Kaelor9/EngineLink/hardware/README.md

# EngineLink hardware

The original editable **KiCad 8 schematic and PCB project** is now under [`hardware/kicad/`](kicad/README.md).

- [PCB design](kicad/ESP32-S3-WROOM-1-N8R8.kicad_pcb)
- [Electrical schematic](kicad/ESP32-S3-WROOM-1-N8R8.kicad_sch)
- [Project settings](kicad/ESP32-S3-WROOM-1-N8R8.kicad_pro)
- [Design rules](kicad/ESP32-S3-WROOM-1-N8R8.kicad_dru)
- [Interactive BOM / assembly viewer](kicad/bom/ibom.html)
- [Source checksums](kicad/SHA256SUMS.txt)

See [hardware documentation](../docs/HARDWARE.md), [schematic audit](SCHEMATIC_REVIEW.md) and [Gerber/PCB audit](PCB_GERBER_REVIEW_2026-11-05.md).

**Status:** Imported unchanged from the owner's ZIP on 2026-11-10. Original native files are available for inspection by Claude and other contributors. The files have **not** been subjected to a new independent KiCad ERC/DRC validation. Historic Gerber review does not guarantee manufacturing readiness. Do not fabricate a new revision without verifying the PCB, BOM, stackup, isolation and production outputs.
