Kaelor9/EngineLink/docs/STATUS.md

# Status and safety

EngineLink is alpha firmware on a revision 1 board. This page lists what has
been checked on real hardware, what has not, and the rules for connecting it
to engines.

## Safety rules

- Disconnect the engine networks and NMEA 2000 during first flashing and bring-up.
- Measure both isolated 5 V supplies against their own isolated grounds
  (4.75–5.25 V) before connecting an engine.
- EngineLink only listens at every boot. Reading the engines (KAD polling) is a
  deliberate step: close the connector's solder jumper (SJ1/SJ2) and switch it
  on under Settings → Diagnostics. "Read engines automatically" is off until
  you turn it on, with a confirmation.
- The only message EngineLink can send is the KAD read request
  `01 43 21 <index hi> <index lo> <checksum>`. There are no commands, no fault
  code clearing and no ECU programming, and there is no free-form transmit
  endpoint.
- Do not poll while a Volvo diagnostic tool (VODIA) is connected.
- Change the factory Wi-Fi password `12345678` in Settings. Anyone with the
  Wi-Fi password (or on the boat router's network) can change settings; there
  is no separate admin login. Up to 0.16.5 every response also carries
  `Access-Control-Allow-Origin: *`, so a web page open in your browser could
  read EngineLink data or send it commands; the 0.16.6 development build
  closes that (plan section 6.9) without adding a login (built, not yet
  tested on the board).

## Checked on the board

**2026-11-14 — the slow link was a busy channel; 0.17.5:** two ESP32 modules and three firmwares were slow on channel 6 and fast on channel 1 at −39 dBm (0.45 → 5.58 Mbit/s). **0.17.5** lets the own Wi-Fi pick the quietest of 1/6/11 by measuring other networks' air time, and re-checks with no phone joined ([plan section 19](WIFI_PLAN_2026-11-09.md)). On the board: Standalone chose channel 1 and gave 212 → 562 kB/s in 30 s; router mode on the home router (channel 1) ran 26 min with 784/784 pings and 1173 requests without a failure. *Bench-verified*, not boat-verified.

**2026-11-10 (night) — Standalone varies with the time since power-on; 0.17.4:** 0.17.3 (0.17.1's firmware) in Standalone after a cold power-on, no USB: 54–121 kB/s a minute after the start, 195–477 kB/s four minutes later; the same code gave 580–730 kB/s earlier the same day; memory fine. So the board's link changes by itself, also without the router. **0.17.4** adds the chip's temperature to the report (per speed test and per 30 s of a router session) to see whether speed follows it ([plan section 17](WIFI_PLAN_2026-11-09.md)). *Built*, not run on the board.

**2026-11-10 (night) — 0.17.2 on the board, 0.17.3:** 0.17.2 ran out of internal memory on the board (Standalone, 87 s: lowest free 0 KB, 109 failed allocations, 161–462 kB/s instead of about 650). Its PSRAM change is removed; **0.17.3 is 0.17.1's firmware** ([plan section 16](WIFI_PLAN_2026-11-09.md)). Router mode on the home router: joins from a clean start and stays, but slow (0.17.1); not fixed.

**2026-11-10 (night) — 0.17.1 on the board, 0.17.2:** 0.17.1 joined the home router 1.9 s after its start, **showed the app on the PC and was still joined after 654 s** (first time on that router), but answers from the router took 441–770 ms on average and the speed test and report page hung. **0.17.2** keeps the Wi-Fi's packet buffers in internal memory by taking all PSRAM for EngineLink's own pool at start ([plan section 15](WIFI_PLAN_2026-11-09.md)); whether PSRAM is the cause is not proven. ***Built*, not run on the board; internal memory headroom is unmeasured.**

**2026-11-10 (late) — 0.17.0 on the board, 0.17.1:** 0.17.0 on the home router joined in 376 ms at −40 dBm, answered 10 of 15 pings in the first 30 s and almost none after, delivered small answers in 3–6 ms and never the app page, and lost the beacons 305 s after the join (rc3 and rc6: 302 and 306 s). **0.17.1** restarts when the router is chosen, so the join happens straight after a start as in the owner's sketch, and the report says more per session ([plan section 14](WIFI_PLAN_2026-11-09.md)). ***Built*, not run on the board; the router is not fixed.**

**2026-11-10 — 0.17.0 released as a test version (owner's decision):** content = rc7, so that builds can be installed with the web installer. Not verified on the board; router mode on the home router is not fixed. The owner reports the board checked for cold joints and current and voltage on the oscilloscope during the day's tests with nothing wrong, so the IC5 suspicion below is not supported by measurement.

**2026-11-10 (late evening) — bench sketch on the board and 0.17.0-rc7:** a sketch without any EngineLink code (`tools/wifi-bench`) on the home router: 117 of 117 pings and the 110 KB page in 1.8 s at first, the same page in 15–16 s after 10 minutes at the same signal; the 802.11g-only variant flashed right after was nearly dead in 30 s. So the degrading link is not caused by EngineLink's code, the core version, PSRAM or 802.11n. Open suspicion: the 3.3 V regulator IC5 when warm (never measured under Wi-Fi traffic). **0.17.0-rc7** keeps rc5's station and lets a send wait 30 s instead of 5 s, so a slow link delivers the app page ([plan section 13](WIFI_PLAN_2026-11-09.md)). ***Built*, not run on the board; the router is not fixed.**

**2026-11-10 (evening) — rc6 on the board:** failed like rc3 ([evidence](test-evidence/wifi-0170rc6-2026-11-10/README.md)): joined in 593 ms at −40 dBm, small answers through the router in 3–8 ms, the 110 KB page failed 5 of 5, 30 of 153 pings answered and none under 10 ms, beacons lost after 306 s. Core version and PSRAM are cleared. The owner's sketch has only been tested with one small answer, so nothing tested separates it from EngineLink yet; `tools/wifi-bench` (large page + counted pings, optional 802.11g) is the next test ([plan section 12](WIFI_PLAN_2026-11-09.md)). **The router is not fixed.**

**2026-11-10 (late afternoon) — rc5 on the board and 0.17.0-rc6:** rc5 timed out from the PC on the home router (no report sent). The owner's sketch also works with OPI PSRAM (joined as `192.168.0.2`, page opened), and it was built with ESP32 core **3.2.0**, EngineLink with 3.3.12. **0.17.0-rc6** is rc5 built with core 3.2.0 ([plan section 11](WIFI_PLAN_2026-11-09.md)). ***Built*, not run on the board; the router is not fixed on this evidence.**

**2026-11-10 (afternoon) — rc4 on the board, the owner's sketch, and 0.17.0-rc5:** rc4 on the home router ([evidence](test-evidence/wifi-0170rc4-2026-11-10/README.md)) never joined: 23 attempts in 30 s with codes 2/4/15, then 202, after which the ESP32 core stopped reconnecting and EngineLink stood idle for 90 s; the router was heard at −51/−62 dBm in two scans; Standalone 566–682 kB/s. **Then the owner ran a plain Arduino sketch on the same board (`WiFi.mode(WIFI_STA)`, `WiFi.setSleep(false)`, `WiFi.begin()`, mDNS, `WebServer`) and the PC opened its page at `http://enginelink.local` through the home router** ([evidence](test-evidence/wifi-sketch-2026-11-10/README.md)): the board and that router can work together (one small page, briefly; not a stability test). **0.17.0-rc5** makes the station exactly that sequence and removes rc4's own radio settings and decisions ([plan section 10](WIFI_PLAN_2026-11-09.md)). ***Built* (local ESP32-S3 compile, host tests, source checks), not run on the board; the router is not fixed on this evidence.**

**2026-11-10 (midday) — rc3 on the board and rc4 as built:** 0.17.0-rc3 was run on the home router ([evidence](test-evidence/wifi-0170rc3-2026-11-10/README.md)): negotiated 802.11n **40 MHz** on channel 1 at −47 dBm with power save off, **3 of 152 pings to the router answered**, 10 web requests through the router answered by the server (the last at the moment the final 152 s of lost pings began), beacons lost after 302 s, a scan 10 s later heard 3 other networks and not the router; Standalone 550–720 kB/s. Found and fixed in **0.17.0-rc4** ([plan section 9](WIFI_PLAN_2026-11-09.md)): rc3 switched to the own Wi-Fi at once on a loss instead of after 2 minutes (a race), held the engine lock 1645 ms during a driver mode change, and recorded a wrong end code. rc4 puts the station on 20 MHz (Espressif's recommendation near other networks), tries 802.11g after a poor 802.11n session, leaves a dead "connected" link after a minute, and records every session, request and a radio sample. ***Built* (local ESP32-S3 compile, host tests), not run on the board; the router is not fixed on this evidence.**

**2026-11-10 (morning) — rc3 as built:** 0.17.0-rc2 was run on the home router on 2026-11-09 ([evidence](test-evidence/wifi-0170rc2-2026-11-09/README.md)): IP in 2 s at −47 dBm, the page still timed out from the PC, beacons lost by itself after 409 s; Standalone 577–689 kB/s. The whole chain was then reviewed ([plan section 8](WIFI_PLAN_2026-11-09.md)): the web server, its checks, routing, tasks and mDNS show no fault; the other device's packets do not arrive (below HTTP). Found in the source: rc2's first session ran with modem sleep on and later ones with it off; the stored RF calibration predates the IC5 repair. **0.17.0-rc3** turns station power save off in every session, renews the RF calibration once, accepts the router's DNS name, and makes EngineLink measure the link itself (pings to the router, HTTP through the router, a scan after a loss): ***built* (local ESP32-S3 compile and host tests), not run on the board; the router is not fixed on this evidence.** One 15-minute router session reads out as in plan 8.5.

**2026-11-09 — earlier state:** the last owner test (CI [run #261](https://github.com/Kaelor9/EngineLink/actions/runs/42631425052), `75faba4`, 0.16.6 built Nov 9 14:08:09, after the IC5 solder repair) showed Standalone serving the app at 540–746 kB/s while Router mode on the home 4G router associated, got `192.168.0.2` and then served nothing (pages and pings time out), lost the router's beacons after 539 s and did not see the router for 2 min ([evidence](test-evidence/wifi-0166-2026-11-09/README.md)). The review and the new plan are in [WIFI_PLAN_2026-11-09.md](WIFI_PLAN_2026-11-09.md); **0.17.0-rc2 implements it: *built*, not yet run on the board** (rc1 was bench-tested the same afternoon: standalone fine, the home router answered neither auth nor association requests, reasons 2/4/15, so rc2 runs the station on the driver's defaults exactly as the Prism controller, plan 2.2 revision 2). Verification is one bench session (plan section 5) that also separates the router, the place and the board, then the boat.

| Area | Result |
|---|---|
| J1708 receive | Bench loop: 36,000 frames in 30 minutes without errors |
| Both KAD300 engines | Read on the boat: rpm, fuel rate, temperatures, boost, battery voltage, gear learned |
| Fuel figures | First fill-ups within about ±8 % before calibration |
| microSD, status LED | Bench tested |
| Own Wi-Fi (standalone) | **Not usable on the boat with 0.16.5 (2026-11-05).** Phones join and get a DHCP lease in every boot, but the link EngineLink → phone fails: in four boots no TCP connection from the phone reached the web server at all, the AP logged the phone leaving with code 2 eight to ten times in a row followed by code 209 (SA Query unanswered), the phone re-asked DHCP, and the two speed tests that completed gave 60–72 kB/s at 215–307 ms. Seen on boat 12 V, on USB only, and worst with both (a power-on reset occurred when 12 V was connected while on USB). The main loop blocked 5.6–10 s in the web part each time (the core's write retry, a consequence, not the cause). Earlier: about 650 kB/s on 0.13.4 (2 Nov), 265–346 kB/s at 91–99 ms on 0.15.0 (4 Nov, USB). Cause open: RF environment (router channel), power path, firmware AP settings dropped in 0.16.2, or board. The 2026-11-06/09 bench runs after the IC5 solder repair served the app at 540–1 105 kB/s on the own Wi-Fi; the boat is not re-tested yet. |
| Router mode | Zyxel EX3600 (WPA2/WPA3 mixed): previously 500–630 kB/s on free channel. Field report [#126](https://github.com/Kaelor9/EngineLink/issues/126), v0.13.4: 12 test average 584.6 kB/s (457.8–665.3), round trip 18–20 ms. Still 95 Wi-Fi disconnect events / 48 pre-connection failures and about 50 seconds reconnecting, so long-term stability is NOT verified. 0.16.2 replaced the Wi-Fi with a simple version. 0.16.6 on the bench router (reported 2026-11-08): joins with IP at −42 dBm, small answers work, the app page (110 KB) fails after 20.5 s; 0.16.2 had dropped the station's 20 MHz and beacon-timeout settings, restored in the third 0.16.6 bench build; the owner's test of that build (2026-11-08) failed worse: `/`, `/api/live` and `.local` timed out, 1 of 10 pings answered, no report of the running build. Cause open (plan 13.6.1: EngineLink left the router, or stayed on it with heavy frame loss); the fourth bench build makes the report and SD log record which (*built*); the A/B idea was dropped. 2026-11-09 (`75faba4`, driver defaults with modem sleep on): association and IP, no page, no ping, beacons lost after 539 s. **0.17.0-rc2** (station on the driver's defaults as the Prism controller; the app page as a long transfer; dead Wi-Fi 2.0 code removed) is *built*; rc1's station profile (power save off, country DK, 20 MHz, all-channel scan) was bench-tested on 2026-11-09 and failed the same way (reasons 2/4/15); the one bench session in [WIFI_PLAN_2026-11-09.md](WIFI_PLAN_2026-11-09.md) section 5 decides between firmware, router, place and board. **rc2 on the board (2026-11-09 evening):** IP in 2 s, page timed out, beacons lost after 409 s. **rc3 on the board (2026-11-10):** 40 MHz negotiated, 3 of 152 pings answered, beacons lost after 302 s. **0.17.0-rc4** (station at 20 MHz, 802.11g after a poor session, dead-link exit; plan section 9) on the board (2026-11-10): never joined, codes 2/4/15/202. **A plain Arduino sketch on the same board served a page through that router (2026-11-10).** **0.17.0-rc5** (the sketch's station, rc4's radio settings and decisions removed; plan section 10) is *built*, not run on the board. |
| Firmware updates | Over Wi-Fi from GitHub and from a file, with rollback |

## Not yet checked

- Why the own Wi-Fi's downlink to the phone fails on the boat with 0.16.5 (2026-11-05): not yet separated between RF environment, power supply, the AP radio settings 0.16.2 dropped (20 MHz bandwidth, country, inactive time) and the board itself. Superseded by [WIFI_PLAN_2026-11-09.md](WIFI_PLAN_2026-11-09.md): the IC5 repair restored the own Wi-Fi on the bench; the boat is re-tested in plan section 5.5. Wi-Fi 2.0 Stage 4 (state machine, AP+STA) is dropped. The 5–10 s web stall is explained (Arduino core `NetworkClient::write()` retrying 10 × 1 s against a phone that does not acknowledge); the plan removes it by moving HTTP to `esp_http_server` (its own task) instead of patching the write. Firmware is reported as *built* (CI green, untested on hardware), *bench-verified* (owner ran plan section 5.2–5.3) or *boat-verified* (5.5 passed); this table says "verified on the board" only for the last.
- **0.16.6 development build (Wi-Fi 2.0 Stages 1–3): *built*, partially exercised on hardware (not yet fully bench-verified or boat-verified).** CI-equivalent checks pass locally (pinned core 3.3.12 compile, host tests `test_tracefold`, `test_httputil`, `test_wifistate` with plan 9.3's 20 scenarios, `test_wifi_contract.py`). The owner's 2026-11-06 bench tests exercised the access point radio settings (20 MHz, 600 s, country DK), the HTTP server, OTA boot confirmation, and three security responses (200/421/403); the remaining Stage 2 bench acceptance, including upload failure paths, complete export regression and latency checks, is still open. Evidence: [v0.16.6 owner bench report](test-evidence/wifi-0166-2026-11-06/README.md). (`docs/releases/v0.16.6.md`, plan 9.1/9.2). Not merged, not released. The 2026-11-06 fixes (engine lock let go during SD card work, 503 causes) ran on the board on 2026-11-08/09 without new stalls (longest engine wait 79 ms). **Hardware (2026-11-09):** a cold solder joint on IC5 (pins 5–8) was found and repaired; the 3.3 V rail and the own Wi-Fi's throughput were normal afterwards. It does not explain the router failures, which look the same before and after the repair.
- Router mode with the simple Wi-Fi (since 0.16.2) is not verified (see the router row: the app page failed on the bench router, fix *built*); it could not be tested on 2026-11-05 because the standalone link was already unreliable. The owner supplied Rigol DHO804 scope captures of 3.3 V under USB and laboratory input during Wi-Fi activity; no severe voltage collapse was demonstrated in those captures. The isolated maximum ripple reading is uncertain due to probe contact and dissimilar timescales. Combined USB+12 V interaction and full boat power/RF tests remain unmeasured; see [owner bench report](test-evidence/wifi-0166-2026-11-06/README.md).
- Long-term router stability across automatic router channel changes; #126 shows recovery after an outage but not why it occurred.
- Whether the small Trip summary CSV fix in PR #123 resolves Chrome/iPhone download failures.
- Whether retained crash history reflects any new crashes during extended v0.13.4 operation.

- KAD reply layout for every value: verified for the values above, not for all
  indexes ("Discover more values" should be re-run).
- Status bits in values 263/264 are not decoded yet. The gear and compressor bits are learned per boat by the drive test (0.14.0); their meaning is a hypothesis (see KAD300 / EDC I).
- Gear and clutch timing (0.14.0): checked against two recorded trips (replayed on a PC), not yet on the boat with the faster gear readings.
- Fault codes: no read command found among the PC tool's commands; "Discover more values" now covers 256–447.
- Fuel factor confirmed tank to tank.
- NMEA 2000 interface: isolation, termination and traffic not validated. Do not
  enable it until verified. 0.16 decodes navigation, depth, log, heading,
  temperatures, battery, rudder, wind and tanks, and lists every device on
  Diagnostics › GPS · NMEA 2000 › Devices and data. "Record the bus" saves every raw frame
  (10/30 min, /NMEA/BUS.CSV) to map everything the boat sends. Owner's boat:
  SmartPilot X10 and AIS700 on SeaTalkNG; ST60 is SeaTalk1, no converter seen.
  Not yet tested on the boat.
- Behaviour after a sudden power cut during SD writes.
- No battery-backed clock: without phone, router or GPS time, logs use uptime.

See also [KAD300 / EDC I](KAD300_EDC1.md), [engine test procedure](ENGINE_TEST.md)
and [hardware](HARDWARE.md).
