Kaelor9/EngineLink/docs/WIFI_PLAN_2026-11-09.md

# Wi-Fi plan, revision 2026-11-09 (replaces `docs/WIFI_REWRITE_PLAN.md`)

Status: **section 17 (2026-11-10 night) is the current state: Standalone's
speed also varies with the time since power-on; 0.17.4 adds the chip's
temperature to the report. Network code = 0.17.1.** Sections 1–9
stay as background; where section 10 differs, section 10 applies (it removes
rc4's link-check decisions, radio sample and scans of section 9). Written
after the owner's request of 2026-11-09 to re-examine the Wi-Fi 2.0
architecture from the evidence instead of continuing the stage plan. It supersedes `docs/WIFI_REWRITE_PLAN.md`
(branch `claude/wizardly-lovelace-v6tlqz`, draft PR #160) wherever the two
differ; the old plan stays in git history as background only.

Sources checked: the PR #160 source at `016bd16` (`wifi.ino`, `httpd.ino`,
`netsvc.ino`, `netreport.ino`, `wifistate.h`, `EngineLink.ino`), Arduino
ESP32 core **3.3.12** (`libraries/WiFi/src/STA.cpp`, `WiFiGeneric.cpp`),
ESP-IDF **release/v5.5** (`esp_wifi.h`, `esp_wifi_types_generic.h`, the
*Wi-Fi Driver* guide for ESP32-S3), the device reports #95, #126, #141, #143,
#162 and the bench evidence of 2026-11-06, 2026-11-08 and 2026-11-09.

---

## 1. What the evidence says

### 1.1 Every router session, side by side

| Date / firmware | Router | Channel, signal | Station settings | Result |
|---|---|---|---|---|
| 2026-11-02, 0.13.1 (#95) | home 4G router, 192.168.0.x | ch 6, −68 dBm | PS off, HT20, beacon timeout 20 s, TX 19.5 dBm | not found for 120 s after power-on; joined at 311 s; session ended as "router lost" |
| 2026-11-02, 0.13.4 (#126) | boat router (Zyxel), 192.168.1.x | ch 11, −39 dBm | same | 80 min online, 584 kB/s, one ~50 s outage (beacon loss → 201 ×N → back by itself) |
| 2026-11-04, 0.15.0 (#141, #143) | boat router | ch 11, −48 dBm | same | pings 1–3 ms, 0 % loss, 490–600 kB/s, 0 disconnects |
| 2026-11-06, 0.16.6 build 1/2 (#162, `ROUTER.txt`) | home 4G router | ch 1, 20 MHz negotiated | **PS off**, driver defaults | +69 s IP; EngineLink itself posted #162 to GitHub over HTTPS at +122 s; small replies to the PC worked, `/` (110 KB) failed; **beacons lost at +1174 s**, then 49 × 201 for 116 s, fallback |
| 2026-11-08, build 3 | home 4G router | ch 1, −42 dBm | PS off, HT20, beacon timeout 20 s | IP, but 1 of 10 pings answered, PC's ARP unanswered, every page times out |
| 2026-11-09, `75faba4` | home 4G router | ch 1, −59 dBm | **PS on (MIN_MODEM)**, driver defaults | not found for 118 s at boot; later associated in 422 ms, IP in 1.7 s, **no page, no `/api/health`, no ping** from the PC; **beacons lost 539 s after the IP**, 49 × 201 for 116 s, fallback |

Two facts stand out:

1. **Router mode has worked on this board**, for hours, on the boat router
   (0.13.4 and 0.15.0: station power save off, HT20, 20 s beacon timeout).
2. **On the home 4G router no build has ever served the page**, with power
   save on or off, with HT20 or the driver's default, with or without the WPA3
   wrapper and the TCP window patch. Every session there ends the same way:
   the station stops receiving (ARP/ping/TCP from the PC lost, beacons lost,
   reason 200), then 49 full scans in two minutes do not see the router at all,
   while the own Wi-Fi started right after hears the phone at −40 dBm, and the
   next attempt later finds the router in under a second.

### 1.2 Why the router link is obtained but HTTP does not work

Association and DHCP are short exchanges that the station starts itself. The
HTTPS report #162 (TLS handshake with GitHub, several kilobytes **received**)
proves that on 2026-11-06 the station's own TCP traffic worked through that
router at +122 s. What fails is traffic that **another device starts**: the
PC's ARP request, ICMP echo, TCP SYN. On 2026-11-08 one ping in ten was
answered; on 2026-11-09 none. A request that never reaches lwIP produces a
browser timeout, exactly what the owner saw (`ERR_CONNECTION_TIMED_OUT`, not
a refused connection and not a 421/403 from the server's own checks).

Nothing in the firmware can produce this selectively:

- `esp_http_server` binds `INADDR_ANY` and is started once (`httpd.ino:220`);
  it answers 1 676 external requests in the same boot in standalone mode and
  the loopback self-test passes in router mode. Its Host/Origin checks answer
  421/403; they cannot cause a timeout.
- lwIP routes replies on the interface that received the request; the idle AP
  netif (192.168.4.1) does not interfere with 192.168.0.x.
- No scan, mode change or driver call runs in router mode except
  `esp_wifi_sta_get_ap_info()` every 2 s (`wifi.ino:249`), which is a local
  read. The main loop's longest pass was 111 ms; the web server runs in its
  own task. There is no concurrency or timing path that drops received frames.

The one setting in `75faba4` that **does** match the symptom is modem sleep:
`WiFi.setSleep(true)` (`wifi.ino:197`, commit `b3ed536`), confirmed by
`"powerSave":1` in the report. `esp_wifi.h` says the default is
`WIFI_PS_MIN_MODEM`; the Wi-Fi guide says reception is then delayed to the
DTIM cycle, and `WIFI_PS_NONE` "minimizes the delay in receiving Wi-Fi data".
Espressif issue 12454 shows precisely "got IP, unreachable, `bcn_timeout`"
under `WIFI_PS_MIN_MODEM`. Modem sleep is therefore a real defect of the latest
build for a device that must answer unsolicited requests. **But it is not the
whole cause**: 2026-11-06 and 2026-11-08 failed with power save off.

### 1.3 Why the station later loses beacons

Per the Wi-Fi guide ("Wi-Fi Beacon Timeout", ESP32-S3): if no beacon arrives
within the inactive time (default 6 s, `esp_wifi_set_inactive_time()`), the
station sends 5 probe requests; with no answer it disconnects with reason 200.
So reason 200 means **the station heard nothing from the router for about
6–8 s**, at −59 dBm (2026-11-09) and −42 dBm (2026-11-08): not a weak-signal
value. The 49 × 201 that follow are the core's reconnect
(`STA.cpp:158–173`: `disconnect()` + `connect()` after every failure, a full
scan each ~2.4 s) finding **no beacon or probe response from that router on
any channel for two minutes**, until the 120 s fallback starts the own Wi-Fi.
The same two-minute blindness appears at power-on (#95 and 2026-11-09) and
ended both times by itself.

Scanning runs with the radio awake, so power save cannot explain the two
minutes. No firmware activity runs during them either. What remains is below
the firmware's logic: the radio downlink from that router to this board at
that bench. Three candidates are consistent with all sessions:

- **R1, the router's 2.4 GHz radio**: a 4G router (TP-Link Archer MR600,
  dual band) whose 2.4 GHz radio restarts, moves channel (auto) or is held
  back by LTE/Wi-Fi coexistence, while the PC and the iPhone stay on 5 GHz
  and notice nothing. The owner has not yet checked which band the PC uses.
- **R2, the place**: interference at the board's position on channel 1 (the
  4G router's own LTE uplink bursts next to 2.4 GHz, USB 3.0 noise from the PC
  the board was attached to, or a neighbour). Time-varying, so sessions differ.
- **R3, the board's receive path**: a sensitivity loss (antenna matching, RF
  keepout, a supply transient under receive) that −40 dBm from a phone a metre
  away hides and −59 dBm from a router does not. The IC5 repair restored the
  3.3 V rail and standalone throughput; it says nothing about receive margin.

None of these is a firmware fault, and no firmware change can repair any of
them. Section 5 shows how one bench session tells them apart without a single
extra firmware build.

### 1.4 Firmware defects found (real, but secondary)

| # | Defect | Where | Effect |
|---|---|---|---|
| F1 | Modem sleep on in router mode | `wifi.ino:197` | Delayed or missed unsolicited frames; a documented cause of unreachable stations (1.2) |
| F2 | Country set only when the AP starts; the station runs in world-safe "01" after a boot straight into router mode | `wifi.ino:118–123` only in `apRadioSetup()`; `applyNetwork()` resets the driver with `WiFi.mode(WIFI_OFF)` (`WiFiGeneric.cpp:319–331` deinitialises it) | A Danish router on channel 12 or 13 is found slowly or not at all; the PHY init data differs between the two modes |
| F3 | Report prints the 3-byte country code as a C string | `netreport.ino:242`, `wifi.ino:115` | The `DK ?\x01\x06\x14\x01` garbage in every report (stack over-read, harmless otherwise) |
| F4 | `wifistate.h` state machine (Standalone / Router test / Router join / Router / Router lost, AP+STA idle station, "looks", return tests) built and host-tested but never wired in | `wifistate.h`, `tools/test_wifistate.cpp`, plan Stage 4 | Dead code and a planned architecture (AP+STA, channel-switch announcements to joined phones) that addresses none of the observed failures and adds risk |
| F5 | Leftovers of 0.15.0: `netpolicy.h`, `routerguard.h`, `linktune.cpp/.h`, `routerProbing`, `staRetryFails`, `driverNudges`, `staBssidKnown` and the "Rescue looks" report block, all unused or always 0 | `EngineLink.ino`, `webapi.ino`, `netreport.ino` | Noise in the report and the code the owner asked to keep simple |
| F6 | The report calls the fallback "Recovery" and the JSON `mode:"rescue"`, as if it were a third mode | `netreport.ino` | Contradicts the two-mode product; the mechanism itself is right |
| F7 | 110 KB app page sent from the single server task in one `httpd_resp_send()` | `httpd.ino` (plan I9, left open) | On a lossy link one stalled `/` blocks every other request for up to the send timeout; explains "small replies work, `/` fails" on 2026-11-06. Not a cause of the link failure |

Not defects (checked and cleared): the `esp_http_server` configuration and
adapter, the engine mutex discipline (server task releases it around every
send), the main-loop timing, mDNS (its failure on the PC is a consequence of
the lost downlink; it starts correctly 2 s after each IP), the OTA self-test
(a loopback request confirms the image, so a bad router link cannot trigger a
rollback), the 120 s fallback and 10 min return logic.

---

## 2. Decision

### 2.1 Architecture

- **Keep** the Arduino core 3.3.12 build with Espressif's components used
  directly (`esp_wifi`, `esp_netif`, `esp_http_server`, `mdns`, OTA). The
  server rewrite works and is not part of the problem.
- **Keep two user-selectable modes only**: Standalone (AP only) and Router
  (STA only). The automatic fallback to the own Wi-Fi after 120 s without an
  IP, and the automatic return while no phone is joined, stay **as a recovery
  mechanism**, named so in the report and the app, never as a mode.
- **Drop Wi-Fi 2.0 Stage 4** as designed: no `WIFI_AP_STA` idle station, no
  router test with the AP up, no periodic "looks", no `wifistate::Machine`.
  The simple exclusive-mode `wifi.ino` of 0.16.2–0.16.6 is the right size for
  the product; its only shortcoming is the station profile (F1–F2).
- **Station = the ESP32 driver's defaults, as the Prism controller** (2.2,
  revision 2). No setting on the station interface at all. No linker
  wrappers, no private lwIP, no custom SAE.

### 2.2 The station: the Prism controller's connection path (revision 2, 2026-11-09 evening)

**Why revised.** The rc1 bench report (built 15:37:56) on the home 4G router:
49 × 201 at boot, then after the app's Connect about 24 × reason 2
(AUTH_EXPIRE: auth request sent, no answer), 6 × reason 4 (association
request sent, no answer), 2 × 15 (EAPOL 3/4 never arrived), 1 × 202. Per the
Wi-Fi guide's connect phases every one of these is "EngineLink sent, the
router's answer never arrived". The owner reported that the Prism controller
(`Kaelor9/Marine-RGB-Light-Controller`, the same ESP32-S3-WROOM-1-N8R8
module, Arduino core latest at build time) joins the same router without
trouble, and asked for Prism's connection method in router mode.

**Comparison on the actual code** (Prism `connectWiFi()`/`setup()`/`loop()`;
WiFiManager 2.0.17 `autoConnect` → `connectWifi` → `wifiConnectDefault` →
`WiFi.begin()` → `waitForConnectResult`; EngineLink `applyNetwork()`,
`serviceNetwork()`, `onWiFi()`):

| Step | Prism (effective, after WiFiManager) | EngineLink rc1 | rc2 |
|---|---|---|---|
| Init | `WiFi.mode(WIFI_STA)`, `setHostname`; WM turns Wi-Fi **OFF** again (hostname branch) and `enableSTA(true)` | `WiFi.mode(WIFI_OFF)`, `persistent(false)`, `setHostname`, `WiFi.mode(WIFI_STA)` | same in effect, kept |
| Country | `WiFiSetCountry()` skipped (`_wificountry==""`): driver default "01" | `esp_wifi_set_country_code("DK",true)` on the station | **removed on the station**; the AP keeps DK |
| Power save | driver default `WIFI_PS_MIN_MODEM` | `WiFi.setSleep(false)` | **removed** |
| Bandwidth, scan | driver defaults (40 MHz allowed, fast scan) | HT20 + `WIFI_ALL_CHANNEL_SCAN` | **removed** |
| Credentials | `persistent(true)` only when saving; `WiFi.begin()` uses the driver's NVS config | `persistent(false)`, `WiFi.begin(ssid,pass)` from EngineLink's settings | same for the driver (`esp_wifi_set_config` + `connect`), kept |
| Reconnect | the core's (`setAutoReconnect(true)`) | the core's | same, kept |
| Events | WM's `WiFiEvent` (status only) | `onWiFi()` (counters/trace only, no Wi-Fi calls) | same in effect, kept for the report |
| Waiting for an IP | blocking 10 s (`setConnectTimeout`), else portal → `ESP.restart()` | non-blocking in `serviceNetwork()`; 120 s without an IP → own Wi-Fi (recovery), retry every 10 min | **not transferred**: EngineLink must not block engine reading or restart; recovery kept |
| mDNS | `MDNS.begin` once after the IP | `startNameService()` 2 s after GOT_IP, restarted on a network change | same in effect, kept |
| Web server | Arduino `WebServer` after the IP, `handleClient()` in the loop | `esp_http_server`, started once, all interfaces | kept (one server in both modes) |
| While connected | nothing polls the driver | `esp_wifi_sta_get_ap_info()` every 2 s | **removed**; the signal is read only when a report or the app asks |
| Standalone | WM captive portal | EngineLink's SoftAP, `apRadioSetup()` | unchanged |

Transferred: the bare driver defaults on the station, nothing polling the
driver while it connects, the core's reconnect, mDNS after the IP. Not
transferred: WiFiManager (portal, blocking wait, restart), NVS-stored
credentials (no RF effect), WM's event handler.

**Critical assessment.** The chance that this alone fixes the home router is
low: `75faba4` (2026-11-09 morning) already ran the driver's defaults with
modem sleep on and failed the same way. What rc2 gives is final: a router
path identical to a device known to work on the same module. If it still
fails identically, the firmware's connection path is excluded with
certainty and the board, its supplies or the place remain (section 5.4,
hardware path). If it works, one of the small differences mattered and the
code is simpler. Prism's core version is "latest at build time": if Prism was
built on core 2.x (IDF 4.4), the driver version is a real difference and one
EngineLink build on that core is the next software step.

---

## 3. Implementation plan (one build, in this order)

Branch: `claude/awesome-newton-sazag1`, which merged `claude/wizardly-lovelace-v6tlqz`
(PR #160) so the `esp_http_server`, OTA self-test, SD lock work and evidence
stay together.
Version string `0.17.0-rc1`, then `0.17.0-rc2` (revision 2 of 2.2), with the
build time in the report, so bench evidence can never again be attributed to
the wrong binary. rc2 replaces P1 below: `staRadioSetup()` is gone and the
STA branch is `WiFi.mode(WIFI_STA); WiFi.setAutoReconnect(true);
connectRouter();`; the 2 s signal polling is gone (`routerSignalSample()` in
`netreport.ino` reads `WiFi.RSSI()` on request).

| # | Change | Files | Acceptance (host/CI unless marked) |
|---|---|---|---|
| P1 | **Station profile.** New `staRadioSetup()` with the three calls of 2.2 and `WiFi.setScanMethod(WIFI_ALL_CHANNEL_SCAN)`; called in `applyNetwork()` right after `WiFi.mode(WIFI_STA)`, before `connectRouter()`. Remove `WiFi.setSleep(true)`. `apRadioSetup()` unchanged. | `wifi.ino` | `test_wifi_contract.py`: the four calls present in `staRadioSetup()`, called between `WiFi.mode(WIFI_STA);` and `connectRouter();`; `setSleep(true)` absent anywhere. Report line "Power save: off" in router mode (bench). |
| P2 | **Country once per driver start, both modes.** Move the `countryIsDK()` check into a helper used by both `apRadioSetup()` and `staRadioSetup()`; fix the buffer to `char cc[4]` in `wifi.ino`, `netreport.ino` and `ApLink` (`model.h:451`). | `wifi.ino`, `netreport.ino`, `model.h` | Report prints `Wi-Fi country (driver): DK` with no trailing bytes (bench). Contract: no `char cc[3]` in the firmware. |
| P3 | **Remove the dead Wi-Fi 2.0 Stage 4 and 0.15.0 leftovers.** Delete `wifistate::Machine` and `tools/test_wifistate.cpp` (keep `traceFold`, renamed `tracefold.h`, with its test); delete `netpolicy.h`, `routerguard.h`, `linktune.cpp/.h`, the link-tune task, `routerProbing`, `routerProbe*`, `staRetryFails`, `driverNudges`, `staBssidKnown`, `routerReturnFailed`, the "Rescue looks" and "Radio test" report blocks and their JSON fields (`linkTune`, `routerProbes`, `routerProbeSeen`, `retryFails`, `driverNudges`, `failedReason/Phase/AfterMs`). Update `validate.yml` accordingly. | `wifistate.h`, `tools/`, `EngineLink.ino`, `webapi.ino`, `netreport.ino`, `.github/workflows/validate.yml` | CI green; `wifi.ino` < 300 lines (`test_wifi_simple.py`); the app's network page still renders with the demo (`tools/build_demo.py`, Playwright). |
| P4 | **Name the recovery mechanism honestly.** Report `Mode: Router (router not reached, EngineLink Wi-Fi on meanwhile)` and JSON `mode:"router", recovery:true`; the app shows the same text where it now says Recovery/rescue. Behaviour unchanged: fallback after 120 s without an IP, return every 10 min while no phone is joined, "Connect" in the app forces a new attempt. | `netreport.ino`, `webapi.ino`, `firmware/ui/app.html` → `tools/build_ui.py` | `test_wifi_simple.py` keeps `120000UL` and `routerHold=true`; demo shows the new text; no new settings (D7). |
| P5 | **`/` as a long transfer.** Register `/` with `R_ASYNC` so the 110 KB page streams from the xfer task in chunks with `engineMx` released, and raise the xfer queue to depth 2 so a second phone loading the page is not refused. All other routes unchanged. | `webapi.ino`, `httpd.ino` | `test_wifi_contract.py`: `/` listed as a long transfer; `curl` of `/` and `/api/live` in parallel both complete (bench). |
| P6 | **Docs.** `HANDOVER.md` Wi-Fi section rewritten to the two modes + recovery + station profile (short); `docs/STATUS.md` router row = "bench pending 0.17.0-rc1"; `docs/TODO.md` Wi-Fi block replaced by a pointer to this plan; `docs/WIFI_REWRITE_PLAN.md` reduced to a one-paragraph pointer here; `docs/releases/v0.17.0.md` drafted. | docs | Links valid; no router name, token or password in any file. |
| P7 | **CI contract update.** `test_wifi_contract.py` adjusted to P1–P5 (drop the `staRadioSetup` prohibition and the `wifistate::Machine` checks; keep: no `lwip/priv`, no `__wrap_`, no `--wrap`, no `WiFi.`/`esp_wifi_` in the event callback, no secrets in prints, core pinned to 3.3.12). | `tools/test_wifi_contract.py` | Mutation check: re-adding `setSleep(true)` or removing the country call must fail the test. |

Estimated size: about 150 lines changed in firmware, about 600 lines removed.
No change to storage formats, calibration, trips, engine code, OTA or the
installer.

Rules for the implementer: one PR, no further A/B binaries, no new diagnostic
features beyond fixing F3, no station setting outside 2.2 without the owner's
written approval, D14 kept (no Wi-Fi call from the event callback, printing
never blocks).

---

## 4. The hardware finding

The IC5 cold joint explains the earlier 3.3 V and standalone-throughput
variability (65–1 048 kB/s before the repair, 540–1 105 kB/s after). It is
recorded as fixed in `docs/HARDWARE.md` and `docs/STATUS.md` (P6). It does
**not** explain the router failures: they look the same before and after the
repair, and the 2026-11-08 session failed at −42 dBm.

The plan therefore does not assume the board is cleared. Section 5 separates
the board from the router and the place in the same session that verifies the
firmware. If the board is implicated (outcome C below), the next step is
hardware work from `docs/HARDWARE.md` (antenna matching and keepout, a scope
on 3.3 V during a router session), not another firmware version.

---

## 5. Verification: one build, one bench session, then the boat

### 5.1 Before the session (owner, 5 minutes, no firmware involved)

1. On the Windows PC on the home router: `netsh wlan show interfaces` and
   note **Radio type, Band/Channel**. If the PC is on 5 GHz, its good
   experience says nothing about the 2.4 GHz radio EngineLink uses.
2. Router admin page, read only, no changes: 2.4 GHz channel setting
   (auto/fixed), channel width, whether Smart Connect / band steering, Airtime
   Fairness or AP Isolation are on, and the system log. Keep a screenshot.

### 5.2 The session (owner, about 40 minutes, firmware 0.17.0-rc2 from CI)

Board at its usual bench position, lab supply, **not** USB-attached to the PC
(USB 3.0 noise is one of the R2 candidates). Start these on the PC first and
leave them running the whole time:

```bat
ping -t 192.168.0.2 > ping.txt
```

```bat
:loop
echo %time% >> scan.txt
netsh wlan show networks mode=bssid | findstr /i "SSID BSSID Signal Channel" >> scan.txt
timeout /t 10 > nul
goto loop
```

Then in the app: Router mode, the saved home router. Within the first
5 minutes, from the PC: 20 × `http://192.168.0.2/api/live`, 10 × `http://192.168.0.2/`,
3 × `http://enginelink.local/`. Let it run to 30 minutes, then save the Wi-Fi
report and `/WIFI.LOG` from the SD card.

In the same session, as a control, put the Prism controller (another ESP32,
driver defaults) on the same router at the same spot and `ping -t` it from
the PC for 15 minutes.

### 5.3 Pass criteria (all required)

| Criterion | Pass |
|---|---|
| Pings to EngineLink | ≥ 99 of 100 answered in any 100-ping window |
| `/api/live` | 20 of 20 within 2 s |
| `/` | 10 of 10 complete within 5 s |
| `enginelink.local` | resolves on the PC (if Windows lacks mDNS, the IP checks count) |
| Report | 30 min, 0 unexpected disconnects (no reason 200), 0 fallbacks, `Power save: off`, country `DK`, `802.11n 20 MHz` |
| Standalone | unchanged: page loads, speed test ≥ 500 kB/s at −40 dBm |

### 5.4 Reading a failure (one session decides, no further builds)

| Outcome | What `scan.txt` and the Prism control show | Conclusion | Next step |
|---|---|---|---|
| A | The PC also lost the router's 2.4 GHz BSSID, or saw it change channel, around EngineLink's beacon loss; Prism dropped too | R1, the router's 2.4 GHz radio | Firmware is done. The owner decides about the router (it is the test case, not the target, D30); the boat test proceeds |
| B | The PC saw the 2.4 GHz BSSID steady on channel 1 at good signal; **Prism also** lost pings at that spot | R2, the place | Move the bench position once; firmware unchanged; boat test proceeds |
| C | The PC saw the BSSID steady; **Prism stayed at 100 %** while EngineLink failed | R3, the board | Stop firmware work. Hardware investigation per section 4 |
| D | Everything passes | profile + link fine | Boat test (5.5), then release 0.17.0 |

### 5.5 Boat (the real acceptance)

One trip with the boat router: the same criteria as 5.3 from the iPhone
(`/api/live` via the app, `/` three times, 30 min without a fallback),
plus one router power-cycle: reconnect within 60 s after the router is back,
no fallback when it returns within 2 min. Standalone checked once on the same
day. Release 0.17.0 only after this.

---

## 6. Out of scope (deliberately)

- No AP+STA concurrent operation, no router test while the own Wi-Fi is up,
  no "Router is back, switch now?" prompt (D19/D20 withdrawn with Stage 4).
- No new report fields, radio tests, channel surveys or link tuning.
- No changes to the router, its channel or security as a requirement.
- No change to the `esp_http_server` adapter beyond P5.
- No Option B (IDF project with Arduino as a component): the two exceptions
  that motivated it are gone.

## 7. Open risks

- If the bench ends in outcome C, the fix is hardware and its schedule is
  unknown; the firmware plan still stands as written.
- `WIFI_ALL_CHANNEL_SCAN` adds about one second to each join; with the core's
  reconnect that is one second per retry while a router is away.
- Windows mDNS varies by version; the IP must always work, the name is a
  convenience.

---

## 8. 2026-11-10: the whole chain reviewed after rc2, and 0.17.0-rc3

Owner's instruction (2026-11-10): stop planning, take over, examine the whole
chain from radio to web app, treat "the page opens" as the goal and not
"associated with an IP", and implement with documented APIs only. Evidence:
[rc2 report](test-evidence/wifi-0170rc2-2026-11-09/README.md).

### 8.1 The chain, layer by layer

| Layer | Checked | Result |
|---|---|---|
| Association, WPA2 | report: 319–876 ms, twice | works |
| DHCP | 1.6 s, `192.168.0.2`, lwIP's ARP check passed | works |
| EngineLink's own outbound IP | 2026-11-06: a report reached GitHub over HTTPS through this router | works |
| ARP from another device | 2026-11-08: Windows printed "Destination host unreachable" from its own address = its ARP request got no answer. lwIP answers ARP itself in its task, no EngineLink code is involved; the core also sends a gratuitous ARP every 60 s (`CONFIG_LWIP_ESP_GRATUITOUS_ARP=y`) | **fails intermittently: the request does not arrive** |
| ICMP | 2026-11-08: 1 of 10 answered, 18 ms | **fails** |
| IP routing | two interfaces, the own Wi-Fi's 192.168.4.0/24 is down in router mode; replies leave on the interface of the router's subnet | no fault found |
| TCP port 80 | one `esp_http_server` started once in `setup()`, bound to every address (`INADDR_ANY`), never stopped; a network change only closes sessions (`httpdSuspend()`); it serves the own Wi-Fi again after each router session in the same start, so the listener survives the changes | no fault found |
| HTTP checks | wrong `Host` → 421, foreign `Origin` → 403, POST without `X-EngineLink` → 403: all are **answers**; none can produce a timeout. 0 refused in the report | no fault found |
| Port 443 | nothing listens; lwIP answers a connection attempt with a reset at once | by design |
| mDNS | `MDNS.begin` 2 s after each IP, restarted on a network change; queries are multicast and travel like the ARP request | depends on the same reception |
| Tasks, locks | Wi-Fi task priority 23 and lwIP 18 on core 0; engine tasks 3–4 with a yield every pass; web server in its own task on core 1; longest main-loop pass 175 ms; the event callback makes no Wi-Fi call | no starvation path |
| Web app | never reached: the browser gets no TCP connection | not involved |

So the browser's timeout is **missing network traffic, not a missing HTTP
answer and not the web app**: frames from the router do not reach EngineLink's
IP stack reliably, while frames EngineLink asks for itself mostly do. The same
reception fails completely for 6+ s when the beacons are lost, and the 49
scans that follow hear nothing of that router for two minutes.

Why Standalone works and Router does not: in Standalone the phone is a metre
away, EngineLink sets the pace on its own channel (6) and every frame is
addressed and acknowledged. In Router mode everything another device starts
arrives via the router, first as a broadcast (ARP, mDNS) that the router sends
once, unacknowledged, at its lowest rate, right after a beacon. That is the
part of the link that is failing.

### 8.2 What was wrong in rc2 (found in the source, not guessed)

1. **The station's power save differed between sessions.** rc2 made no
   power-save call on the station, but the access point setup calls
   `WiFi.setSleep(false)`, the core stores it (`WiFiGeneric.cpp:784`) and
   applies the stored value at every station start (`STA.cpp:122`). A start
   straight into router mode ran modem sleep **on**; any session after the own
   Wi-Fi had been up ran it **off**. In the rc2 report the modem-sleep session
   lost the router by itself after 409 s (and the 2026-11-09 morning build
   with modem sleep on after 539 s); the session without ran 769 s until the
   owner switched the router off, and 1105 s on 2026-11-06. Too few sessions
   to prove a cause, but modem sleep makes a server depend on catching one
   specific beacon for every incoming packet, on a link whose beacons are the
   very thing being lost.
2. **The report's "Power save" and HTTP figures could not be attributed.**
   The power-save line was read in access point mode, and the HTTP counters
   mixed the router, the own Wi-Fi and the self-test. "4 send failures" and
   "slowest `/` 10.9 s" may be a page trickling over the router or sessions
   closed by a network change; rc2 cannot say.
3. **The RF calibration is older than the regulator repair.** The driver
   calibrates the radio in full once, stores the result and reuses it at every
   start ("partial calibration", Espressif's RF calibration guide). The stored
   data was made while IC5 had a cold solder joint and the 3.3 V rail was
   unstable. Updates over Wi-Fi keep it. Whether it is bad is unknown; it is
   the one radio input that was never renewed after the repair.
4. **`http://enginelink/` was refused.** Many routers register the DHCP host
   name in their own DNS, so the bare name (or `enginelink.lan`) resolves on a
   PC where `.local` does not; the `Host` check answered 421.
5. **CI's version check rejected `-rc2`** (`validate.yml` allowed letters only
   after the dash).

### 8.3 `http://` and `https://`

EngineLink serves HTTP on port 80 only, in both modes, and the address is the
same in both: `http://enginelink.local`. Nothing in the firmware or the app
redirects to or expects HTTPS. Current browsers try `https://` first for a
typed name and fall back to `http://` when port 443 is refused; EngineLink
refuses at once, so on a working link the fallback takes milliseconds. On a
link that drops packets the refusal is lost too, the browser waits out its
HTTPS attempt and the address bar keeps the `https://` it tried. That is the
most likely source of "it seemed to need https": the same lost packets, seen
through the browser's upgrade. A certificate for a local name is not possible
without warnings, so HTTPS on the device is not the conventional answer;
making the link carry packets is.

`.local` needs multicast between the PC and EngineLink. It fails when the
router isolates wireless clients (guest network, "AP isolation"), when a VPN
or firewall on the PC blocks UDP 5353, or when the link drops the multicast.
The IP address always works when the link does, and with 8.2 item 4 so does
the name the router's own DNS gives (`http://enginelink/` on routers that
register it). The report shows the last router IP for that purpose.

### 8.4 0.17.0-rc3 (implemented 2026-11-10)

| # | Change | Kind |
|---|---|---|
| R1 | Station power save **off** in every router session: `WiFi.setSleep(false)` right after `WiFi.mode(WIFI_STA)`. Everything else on the station stays the driver's default | fix (8.2 item 1) |
| R2 | The stored RF calibration is discarded **once** (`esp_phy_erase_cal_data_in_nvs()`, flag in NVS `el_radio/cal`), so the first start of rc3 calibrates in full on the repaired board. Settings and data untouched | fix on a hypothesis (8.2 item 3) |
| R3 | `Host`/`Origin` accept the board's name bare and with `.lan`, `.home`, `.home.arpa`, `.internal` (none can be registered on the internet, so the DNS-rebinding defence holds; host-tested) | fix (8.2 item 4) |
| R4 | **Link check:** while on the router EngineLink pings the router every 2 s (`esp_ping`, lwIP's documented API) and keeps sent/answered/average/longest/most lost in a row, with the signal at the start, lowest and last (read every 30 s) | measurement |
| R5 | **Router session record**, kept after the session and written to `/WIFI.LOG`: duration, end code, the router as the driver saw it (channel, 20/40 MHz, b/g/n, negotiated standard, ciphers), the station's real power save | measurement |
| R6 | **HTTP by network:** connections, requests, answers and failed sends that came in through the router, separate from the own Wi-Fi and the self-test | measurement |
| R7 | **One scan 5 s after a fallback:** networks heard, strongest other, the router heard or not | measurement |
| R8 | CI's version check accepts `-rc3` | CI |

New file `netdiag.ino` (R2, R4, R5, R7); it makes no call that changes how the
station connects (`test_wifi_contract.py` enforces this). Not changed: the two
modes, the 120 s fallback and 10 min return, the web server, the app, storage.

### 8.5 What one router session with rc3 decides

Router mode on the home router for 15 minutes, try the page from the PC a few
times (`http://enginelink.local`, then the IP), then fetch the Wi-Fi report
(on the router if the page opens, otherwise on the own Wi-Fi afterwards). No
ping scripts, no router settings. The block "ROUTER LINK AS ENGINELINK
MEASURED IT" then reads:

| Pings to the router | Through the router | Scan after a loss | Meaning | Next |
|---|---|---|---|---|
| ≥ 99 % answered, page opens | requests answered | – | fixed by R1/R2 | boat test (5.5) |
| ≥ 99 % answered | **0 connections** | – | link fine both ways, but the PC's packets never arrive: client isolation on the router, the PC on a guest/other network, or the PC itself | compare with a phone on the same Wi-Fi; no firmware cause |
| ≥ 99 % answered | connections, failed sends | – | small packets pass, a page does not: transfer problem on the link | look at the negotiated standard/40 MHz in the record |
| many lost, or runs of losses | few or none | router heard | radio link between this board and this router is bad in both tests of it | the two checks in 8.6 separate router from board |
| lost, then code 200 | – | **neighbours heard, router not** | the router's 2.4 GHz radio stopped answering; EngineLink's receiver works | router side; firmware done |
| lost, then code 200 | – | **nothing heard at all** | EngineLink's receiver is deaf at that moment | board (hardware), not firmware |

Not decidable without the session: whether R1 and R2 are enough on this
router. Green CI proves the build, not the link.

### 8.6 Two checks that need no firmware (5 minutes each, optional)

- **A phone hotspot as the router** (iPhone: "Maximise compatibility" on =
  2.4 GHz): EngineLink in router mode on the hotspot, the PC on the same
  hotspot. The page opening there shows the whole router-mode path of the
  firmware working (DHCP, ARP, mDNS, HTTP on the station) and leaves the home
  router's radio link as the difference.
- **Own Wi-Fi on channel 1** (the home router's channel) instead of 6, then
  the app's speed test: clearly worse than on channel 6 means channel 1 is
  bad at the board's place or for the board.

---

## 9. 2026-11-10: the rc3 report, what it proves, and 0.17.0-rc4

Evidence: [rc3 report](test-evidence/wifi-0170rc3-2026-11-10/README.md).
Owner's instruction: go to the bottom of it, fix what can be documented,
extend the report so that further hypotheses need no new firmware, and keep
documented faults, probable explanations and hypotheses apart.

### 9.1 What rc3 measured on the home router

One router session of 302 s (+278 s to +581 s), power save off, RF
calibration renewed, signal −47 dBm from the first reading to the last:

- **Negotiated 802.11n 40 MHz** (router on channel 1, second channel above,
  i.e. 2402–2442 MHz); pairwise CCMP, group TKIP (the router runs WPA/WPA2
  mixed).
- **3 of 152 pings to the router answered**, in 355–633 ms. The longest run
  of losses, 76 pings = 152 s, ends at the beacon loss, so it began at
  581 − 152 = **429 s**.
- **10 connections and 10 requests through the router**, the last at
  **429 s**; 9 answered 2xx, no failed send, slowest request of the whole
  start 112 ms.
- Code 200 at +581 s; a scan 10 s later hears 3 other networks (strongest
  −50 dBm) and not the router.

So the link was not "98 % random loss". It carried traffic in a window that
ended at +429 s (the web requests and the few answered pings), then nothing
for 152 s **while the beacons still arrived** (the driver disconnects about
6 s after the last beacon), then the beacons stopped too, and 10 s later the
router was not heard while three other networks were.

### 9.2 Documented faults (found in rc3's report and source; fixed in rc4)

| # | Fault | Evidence | Fix |
|---|---|---|---|
| 1 | **The own Wi-Fi came on at once when the router was lost, instead of after 2 minutes of the core's reconnects.** `serviceNetwork()` read `now`, then the event task set `staDownSince` a millisecond later; `(uint32_t)(now-staDownSince)` then is about 49 days and passes `>=120000`. rc3 widened the gap by ending the measured session between the two | no 201 retries after +581 s in the event list, scan at +591 s (5 s after a fallback), "fallbacks 2" | signed comparison; contract test |
| 2 | The session's end code read 36 instead of 200: the loop saw the loss before the driver's event carried the reason | report: "ended with code 36", last event code 200 at the same millisecond | the reason and the signal at the loss are taken from the event and attached 300 ms later |
| 3 | **1645 ms in the network part with the engine task waiting for the lock.** The network part's only calls of that length are the driver's mode changes (`WiFi.mode()` in `applyNetwork()` and around a scan); they ran with `engineMx` held. rc2's longest was 161 ms. Which call it was is not in the rc3 report; the mode change of fault 1, issued while the core had just started its reconnect, is the likely one | report: network 1645 ms, engine wait 1645 ms "lock held by loopTask" | the lock is let go around every `WiFi.mode()` (they touch no shared data); every step of 100 ms or more is now recorded by name |
| 4 | "9 of 10 answered" counted only 2xx, so a 304 looked like a failure, and nothing said which addresses were asked, how many bytes went out or whether a connection was used again | rc3 report | request log and counters by network (9.5) |
| 5 | A router session with a dead link stayed "online" for minutes: no page through the router and no own Wi-Fi either | 152 s without one answered ping before the driver gave up | link check acts (9.4) |

### 9.3 Probable cause of the dead data path, and the hypotheses left

**Probable (acted on): the 40 MHz link.** Beacons are sent on the primary
20 MHz channel at the lowest rate and arrived for 302 s at −47 dBm; data
frames in an 802.11n 40 MHz link use both halves, and the upper half
(around channel 5) overlaps whatever the neighbours on channels 3–9 send,
one of them at −50 dBm at the board. Espressif's Wi-Fi driver guide
("Wi-Fi HT20/40") says: "if the device is used in some special environment,
e.g., there are too many other Wi-Fi devices around the ESP32-S3 device, the
performance of HT40 may be degraded. So if the applications need to support
same or similar scenarios, it is recommended that the bandwidth is always
configured to HT20." EngineLink needs under 1 MB/s; a marina is such an
environment. rc4 sets the station to 20 MHz.

What speaks against 40 MHz being the whole story: on 2026-11-06 the link
negotiated 20 MHz and small answers worked but the page did not; rc1 had
20 MHz and never got an answer to its authentication. So 20 MHz is expected
to help and is not proven to be enough.

**Hypotheses that remain, and what rc4 records for each:**

| | Hypothesis | What would show it in the rc4 report |
|---|---|---|
| H1 | The router's 802.11n data frames (rates, aggregation) do not reach this client although its beacons do | radio samples: beacons heard ≈ expected, few frames for EngineLink or none at 802.11n; the 802.11g session (9.4) clearly better than the 802.11n one |
| H2 | The router does not hear EngineLink (EngineLink's transmit quality, or the router's own receiver on channel 1: its 4G modem can transmit in band 40, 2300–2400 MHz, next to channel 1) | radio samples: frames for EngineLink arrive mostly as **repeats** (the router did not get the acknowledgement); pings lost in both profiles; rc1's unanswered authentication fits |
| H3 | The router's 2.4 GHz radio stops for minutes (restart, channel or width change) | beacons heard far below expected before a loss; channel/width change events; scans after the loss: other networks heard, also on the router's channel, the router not |
| H4 | The board's receiver on the router's channel (place, interference, hardware) | scans: networks heard on other channels but none on the router's; noise floor on the router's channel high; Standalone on channel 1 clearly worse than on 6 (no firmware needed) |

Not a finding: group cipher TKIP. It only means the router runs WPA/WPA2
mixed; unicast is CCMP, so 802.11n is allowed, and the ESP32 supports it.
TKIP integrity failures cannot be read from the driver (no public API).

Reviewed again and without finding: DHCP (1.7 s), the address and gateway
(now printed per session), routing between the two interfaces, the web
server's start and its sockets, mDNS, the tasks' priorities (Wi-Fi 23, lwIP
18, engines 3–4 with a yield per pass; the loop's SD, CAN and serial parts
took at most 49 ms). The tasks' CPU share and stack are now in the report,
so this is measured next time instead of argued. Hardware: nothing new;
the module's antenna overhangs the board edge as it should, the IC5 repair
is unchanged, the RF calibration is renewed. H2 and H4 include the board
and cannot be excluded from here.

### 9.4 0.17.0-rc4: fixes

| # | Change |
|---|---|
| F1 | Faults 1–3 of 9.2 (fallback timer, end code, engine lock around mode changes) |
| F2 | **Station at 20 MHz** (`esp_wifi_set_bandwidth(WIFI_IF_STA, WIFI_BW_HT20)`), power save stays off. `staRadioSetup()` makes exactly two driver calls |
| F3 | **Radio profile by the link check:** a session whose link check answered fewer than half of at least 30 pings makes the next session offer 802.11g instead of 802.11n (`esp_wifi_set_protocol`), and the other way round. 802.11g has no aggregation and no 40 MHz and carries 20 times what EngineLink needs. The report names the profile of every session |
| F4 | **"Connected" but dead:** 30 pings in a row lost (60 s) and no web request through the router for 60 s → join again once (with the profile from F3); dead again → own Wi-Fi with the usual 10 min return, so EngineLink can be reached. Only for a router that answered at least one ping since the start; five good minutes re-arm it. Decisions in `netstat.h` (host-tested), acted on in `wifi.ino` |

Not changed: two modes, recovery after 120 s without the router and the
10 min return, the web server, the app, storage, the address
`http://enginelink.local` in both modes (plan 8.3).

### 9.5 0.17.0-rc4: what the report now holds

Kept in RAM over network changes, written to `/WIFI.LOG` per session and to
`/WIFIREP.TXT` every 30 minutes; the text for reading, everything again in
the JSON. No password, token or neighbour's network name is included.

| Block | Content | Source (documented API) |
|---|---|---|
| Router sessions (newest 4) | start, join and DHCP time, duration, end code and signal at the loss; offered profile, negotiated standard, router channel and width, ciphers, power save, transmit power; address, mask, gateway, DNS; signal start/lowest/highest/average/last (every 10 s) | Wi-Fi events, `esp_wifi_sta_get_ap_info`, `esp_wifi_get_*`, `esp_wifi_sta_get_rssi`, `WiFi.*IP()` |
| Link check | pings sent/answered, loss %, average, longest, longest run of losses, answers by time (<10/<50/<200/<1000/1000+ ms; timeout 1.9 s) | `esp_ping` |
| Driver warnings | beacon-timeout warnings, channel or width changes during the session | `WIFI_EVENT_STA_BEACON_TIMEOUT`, `WIFI_EVENT_HOME_CHANNEL_CHANGE` |
| Radio samples | 2 s of every 30 s: beacons heard of those expected, frames from the router for EngineLink and how many were repeats / 802.11n / 40 MHz / aggregated, the router's broadcasts, frames of other senders, noise floor | `esp_wifi_set_promiscuous` with a counting callback |
| Session in 30 s pieces (30 min) | pings, average time, signal, web requests/failed/bytes, the radio sample | the above |
| Scans after a fallback | at 5 s, about 1 and 3 min (the later two only while no phone is joined): networks heard, the router heard or not, other networks by channel with the strongest | `WiFi.scanNetworks` |
| Web by network | own Wi-Fi, router, self-test: connections, connections closed without a request, connections used for more than one request, requests, status 2xx/3xx/4xx/5xx, failed sends, bytes, slowest; `/`, `/api/health`, `/api/live` and the rest separately | `esp_http_server` callbacks |
| Request log (32) | every request through the router and failed or slow ones on the own Wi-Fi: time, address, status, bytes, time to the first byte, total time, failed, its number on the connection | same |
| System | internal memory free/lowest/largest block, failed allocations, slow steps of the network part by name, every task's CPU share and unused stack | `heap_caps_*`, `uxTaskGetSystemState` |

Honest limits: an answer counts as sent when TCP accepted it; arrival is
seen from the next request on the same connection, and the last 5.7 KB of an
answer cannot be confirmed. Not available in this core build and therefore
not reported: lwIP's packet/TCP counters (`LWIP_STATS` off), the driver's
transmit retry counters (no public API), the ARP table (no thread-safe
public read). The radio sample receives every frame on the channel for 2 s
in 30; its callback compares two addresses and counts.

### 9.6 What one router session with rc4 decides

Router mode on the home router for 15 minutes, open the page from the PC a
few times, then send the Wi-Fi report. If nothing gets through for a
minute, EngineLink itself joins again with 802.11g, so one visit tests both
profiles; a poor but not dead session switches the profile for the next join
(the app's Connect starts one).

| The report shows | Meaning | Next |
|---|---|---|
| negotiated 802.11n 20 MHz, ≥ 99 % pings, requests with connections used again, page opens | fixed by 20 MHz | section 5 bench, then the boat |
| 802.11n session poor, 802.11g session good | H1: this router's 802.11n frames and this client | make 802.11g the station's profile; boat test |
| both poor, beacons heard ≈ expected, frames for EngineLink mostly repeats | H2: the router does not hear EngineLink | board transmit path or the router's receiver: the phone-hotspot check (8.6) separates them |
| beacons heard far below expected before the loss, scans hear other networks on the router's channel | H3: the router's 2.4 GHz radio | router side; firmware done |
| scans hear nothing on the router's channel but networks elsewhere; noise floor high | H4: the board's receiver or the place on that channel | Standalone on channel 1 (8.6), then hardware |

Not provable without that session: that the page opens on the home router.
CI green means the build is sound, nothing more.

---

## 10. 2026-11-10 afternoon: the rc4 report, the owner's working sketch, and 0.17.0-rc5

Evidence: [rc4 report](test-evidence/wifi-0170rc4-2026-11-10/README.md) and
[the owner's test sketch](test-evidence/wifi-sketch-2026-11-10/README.md).
Owner's instruction: no further plan or diagnostic build; start from the
simplest network code that works, review the whole firmware for what breaks
the link, add only what is needed, deliver a build.

### 10.1 The new evidence

A sketch with `WiFi.mode(WIFI_STA)`, `WiFi.setSleep(false)`,
`WiFi.begin()`, `MDNS.begin()` and Arduino's `WebServer` on **this board**
joined the home router and served a page to the PC by name. So the board,
its antenna, the place and the router can work together; section 1.3's
"R1/R2/R3, no firmware change can repair any of them" no longer stands as
the conclusion. The sketch was run briefly with one small page; duration and
large answers are not shown by it.

About "the versions that were fast on a router": 0.13.4 and 0.15.0 were fast
for hours **on the boat router**. No EngineLink version has served the page
through the home router (section 1.1). rc3/rc4 are therefore not a
regression there; the reference for the home router is the sketch.

### 10.2 The sketch against EngineLink, call by call

| Step | Sketch (works) | rc3 (joined, 3 of 152 pings) | rc4 (never joined) | rc5 |
|---|---|---|---|---|
| Wi-Fi start after power-on | 1000 ms | 120 ms | 120 ms | **1000 ms** |
| Driver storage | default (flash) | `WiFi.persistent(false)` | same | **default** |
| Mode | `WiFi.mode(WIFI_STA)` | same (after `WIFI_OFF`, which does nothing at start) | same | same |
| Power save | `setSleep(false)` | same | same | same |
| Bandwidth | default | default | **20 MHz** | **default** |
| Protocol | default | default | `esp_wifi_set_protocol` (b/g/n or b/g) | **no call** |
| RF calibration | stored | **erased once** (first rc3 start) | stored | no call |
| Reconnect | core default | core | core | core default |
| During the session | nothing | ping every 2 s | ping every 2 s, **promiscuous mode 2 s of every 30 s**, link check that leaves the router | ping every 2 s (read only) |
| Host name | default | `setHostname` | same | same (needed for DHCP/mDNS) |
| Web server | Arduino `WebServer` in `loop()` | `esp_http_server`, own task | same | same (10.5) |
| Everything else | nothing | engine tasks, SD, LittleFS, PSRAM, LED | same | same |

### 10.3 Faults and unnecessary mechanisms removed in rc5

| # | Finding | Evidence | rc5 |
|---|---|---|---|
| 1 | Own radio settings on the station (20 MHz, protocol) that the working sketch does not have; the two builds with 20 MHz (rc1, rc4) are the two that never got an answer to their authentication | rc1 and rc4 reports; sketch | removed: no `esp_wifi_` call on the station at all |
| 2 | 802.11n/802.11g switched by EngineLink's own link check | rc4 `staRadioSetup()` | removed |
| 3 | Radio sample in promiscuous mode for 2 s of every 30 s of a router session | rc4 `netdiag.ino` | removed: it changes the driver's receive state during the session |
| 4 | "Dead link": 30 lost pings → EngineLink leaves the router by itself | rc4 `routerLinkDead()` | removed: the driver's beacon timeout decides |
| 5 | Three scans after every fallback, each taking the own Wi-Fi off its channel while phones join | rc4 `surveyRecord()` | removed; the only scan is the one started in the app |
| 6 | One-time RF calibration erase | rc3/rc4 | code removed |
| 7 | Wi-Fi started 120 ms after power-on; the radio calibrates once per start at that moment | `setup()`; sketch waits 1 s | 1 s |
| 8 | `WiFi.persistent(false)` | not in the sketch | removed (the core's default) |
| 9 | **The core's reconnect stops for good after code 202**; EngineLink stood idle for 90 s until the fallback | rc4: last attempt +142 s, fallback ~+232 s; `STA.cpp` `_is_staReconnectableReason` | kept the core's reconnect as in the sketch; added one plain `WiFi.reconnect()` after 20 s without an attempt or a report |

Kept, because they are needed or only read: the event callback (counters
only), the ping to the router every 2 s and the session record, the web
counters by network with the request log, tasks and memory, recovery (no
address for 2 minutes → own Wi-Fi; back to the router every 10 minutes while
no phone is joined, or at once from the app), `apRadioSetup()` for the own
Wi-Fi (Standalone works and is unchanged).

### 10.4 What still differs from the sketch in router mode (if rc5 fails, it is one of these)

1. **Answer size.** The sketch sent about 150 bytes; the app page is 110 KB.
   2026-11-06 already showed "small answers work, `/` does not".
2. **Duration.** Earlier sessions carried traffic for minutes before the
   link died (rc3: 150 s). The sketch was run briefly.
3. **Build options** `PSRAM=opi` (with it the core lets Wi-Fi and lwIP
   allocate from PSRAM: `CONFIG_SPIRAM_TRY_ALLOCATE_WIFI_LWIP`), `USBMode`,
   partition scheme: unknown for the sketch.
4. **The rest of the firmware running:** engine tasks on core 0, SD card on
   SPI, LittleFS/NVS writes (a flash write stops both cores for
   milliseconds), the LED.
5. **Mode switches.** The Arduino core tears the driver and both network
   interfaces down on `WiFi.mode(WIFI_OFF)` and builds them again. At a
   start straight into router mode nothing is torn down (as the sketch);
   after the own Wi-Fi was up, it is.
6. `esp_http_server` instead of `WebServer` (10.5), the ping every 2 s, the
   host name.

Reviewed without finding a fault: tasks and priorities (rc4: CPU idle
96 %/90 %, engine wait 46 ms, loop 119 ms), memory (92 KB free, no failed
allocation), SD, CAN and J1708 code (no radio or network calls), mDNS start.

### 10.5 `esp_http_server` or Arduino's `WebServer`

Kept `esp_http_server`. Reasons: (a) it is not where the failure is: rc3
answered 10 requests **through the router** and every build answers
hundreds on the own Wi-Fi, while pings to the router, which do not involve
any web server, were lost at the same time; (b) `WebServer` runs inside
`loop()`, serves one client at a time and its write retries held the loop
and the engine lock for 5–10 s (0.16.5, the reason for the change); the app
polls `/api/live` every second while a 110 KB page or an export may be
going out; (c) all 60+ handlers, uploads and the long transfers are built
on it. If rc5 fails only on large answers (10.4 item 1), the server's send
path is the next thing to compare against `WebServer` on the bench, with
the sketch extended by a 110 KB page: one flash, no EngineLink build.

### 10.6 What rc5 can and cannot show

*Built* (local ESP32-S3 compile, host tests, source checks) is all that can
be said before it runs on the board. Test: save Router mode, power the
board off and on (so the start is the sketch's path), open
`http://<address>/api/health`, then `http://<address>/`, then
`http://enginelink.local`; after 15 minutes send the Wi-Fi report. The
router is not fixed until that is reported.

---

## 11. 2026-11-10 late afternoon: rc5 failed, the sketch narrowed it, 0.17.0-rc6 on core 3.2.0

- **rc5 on the board:** the PC got `ERR_CONNECTION_TIMED_OUT` for
  `enginelink.local` (the address bar showed `https://`; no report was
  sent, so whether rc5 joined is not known).
- **The owner's sketch again, now with `PSRAM: OPI PSRAM`:** joined the home
  router as `192.168.0.2` and the PC opened its page. PSRAM (10.4 item 3) is
  cleared.
- **The sketch was built with ESP32 Arduino core 3.2.0** (ESP-IDF 5.4;
  Arduino IDE 1.8.19, ESP32S3 Dev Module, QIO 80 MHz, 8 MB, USB CDC on boot).
  EngineLink was built with core 3.3.12 (ESP-IDF 5.5.5). The Wi-Fi driver,
  lwIP and the PHY library are part of the core, so every EngineLink build
  that failed on the home router ran a different radio stack from the sketch
  that works. This is the largest difference left and the only one that
  needs no change to EngineLink's own code to remove.

**0.17.0-rc6 = rc5 built with core 3.2.0**, in CI too (`build-engine.yml`,
`pages.yml`, contract test). One source change: GitHub's certificate bundle
is given by address on core 3.2 (`updates.ino`; core 3.3's
`useBuiltinCACertBundle()` does the same). Nothing else differs from rc5.

Reading the result: rc6 works on the home router → the regression is in the
core between 3.2.0 and 3.3.12 (to be reported to Espressif with both
reports), and EngineLink stays on 3.2.0. rc6 fails as before → the core is
cleared and what is left of 10.4 is inside EngineLink: answer size and
duration, the rest of the firmware running, mode switches, `esp_http_server`.

*Built* (local ESP32-S3 compile on core 3.2.0, host tests, source checks).
Not run on the board; the router is not fixed on this evidence.

---

## 12. 2026-11-10 evening: rc6 on the board, and the bench sketch

Evidence: [rc6 report](test-evidence/wifi-0170rc6-2026-11-10/README.md).

**Cleared by tests on the board today:** PSRAM (sketch with OPI PSRAM works),
the core version (rc6 on 3.2.0 fails like rc3 on 3.3.12), EngineLink's own
radio settings (rc5/rc6 have none), the join itself (593 ms), the web
server for small answers (3–8 ms through the router).

**What rc6 measured:** small answers through the router work, the 110 KB
page fails every time, ping replies are 50–1800 ms late at −40 dBm and die
out over five minutes, then the beacons are lost and the router is not
found for two minutes. The owner's sketch sent one answer of about 150
bytes once; it has not been tested with a large answer or over time. So
there is **no tested difference left** between the sketch and EngineLink.

**Hypotheses that fit the late replies (not proven):**

| | Hypothesis | Fits | Test |
|---|---|---|---|
| A | 802.11n between this router and the ESP32 (40 MHz, frame aggregation with block acknowledgement): held-back frames give exactly such delays, and it only starts once real traffic flows | small answers fine, large fail, link worse with use | bench sketch profile 1 (802.11g only) good where profile 0 is bad |
| B | The router does not hear EngineLink well (many repeats per frame) | delays, loss | both profiles bad in the bench sketch |
| C | Something in EngineLink besides the network code | — | bench sketch profile 0 good for 10 minutes with large pages |

**The bench sketch** (`tools/wifi-bench/wifi_bench/wifi_bench.ino`): the
owner's sketch plus `/big` (110 KB) and a counted ping to the router every
second; `RADIO_PROFILE 1` adds the single call
`esp_wifi_set_protocol(WIFI_IF_STA, 11B|11G)`. It runs without EngineLink,
is flashed from the Arduino IDE in a minute, and decides between A, B and C:

| Profile 0 | Profile 1 | Meaning | Next |
|---|---|---|---|
| bad | good | A | EngineLink's station gets that one documented call |
| bad | bad | B: the radio link to this router, not EngineLink's code | transmit power steps in the sketch, then hardware |
| good | — | C: EngineLink itself | compare the send path (`esp_http_server`) and the running tasks |

"Good" = pings answered ≥ 99 %, most under 10 ms, `/big` in about a second,
for 10 minutes.

---

## 13. 2026-11-10 evening: the bench sketch on the board, and 0.17.0-rc7

**Bench sketch on the home router (owner, screenshots; no EngineLink code,
Arduino `WebServer`, core 3.2.0, channel 1, −43…−48 dBm):**

| Profile | Time | Pings answered | Typical reply | 110 KB page |
|---|---|---|---|---|
| 0, driver defaults (802.11n 40 MHz) | 2 min | 117 of 117 | 10–50 ms | 5 of 5, 1.8–2.2 s |
| 0 | 3.5 min | 205 of 205 | more at 50–200 ms | 3.6–4.0 s |
| 0 | 10 min | 602 of 613 | 153 at 200–1000 ms | **15–16 s**, still delivered (17 of 17) |
| 1, 802.11g only, flashed right after | 30 s | 16 of 25 | 9 at 200–1000 ms | none completed; the page froze |

What it shows:

- The plain sketch degrades on this router too: the same page takes eight
  times longer after 10 minutes at an unchanged signal. So the cause of the
  degrading link is **not in EngineLink's code** (hypothesis C of section 12
  is out) and **not 802.11n** (profile 1 was worse; hypothesis A is out).
- Profile 1 was bad from its first second although the ESP32 had just been
  reset: whatever degrades is not reset with the chip. That leaves the
  board outside the chip (heat, the 3.3 V supply) or the router/place.
- **One real difference in EngineLink's favour to fix:** the sketch still
  delivered the page at 15 s, because `WebServer` waits. EngineLink's server
  gave up after 5 s without progress (`send_wait_timeout = 5`); rc6's five
  failed pages ended after 5.6–26 s.

**Hardware suspicion (documented, not proven):** the 3.3 V rail comes from
IC5 (TLV76733 LDO from 5.24 V, about 0.4–0.7 W of heat under Wi-Fi
transmission, next to the module; the part with the cold joint repaired on
2026-11-09). A regulator that limits when warm would give exactly: good at
first, worse with time and with traffic, still bad after a chip reset, good
again after a pause. `hardware/PCB_GERBER_REVIEW_2026-11-05.md` lists IC5's
temperature and the rail under Wi-Fi traffic as never measured. Checks: the
3.3 V rail on the oscilloscope at the module while `/big` loads after
10 minutes; a finger on IC5; bench sketch profile 2 (8.5 dBm).

**0.17.0-rc7:**

| Change | Why |
|---|---|
| `send_wait_timeout` 5 s → 30 s | the page arrives on a slow link instead of being abandoned (above) |
| CI back on core 3.3.12 | rc6 on 3.2.0 failed the same way; the core is cleared, the project's pin is restored (the certificate call in `updates.ino` works on both) |
| station, recovery, Standalone | unchanged from rc5 (the working sketch's three calls) |

Considered and not done: the page is already stored and sent gzip-compressed
(481 KB → 110 KB). A JavaScript minifier measured 10 % more (94 KB) for a new
build dependency in three workflows and an app nobody has tested minified;
loading the drive-test pictures separately would cut the first load to about
71 KB but changes how the drive test starts. Neither changes whether a link
that degrades to nothing carries the app. A rewrite of the whole firmware
would not change the radio either: the 100-line sketch shows the same link.

rc7 can make the app open on the home router while the link is slow but
alive. It cannot keep a link alive that stops carrying data. *Built*; not
run on the board; the router is not fixed on this evidence.

**Owner's statement, 2026-11-10 (after this section was written):** the board
was checked for cold joints, and current and voltage were on the
oscilloscope during all of today's tests with nothing wrong. The IC5
suspicion above is therefore not supported by measurement and is not
pursued. The cause of the link that degrades with time on the home router
(also with the plain sketch) is open. The owner decided to release rc7 as
**0.17.0** so that further builds go through the web installer; it is a test
release, not verified on the board.

---

## 14. 2026-11-10 late: 0.17.0 on the board, and 0.17.1

**0.17.0 on the home router (owner's report, built 16:14:41, installed with
the web installer, so settings were empty and the router was chosen in the
app):** joined at +90 s in 376 ms, −40 dBm, 802.11n 40 MHz, power save off.
Pings per 30 s: 10/15 (303 ms), then 0/15, 1/14, 0/16, 0/14, 1/16, 1/15,
1/15, 0/15, 1/15; 15 of 151 in all, none under 10 ms. Through the router:
`/` 304 in 3 ms, `/api/prefs` and four `/api/live` (741 B) in 3–6 ms; `/`
(110 KB) failed three times after 5–31 s. The PC showed the app from its
cache with "Reconnecting". Beacons lost 305 s after the join, then 49 × 201,
own Wi-Fi (680 kB/s). Later the PC got `ERR_NAME_NOT_RESOLVED`, which is
expected once EngineLink has left the router.

**Two things in the figures:**

1. The three sessions with power save off ended **302, 306 and 302 s** after
   the address (rc3, rc6, 0.17.0). That is a timer, not chance. 802.11n has
   one of 300 s: a station on a 40 MHz network in the 2.4 GHz band scans for
   overlapping networks every 300 s (20/40 coexistence). Not proven to be
   it; the bench sketch (also 40 MHz) ran 616 s without losing the router.
2. EngineLink loses its pings within a minute; the bench sketch kept 117 of
   117 for two minutes. So besides the slow degradation both show, there is
   something EngineLink-specific early in a session. Section 11's "PSRAM is
   cleared" was too strong: the sketch with OPI PSRAM was only tried with one
   small page; the bench sketch with pings and the large page ran with PSRAM
   disabled. Open differences for the first minute: the join after the own
   Wi-Fi (driver torn down and rebuilt, country DK and 19.5 dBm carried
   over), PSRAM under traffic, the rest of the firmware.

**0.17.1:** choosing the router restarts EngineLink so it joins straight
after a start, as the sketch (not during a trip). The report names per
session how it was joined, the driver's country code and when the last ping
under 50 ms was answered. If 0.17.1 still loses its pings in the first
minute after a clean start, the next step is the bench sketch with
`PSRAM: OPI PSRAM` (one Tools setting), which separates PSRAM from the rest
of the firmware.

---

## 15. 2026-11-10 night: 0.17.1 on the board, and 0.17.2

**0.17.1 on the home router (owner's reports at 50 s and 654 s; router
chosen in the app, EngineLink restarted and joined 1.9 s after the start):**
"Joined straight after the start", 802.11n **20 MHz** (the router itself ran
20 MHz this time), −39…−42 dBm, 20 dBm. First 45 s: 18 of 22 pings, average
441 ms, 28 of 28 web requests answered in 2–12 ms, the app shown on the PC.
At 654 s: **still joined, no disconnect**, 109 of 325 pings (average 770 ms,
1 under 10 ms, 37 over 1 s), 51 requests, 12 failed sends; the speed test
and the report page hung in the browser.

What it shows: the join from a clean start holds (earlier sessions lost the
router after 302–306 s; this one ran past 650 s), with the caveat that the
router's width also changed from 40 to 20 MHz, so the 300 s timer of 40 MHz
coexistence scans (section 14) and the clean start are not separated. The
link is slow from the first seconds, where the plain sketch was fast for two
minutes.

**0.17.2:** the remaining software difference to the fast sketch is PSRAM
(section 14). EngineLink now takes all PSRAM at start (`psram.h`: a 2 MB pool
of its own through `multi_heap`, the rest held), so the core's "PSRAM first"
allocation for Wi-Fi and lwIP finds none and uses internal memory. The owner
decided on this change without the separating sketch test; whether PSRAM is
the cause is open (other PSRAM projects run Wi-Fi without trouble). If 0.17.2
is as slow as 0.17.1, PSRAM is cleared and what differs from the sketch is
the rest of the running firmware.

---

## 16. 2026-11-10 night: 0.17.2 on the board (memory ran out), 0.17.3 = 0.17.1

**0.17.2, owner's report in Standalone at 87 s:** internal memory free
35 KB, lowest **0 KB**, largest block 24 KB, **109 failed allocations**
(last 1600 bytes, a packet buffer), safety valve opened once (6036 KB of
PSRAM back with the system), speed tests 161–462 kB/s at 13–38 ms where
0.17.1 had 580–730 kB/s at 7–12 ms. No crash. Router mode was not tried.

So with EngineLink's own internal use (about 124 KB of static data plus the
task stacks), the Wi-Fi driver's and lwIP's buffers do not fit in internal
memory under traffic. 0.17.2's approach is wrong for this firmware as it
stands and is removed in 0.17.3 (`psram.h`/`psram.cpp` deleted, all users
back on `ps_malloc`). The measurement that came out of it: Wi-Fi and lwIP
want well over 60 KB of internal memory under a speed test.

The PSRAM question for the home router is still open. Two ways to answer it:
the bench sketch with `PSRAM: OPI PSRAM` (minutes, no EngineLink build), or
moving EngineLink's large static tables into PSRAM first so that the
buffers fit (a larger change, only worth it if the sketch test says PSRAM
matters).

---

## 17. 2026-11-10 night: Standalone varies too; 0.17.4 measures temperature

**0.17.3 (= 0.17.1's firmware) in Standalone, owner's two reports from one
start (cold power-on, bench supply through the buck converter, no USB, PC at
−41 dBm on channel 6):**

| Uptime of the speed tests | kB/s | Round trip |
|---|---|---|
| 61–73 s | 54–121 | 24–103 ms; the app page took 6.3 s |
| 202 s | 226 | 23 ms |
| 253–282 s | 195–477 | 8–27 ms |
| earlier the same day, same code (0.17.1/0.17.0, started by a restart, not a cold power-on) | 580–730 | 7–12 ms |

Internal memory 93 KB free, lowest 77 KB, no failed allocation, CPU idle
94 %/89 %. The same pattern is in two earlier reports: rc6 (64–188 kB/s at
51–103 ms just after the start, 511–557 kB/s ten minutes later) and 0.17.2
(161–462 kB/s 87 s after a power-on; the memory shortage there was real, but
part of the drop may have been this).

**What it shows.** The radio link of this board changes by itself with the
time since power-on, without the router and without a firmware difference.
Standalone gets *better* over the first minutes after a cold start; the
router sessions and the bench sketch got *worse* over minutes. Both fit
something that drifts as the board warms up and that suits one partner when
cold and another when warm (for example the radio's frequency or its
calibration against temperature), but that is a hypothesis: no temperature
has been measured. The owner has checked voltages and current with the
oscilloscope and found nothing wrong; this is not a statement about those.

**0.17.4** reads the ESP32-S3's internal temperature sensor every 5 s and
puts it in the report: now / first reading / highest, per speed test (with
the uptime of the test), and per 30 s piece of a router session. One cold
start with speed tests at about 1, 3, 6 and 10 minutes then shows whether
speed follows temperature. If it does, the next question is hardware (the
module or what heats it); if speed changes while the temperature does not,
temperature is out and the PC's or the router's side is next.

---

## 18. 2026-11-11: the cold start measured; slow until the board has warmed, not the chip

Evidence: [0.17.4 cold start](test-evidence/wifi-0174-coldstart-2026-11-11/README.md)
(PC on the own Wi-Fi, board on USB power, no firmware change).

| | Uptime | Chip | kB/s |
|---|---|---|---|
| Cold power-on | 440 s | 41 °C | 37 |
| | 544 / 626 / 706 s | 42 / 42 / 43 °C | 90 / 180 / 476 |
| | 807–1590 s | 42–44 °C | 690–760 |
| Same board warm, PC rejoined | first second | 44 °C | 714 |
| Same board warm, app restart | first test | 44 °C | 752 |

**What it decides.** The speed follows neither the chip's temperature
(37 → 720 kB/s at 41 → 43 °C) nor the PC's join (rejoin fast at once) nor
anything EngineLink does per start (restart fast at once). It follows the
time since a **cold power-on**: something outside the die that warms more
slowly, for example the module's crystal or the board around it. Section 17's
"if speed changes while the temperature does not, temperature is out" is true
for the chip sensor, but the restart test points to physical warm-up rather
than to the PC or the router.

This also fits the home router sessions only in part: those got *worse* with
time (sections 13–15), this gets *better*. Both are a link that changes with
the board's warm-up; which partner it suits differs.

**Next (no firmware build needed):**

1. Cold power-on, PC on the own Wi-Fi at once, gentle warm air (hair dryer at
   a distance) on the module for 1 minute at about 2 min uptime. Fast right
   after → heat outside the chip is the cause. Then the same aimed at the
   module's corner with the crystal vs. at IC5 to localise it.
2. Owner's other ESP32-S3 boards (e.g. the Prism controller, same module) on a
   cold start with the same speed test: same pattern → module type; not →
   this board.
3. Router mode from a cold start with the PC on the router's Wi-Fi only (see
   below).

**PC network found during the session:** the PC's Ethernet is on a different
router that also uses `192.168.0.1` and `192.168.0.0/24`, with a lower metric
than the Wi-Fi. With both up, the PC sends traffic for EngineLink on the home
router (`192.168.0.2`) out of the Ethernet, where it times out. Router tests
from this PC need the Ethernet unplugged or requests bound to the Wi-Fi
address; earlier PC-side timeouts may partly be this.

## 19. 2026-11-12 to 11-14: the slow own Wi-Fi was a busy channel 6; automatic channel

**What was measured (owner and PC on the bench, Standalone):**

| Test | Result |
|---|---|
| Hot air on the module, then ice bag under the board (old module) | fast right after the heat (359–802 kB/s), slow again within a minute on the ice (8–103 kB/s, then the PC lost the link) |
| New ESP32-S3-WROOM-1-N8R8 module, 0.17.4, cold start | still slow: 18–115 kB/s, ping 2–124 ms, PC signal 93 % |
| Plain Arduino SoftAP sketch, no EngineLink code, channel 6 (core 3.3.12) | as slow: 29–133 kB/s at 99 % signal |
| The owner's own SoftAP test sketch (core 3.2.0), channel 6 | 0.45 Mbit/s down, 0.44 up, 73.8 ms; the board heard the PC at −39 dBm |
| The same sketch, **channel 1**, 2 min later | **5.58 Mbit/s down, 3.70 up, 13.4 ms**; 256 KiB in 378 ms instead of 4707 |

So the module, the solder joints and EngineLink's code are not the cause:
two modules and three firmwares were slow on channel 6 and fast on channel 1
at the same strong signal. The PC's scan showed a neighbour network on channel
6 and others on 9 and 11, while channel 1 carried more networks but little
traffic. The warm-up pattern of sections 17–18 most likely followed the
neighbour's traffic over time; why heat and ice matched it so closely is not
explained and is left open. Section 18's "module crystal" conclusion is
withdrawn.

**Automatic channel (owner's decision 2026-11-14, built):** the way routers'
"Auto" channel works, for the own Wi-Fi only (router mode follows the router).

- Before the own Wi-Fi starts, EngineLink listens 2 × 250 ms on each of 1, 6
  and 11 with the Wi-Fi driver's documented sniffer and adds up the **air
  time** other networks use (frame length at its rate), so a channel with
  many quiet networks beats one with a single busy neighbour. It starts on
  the quietest; it keeps the previous channel unless another is under half as
  busy and at least 5 points better. About 1.5 s later start of the own Wi-Fi.
- While the own Wi-Fi runs and **no phone is joined**, it listens 1 s on its
  own channel every 10 minutes. Two checks at 10 % busy or more in a row
  start a new survey, which restarts the own Wi-Fi (nobody is connected). A
  connected phone is never moved; a channel change makes a phone rejoin.
- Default **on** for every board (new NVS key `apauto`); the last choice is
  kept in `apchl`, written only when it changes. `POST /api/settings`
  `apch=0` is automatic, `1`/`6`/`11` a fixed channel as before.
- The sniffer was removed from router sessions in rc5 (section 10, it changed
  the station's receive state). It returns only in `chanauto.ino`, before the
  AP starts and on the AP with no phone joined; `test_wifi_contract.py`
  enforces that. The decision is pure C++ in `chanpick.h`, host test
  `tools/test_chanpick.cpp`.
- The network report has a `Channel:` line: busy share per channel at the
  last survey, surveys, checks and channel moves.

**Bench, 2026-11-14 (built and flashed from this branch, not released):**
the survey measured 4 % on 1, 6 % on 6, 4 % on 11 and started on channel 1;
the PC then got 212 → 562 kB/s over the first 30 s (channel 6 the same day:
18–115 kB/s). *Bench-verified for the start choice only*; the 10-minute check
and a move with a phone nearby are not verified yet. Networking change:
merge and release only after the bench and boat protocol.

**Router mode, same build, 2026-11-14 (owner's phone, home router on channel
1, bench supply):** one session of 1567 s without a break: 784 of 784 pings
answered (average 2 ms, longest 9 ms), signal −42 to −48 dBm, 1173 web
requests all 2xx, no disconnects, beacon timeouts or failed sends. Phone
speed tests 427–617 kB/s at 1056–1567 s (one 242 kB/s), as at 20 s (520–614).
USB supply the same at 30 s (559–629 kB/s). The degradation over ~10 minutes
of sections 13–15 did not occur; with the router on a quiet channel it points
to the same cause as Standalone (channel load), not proven for those sessions.
The phone's app was idle for about 10 of the 26 minutes.
