Kaelor9/EngineLink/docs/releases/v0.16.6.md

# EngineLink 0.16.6 — Wi-Fi 2.0 Stages 1–3 (development and bench build)

**Status: *built* (pinned toolchain, host tests and source checks pass),
partially tested on actual hardware as of 2026-11-06; not fully bench-verified
or boat-verified. Not a release:** no merge to `main`, no
GitHub Release, not offered under "Check for updates". It is a bench build
for the owner. Wi-Fi 2.0 as a whole ships as 0.17.0 after the bench and boat
protocol in [WIFI_REWRITE_PLAN.md](../WIFI_REWRITE_PLAN.md) 9.9 (D24).

What is in it (plan section 9):

- **Stage 1 — access point radio and diagnostics.** The own Wi-Fi again runs
  20 MHz, keeps quiet phones 600 s and uses country `DK` (802.11d on), all
  through Espressif's `esp_wifi` calls, as every version before 0.16.2 did.
  The transmit power is set after the country in both modes and checked
  exactly (the driver's unset 20 dBm no longer passes as 19.5). The report,
  `/api/diag` and the SD log show each joined phone's signal at EngineLink,
  its Wi-Fi standards and the access point's real channel, bandwidth, PMF,
  inactive time and country. Repeated router retries fold into one line.
  CI installs exactly Arduino core 3.3.12 and NeoPixel 1.15.5.
- **Stage 2 — web server.** Espressif's `esp_http_server` replaces the
  Arduino web server and the extra listeners on ports 81 and 82. It runs in
  its own task, so a phone that stops answering can no longer stall the main
  loop (the 5–10 s "web" stalls of 0.16.5). Downloads run in a separate
  transfer task, uncompressed (same routes, columns, file names and content).
  Security without a login: only EngineLink's own addresses are answered
  (421 otherwise), only its own pages may read replies (no more
  `Access-Control-Allow-Origin: *`), every change needs the app's
  `X-EngineLink` header (403 otherwise), request sizes are limited.
  Firmware upload sends the file as the request body and is checked for
  length, image header and application before it can start. A new firmware
  confirms itself only after a real web client got an answer (or the board's
  own request to itself, when no phone has connected); without that within
  10 minutes the board goes back to the previous firmware by itself.
- **Stage 3 — state machine.** The Wi-Fi 2.0 states (standalone, router
  test, router, router lost, return) as a host-tested header; **not used by
  the firmware yet**. The Wi-Fi behaviour (modes, fallback after 2 min,
  return every 10 min, router setup) is unchanged from 0.16.5.

Not changed: J1708 and KAD reading, NMEA 2000, trips, fuel, totals, storage
formats, NVS settings, the app's screens. Settings and data survive the
update.

## Second bench build (2026-11-06, after the first bench reports)

Same version number; the Wi-Fi report's first line shows the build time.
No Wi-Fi behaviour changed (no state machine, no network switch). Fixes for
what the reports showed (plan 12.1 I10, I11):

- **Engine reading no longer waits for the SD card.** Opening a file on a card
  with many logs takes 0.1–0.4 s; the SD info (7.3 s), the daily raw clean-up
  (485 ms a pass), the Wi-Fi log on the card (~300 ms) and the wipe did that
  while holding the engine lock. They now let it go while the card works.
  Settings shows the SD card's size from a count made in the background
  ("Reading the card…" for a moment after it opens). A card removed during a
  download stops the download first and is then unmounted; remount, wipe and
  factory reset say "busy, try again" for the moment the card is in use.
- The serial commands `wifi log` and `wifi reports` stop as soon as the
  computer stops reading (before: up to 2 s per 256 bytes), and the SD Wi-Fi
  log can no longer skip an event that arrives while it writes.
- **Report:** "Busy (503)" split by cause with the last path; the engine
  task's longest wait names the task that held the lock, with the number of
  waits over 100 ms and its longest round of its own work.
- The router name is hidden in the committed test files.

Not changed: storage formats, settings, the raw log and how it is written,
the update and rollback path. Status: *built*; not yet run on the board.

## Third bench build (2026-11-08, router mode)

- **Router mode joins at 20 MHz again and rides out 20 s without the
  router's beacons** (the driver's default is 6 s), as every version up to
  0.16.1 did. 0.16.2 dropped both. Reported 2026-11-08: on the router the app
  page (110 KB) failed after 20.5 s while small answers worked; plan 12.1
  I14. Standalone is unchanged.

Status: *built*; the subsequent owner test described below **failed router-mode connectivity**.

### Owner bench result: 2026-11-08 (third build)

After installing the build from commit `0641917`, the owner reported that
`http://192.168.0.2/`, `http://192.168.0.2/api/live`, and
`http://enginelink.local` were unreachable in router mode. The 4G router's
client table still listed the board at `192.168.0.2`. A Windows 10-ping
sequence produced only **one valid reply from the board** (18 ms), eight
timeouts and one local `Destination host unreachable` from the PC. Windows
counted the local error in its "Received 2, Lost 8 (80% loss)" summary.

This **does not validate** the 20 MHz/20 s change, and the fault cannot be
ascribed solely to HTTP/gzip/mDNS. A post-flash Wi-Fi report identifying the
running build has not been supplied. Do not declare Stage 0 or Stage 2
accepted. Full owner evidence and engineering handoff:
[build-3 router link failure](../test-evidence/wifi-0166-2026-11-08/router-link-failure-build3.md).

## Fourth bench build (2026-11-08, router diagnostics)

- The Wi-Fi report's router counters are true again (associations, IP
  gains and losses, disconnects, drops of a live link, fallbacks to the own
  Wi-Fi) and it shows the router's channel and last signal from before a
  loss, plus the station's beacon timeout read from the driver. The SD
  Wi-Fi log adds the router's channel and last signal to each router line.
  Nothing else changed; plan 12.1 I15. Status: *built*; not yet run on the
  board.

## A/B test build (2026-11-08, not a release)

Same firmware as the fourth bench build, built a second time with router
mode on the Wi-Fi driver's own defaults (as the Prism controller): CI
artifact `EngineLink-AB-test-router-driver-defaults-<commit>`, file
`EngineLink-AB-router-driver-defaults.bin`. Its Wi-Fi report says
"A/B TEST BUILD" on the firmware line. Install it from a file like any bench
build (settings and data are kept); put the normal build back afterwards.
Purpose and reading: plan 12.1 I16.

## Install on the bench

Use **Settings › Firmware › Install from a file** with `enginelink-update.bin`
(keeps settings and data). Do not use the USB image (`*.merged.bin`): it
erases settings and data. After the restart, close and reopen the app (or
reload the page) so the phone loads the new app; the old app's requests
would be refused (403) by the new security check.

## Initial owner bench evidence (2026-11-06)

The owner completed standalone USB/lab/USB speed tests, a two-client run with 37 minutes of uptime, a router run that lost beacons after ~18 minutes, a partial oscilloscope check and three HTTP security smoke tests. The Stage 2 acceptance list has **not** been fully passed; Stage 0 remains unclassified. See [source Wi-Fi reports and evidence summary](../test-evidence/wifi-0166-2026-11-06/README.md). Do not merge or release on these partial tests.

## Bench test (plan 9.1 and 9.2)

Do Stage 0 step 1 (plan 13.6) on 0.16.5 first if not done yet, and the
"before" downloads of the export check. Then, on 0.16.6, USB from a charger,
iPhone and PC on EngineLink Wi-Fi:

1. Within 2 min of the app reconnecting the Wi-Fi report says
   `Firmware self-test: passed (client response)`.
2. Wi-Fi report: `Access point as the driver runs it: channel 6, 20 MHz,
   … stations kept 600 s …, country DK`; `driver reports 19.50 dBm
   (78 quarter-dBm)`; each joined phone with its dBm.
3. App open on both for 30 min: no "Reconnecting"; report HTTP line
   `send failures` 0; longest loop part well under 1 s.
4. From the PC, the `curl` list in plan 9.2 (403 without the header, 421 for
   a foreign Host, 413 for a 3 KB body, no `Access-Control-Allow-Origin`
   for a foreign Origin, 20 parallel requests all 200).
5. Export check: download every export again and `diff` with the 0.16.5
   copies; no `Content-Encoding` header.
6. Install `enginelink-update.bin` once more from a file: restart and step 1
   again (tests the new upload path).
7. If a router is at hand: the report shows 19.50 dBm in router mode too;
   router switched off 2 min gives fewer than 10 event lines.

Send the Wi-Fi report after steps 1, 3 and 7, the `curl` output and the
`diff` result.

## Fifth development bench build (2026-11-09, owner-directed simplification)

Removed `wifiwpa3.cpp/.h` and `netboost.cpp/.h`, their initialization wrapper, private lwIP TCP PCB modifications, compile/link hooks, and A/B radio tuning build. Router station uses the official Arduino ESP32 core 3.3.12 driver defaults; AP, data formats, trip/fuel code, and recovery handling are otherwise unchanged. The browser-facing diagnostics no longer claim WPA2 is forcibly selected or that TCP is boosted. This update takes precedence over earlier notes recommending the two exceptions. **CI and real-device router verification are separate gates; neither is implied by this source change.** Never release or merge without the existing owner-approved bench and boat validation.

## Actual build and router results — 2026-11-09 (supersedes older proposed bench protocol)

- [Compile run #260](https://github.com/Kaelor9/EngineLink/actions/runs/42629964143) of `b3ed536` failed because `routerHoldSince` was accidentally removed when custom WPA3 logic was deleted. This was fixed in `75faba4`.
- [Compile run #261](https://github.com/Kaelor9/EngineLink/actions/runs/42631425052) of `75faba4` **succeeded** and produced the sole `EngineLink-App-ESP32S3-75faba4253eb6d3a755541995ca8892fa2e47a0d` artifact. Firmware build time: `Nov 9 2026 14:08:09`. It was installed and tested on the owner's repaired board. No merge to main and no release.
- [Current report and analysis](../test-evidence/wifi-0166-2026-11-09/README.md): Standalone/Recovery AP serves the UI at 539.6–745.9 kB/s, but a Maggan WPA2 association + DHCP `192.168.0.2` did **not** allow `/` or `/api/health` over the router. Beacon loss (reason 200) ~539 s later, followed by repeated reason 201 retries. This is an **open failure**. Full report: [text](../test-evidence/wifi-0166-2026-11-09/firmware-75faba4-maggan-recovery.txt).
- Per owner, Fable must now formulate a **revised root-cause-led plan** without private-driver special solutions and without imposing router configuration changes. Do **not** mistake CI success for functional router verification. No further work or release until the plan is approved.
