Kaelor9/EngineLink/docs/releases/v0.17.0.md

# EngineLink 0.17.0 — Wi-Fi: two modes, documented station profile

**Status: released on 2026-11-10 by the owner's decision, so that test
builds can be installed with the web installer. It is a test version: built
(pinned core 3.3.12 compile, host tests and source checks pass) and NOT
verified on the board.** Standalone is unchanged from the builds that work
on the bench. Router mode joins with the three calls of a plain sketch that
served a page through the owner's home router on this board, but no
EngineLink build has yet kept the app usable through that router
([WIFI_PLAN_2026-11-09.md](../WIFI_PLAN_2026-11-09.md) section 13). Hardware:
revision 1 board, ESP32-S3-WROOM-1-N8R8. USB installation erases settings
and internal history; the Wi-Fi update file keeps them. The release content
is rc7 below; rc1–rc6 were never released.

## rc7 (2026-11-10): the app page is not abandoned on a slow link

A test sketch without any EngineLink code showed the link to the home router
getting slower with time on this board (the 110 KB page: 1.8 s at first,
16 s after 10 minutes). The sketch still delivered the page; EngineLink's
web server gave up after 5 s without progress. rc7 lets a send wait 30 s.
Router mode still joins with the three calls of the working sketch; back on
ESP32 core 3.3.12 (rc6 on 3.2.0 behaved the same). Not proven by this build:
that the app stays usable on the home router.

## rc6 (2026-11-10): built with the ESP32 core of the sketch that works (failed on the board)

rc5 still timed out on the home router. The owner's test sketch works there
also with PSRAM on, and it was built with ESP32 Arduino core 3.2.0;
EngineLink used 3.3.12, a newer Wi-Fi driver. rc6 is rc5 built with core
3.2.0. Nothing else is changed. Not proven by this build: that the page
opens on the home router.

## rc5 (2026-11-10): the station of the sketch that works (failed on the board)

- **Router mode joins exactly as the owner's working test sketch:**
  `WiFi.mode(WIFI_STA)`, `WiFi.setSleep(false)`, `WiFi.begin()`. EngineLink
  sets nothing on the radio in router mode any more.
- **Removed from rc4:** the 20 MHz and 802.11g/n settings, the switch between
  them, the radio sample (promiscuous mode), leaving the router after lost
  pings, the three scans after every fallback, the one-time RF calibration
  erase.
- **Fixed:** after error 202 the ESP32 core stopped trying and EngineLink
  waited idle until the 2-minute fallback (rc4 report). EngineLink now starts
  a new attempt after 20 s without one.
- The Wi-Fi starts 1 s after power-on (was 120 ms), as in the sketch.
- Unchanged: Standalone, recovery (2 minutes without the router → own Wi-Fi,
  back every 10 minutes or from the app), the web server, the app, settings,
  engine data, trips, SD, updates. The Wi-Fi report keeps the router
  sessions, the pings and the web counters; the radio samples and scan
  blocks are gone.

Not proven by this build: that the page opens on the home router.

## rc4 (2026-11-10): rc3's faults fixed, 20 MHz, everything recorded (failed on the board)

Fixed (faults of rc3, plan 9.2):

- **The own Wi-Fi came on at once when the router was lost** instead of
  after 2 minutes of reconnecting (a race between the main loop and the
  Wi-Fi event). Recovery is back to: 2 minutes of the core's reconnects,
  then the own Wi-Fi, return every 10 minutes.
- **The engine task waited 1645 ms** while the Wi-Fi driver changed mode.
  The engine lock is now let go around every mode change.
- The end code of a lost session was recorded wrongly (36 for 200).

Changed in router mode (plan 9.3–9.4):

- **20 MHz on the station.** rc3 negotiated 40 MHz next to other networks;
  Espressif recommends 20 MHz there. Power save stays off.
- **802.11g after a poor 802.11n session**, and back: decided by EngineLink's
  own pings to the router, named per session in the report.
- **A "connected" link that carries nothing for a minute is left:** one new
  join, then the own Wi-Fi, so EngineLink can be reached.

The Wi-Fi report (plan 9.5) now keeps, across network changes: the last four
router sessions (times, end code, signal over time, negotiated standard,
addresses, pings with their answer times, driver warnings, web traffic), a
radio sample every 30 s (beacons heard, repeats, 40 MHz frames, noise
floor), the newest session in 30 s pieces, scans after a fallback with the
networks by channel, the web server split into own Wi-Fi / router /
self-test with status codes, bytes, connections used again, the addresses
`/`, `/api/health`, `/api/live`, a log of the last 32 requests, memory,
slow network steps by name and every task's CPU share and stack. No
password, token or neighbour's network name.

Not proven by this build: that the page opens on the home router.

## rc3 (2026-11-10, morning): the chain reviewed, the link measured by EngineLink

- **Station power save off in every router session.** rc2 made no power-save
  call on the station, so the ESP32 core applied the value stored last: modem
  sleep on after a start straight into router mode, off after the own Wi-Fi
  had been up. A server with modem sleep hears another device's first packet
  only if it catches the router's next beacon.
- **RF calibration renewed once.** The stored calibration was made before the
  3.3 V regulator (IC5) was repaired and is reused at every start; the first
  start of rc3 discards it so the radio calibrates in full. Settings and data
  are untouched.
- **`http://enginelink/` works** on routers that put the DHCP name in their
  own DNS (also `.lan`, `.home`, `.home.arpa`, `.internal`); it was answered
  421. The address is `http://enginelink.local` in both modes; EngineLink has
  no HTTPS and needs none (plan 8.3).
- **The report says where a router session fails**, in a new block "ROUTER
  LINK AS ENGINELINK MEASURED IT": pings to the router (sent, answered,
  longest, most lost in a row), the signal at the start/lowest/last, the
  router as the driver saw it, the station's real power save, the web
  connections and requests that came in **through the router** (separate from
  the own Wi-Fi), and after a fallback one scan: networks heard, the router
  heard or not. Also in `/WIFI.LOG`. Plan 8.5 has the table for reading it.
- CI's version check accepts `-rc3` (it rejected `-rc2`).

Not proven by this build: that the page opens on the home router. The review
found no fault in the web server, its checks, routing, tasks or mDNS; the
other device's packets do not arrive. rc3 removes the two firmware-side
suspects and measures the rest.

Why: router mode worked for hours on the boat router but never served the
page on the home 4G router, and every analysis step so far produced another
bench build. The 2026-11-09 review ([plan](../WIFI_PLAN_2026-11-09.md)
section 1) found the failure below the firmware's logic and a short list of
real firmware defects. This build fixes those, removes what the review
dropped, and leaves one session to tell router, place and board apart.

## Wi-Fi

- **Two modes, never both.** Standalone (own Wi-Fi at 192.168.4.1) and Router
  (station only). The 2 minute fallback to the own Wi-Fi and the 10 minute
  retry while no phone is joined stay as a **recovery mechanism**; the report
  now says "Router (router not reached; EngineLink Wi-Fi on meanwhile …)" and
  the app "Router not reached", instead of a third "Recovery" mode.
- **Station on the ESP32 driver's defaults, as the Prism controller (rc2).**
  `WiFi.mode(WIFI_STA)`, the core's own reconnect, `WiFi.begin()`; no
  power-save, country, bandwidth, scan or TX-power call on the station, and
  nothing polls the driver while it connects (the router's signal is read
  only when a report or the app asks). rc1's station profile (power save off,
  country DK, 20 MHz, all-channel scan) is gone; the comparison with Prism's
  code is in the plan, section 2.2.
- **Removed:** the unwired Wi-Fi 2.0 state machine (`wifistate.h`, Stage 4),
  the 0.15.0 leftovers (`netpolicy.h`, `routerguard.h`, the radio test and
  channel survey in `linktune.cpp`, the "rescue looks", the saved failure
  record and the always-0 report fields), and the NVS keys `rch`, `rrsn`,
  `rstage`, `rduration`.
- **Report:** the driver's country code is printed correctly (it was read past
  a 3-byte buffer: `DK ?\x01…`); the radio test, "rescue looks" and failure
  stage lines are gone; `mode` is `standalone`/`router` with `recovery`
  true/false.

## Web

- The 110 KB app page streams from the transfer task like the exports, so a
  phone on a slow link can no longer hold the server task while `/` is sent
  (2026-11-06: `/api/live` answered while `/` took 20 s). One request may wait
  behind a running transfer instead of getting 503; a third still gets 503.

Not changed: J1708 and KAD reading, NMEA 2000, trips, fuel, totals, storage
formats, settings, the update and rollback path, the app's screens apart from
the Wi-Fi texts. Settings and data survive the update.

## Verification (owner; plan section 5)

One bench session on the home 4G router with the PC's `ping -t` and
`netsh wlan show networks mode=bssid` logs running and the Prism controller as
control at the same spot: ≥ 99/100 pings, 20/20 `/api/live` within 2 s,
10/10 `/` within 5 s, 30 min without reason 200 or a fallback, report shows
power save off, country DK, 20 MHz; standalone unchanged. A failure is read
with the table in plan 5.4 — no new build for a diagnosis. Then one trip with
the boat router, including a router power-cycle.
