Kaelor9/EngineLink/docs/releases/v0.16.1.md

# EngineLink 0.16.1 — Wi-Fi from 0.12.15

On the boat, 0.16.0's own Wi-Fi (standalone) would not let the phone join, and then disappeared.

0.16.1 is 0.16.0 with the Wi-Fi code from 0.12.15. That is the last version whose own Wi-Fi was confirmed working on the board: phones joined at 192.168.4.1. The Wi-Fi changes from 0.13 to 0.15 are removed. The router mode is also back to how 0.12.15 worked.

Everything else is as in 0.16.0: the drive test, NMEA 2000 and bus recording.

Update from 0.16.0 keeps everything. Not yet tested on the board.
