Kaelor9/EngineLink/docs/releases/v0.12.15.md

EngineLink 0.12.15: clean-up.

- Removed what was left from the Wi-Fi experiments: the manual transmit power setting, the frame bundling settings and test, the phone-driven transmit power sweep and their stored settings (cleared from the board on first start). Transmit power is tuned by the board alone.
- README and developer guide rewritten for the current state; the old Wi-Fi blocker notes and the outdated change log are gone (release notes stay in docs/releases). New status page: docs/STATUS.md.
- No change to engine reading, fuel, trips or the app's pages.

Settings, trips, the fuel log and fuel totals are kept.
