Kaelor9/EngineLink/docs/releases/v0.12.3.md

EngineLink 0.12.3: keeps the connection that works.

- Report #62 confirmed the working setup with the owner's Zyxel: WPA2 at medium transmit power, logged in in 0.3 s, address in 1.5 s, no drops. One rule could undo that: after any fallback to its own Wi-Fi (for example while the router was off or restarting, as in report #59), EngineLink switched to WPA3 for the next try. It now changes to WPA3 only on clear evidence that the router needs it (a WPA3-only router in the scan, or "no compatible security", codes 210/211), so a router that works with WPA2 stays on WPA2.
- Removed an outdated line from the network report.

Settings, trips, the fuel log and fuel totals are kept.
