Kaelor9/EngineLink/docs/releases/v0.8.0.md

EngineLink 0.8.0: made to survive power cuts, card errors and hangs.

- **A power cut loses at most 30 seconds.** While an engine runs, the fuel totals and the trip are saved every 30 seconds (they were saved every 5 minutes, so switching off at the key could lose several litres). The second-by-second trip log is written to the card every 10 seconds.
- **The SD card comes back by itself.** After a write error with the card still in, EngineLink mounts it again (every minute, later every 5 minutes) and carries on with the raw log and the running trip's log.
- **A watchdog for the whole board.** If the main program ever hangs for a minute, the chip restarts by itself (the engine reading has had its own watchdog since 0.7.9). Long downloads and wiping the card are not mistaken for a hang.
- **Restart log** (Diagnostics → Restarts): the last 8 starts with the reason in plain words (power on, update, brownout, crash, watchdog), when, how long EngineLink had been on before, and the version. A brownout comes with advice on the power wiring.
- **App errors are caught.** The app keeps its own errors for Diagnostics and the technical file, shows a short notice for real ones, and ignores the network hiccups that are normal on a boat.

Settings, trips, the fuel log and fuel totals are kept.
