Kaelor9/EngineLink/docs/releases/v0.7.3.md

EngineLink 0.7.3: no silent stop when the protocol is wrong.

- **No more silent stop when the protocol is wrong.** With the engine protocol set to SAE J1587, EngineLink only listens and never asks the Volvo Penta KAD / EDC I control units, so nothing comes in, even with "Read engines automatically" on. One tap on "Engine protocol" in Diagnostics → Advanced switched it, without asking. Now switching to J1587 asks first and says what it does, and while J1587 is set and no engine is seen, every screen shows "Not reading the engines" with a button that switches back. Automatic reading starts again right after switching.

Settings, trips, the fuel log and fuel totals are kept.
