Kaelor9/EngineLink/docs/releases/v0.7.0.md

EngineLink 0.7.0: diagnostics, a clearer status light and faster reading.

- **EngineLink watches the engines for you.** Every second it checks both engines against fixed limits and against what is normal for each engine at that rpm. It raises an event for: coolant too hot (warning above 95 °C, alarm above 102 °C), charge air too hot, battery too low or too high while running, overspeed, an engine that stops from cruise or stops answering, rpm that does not reach what the lever asks, rpm that hunts while the lever is still, coolant, boost, charge air or fuel slowly drifting away from this engine's normal (CUSUM, so a small but steady change is caught without false alarms from noise), one engine using more fuel or making less boost than the other at the same rpm, full throttle on a cold engine, an engine that stays cold (thermostat), long idling, and status bits that change. A normal trip raises nothing: this is checked with simulated trips in `tools/test_diagrules.cpp`.
- **Events in the app** (Settings → Events, and a card at the top when something needs attention): what happened, what it usually means and what to check, with the phone vibrating for a new warning.
- **Black box.** Every event saves the two minutes before and after, second by second, on the SD card. Open an event to see rpm, lever, fuel, coolant, boost, charge air and battery of both engines around it.
- **"Something's odd" button** (Engines page and Events): heard or felt something? Tap it and the moment is saved with its black box, so you can look at it later.
- **Trip timeline.** Each trip is recorded once a second on the SD card. History → a trip → Timeline shows the curves, and "Download as spreadsheet" gives one row per second with every value of both engines (opens in Excel or Numbers).
- **Last 10 minutes** on the Engines page, as curves.
- **Port and starboard** compares the two engines at the same rpm, from what both learned over the trips: fuel, boost, coolant and charge air. A big fuel or boost difference is shown in orange.
- **Life story** per engine: hours at idle, part load, cruise and full throttle, starts, cold starts, full throttle while cold, time above 95 °C, long idles, the lowest battery voltage at a start, and the best and latest full-throttle rpm (a falling full-throttle rpm points at the hull, the propeller or the engine).
- **Faster reading.** EngineLink asks as fast as the engines answer (down to every 80 ms, it was every 220 ms) and slows down by itself when answers go missing. Values an engine never answers are skipped, so they no longer cost time. Diagnostics → Reading speed shows requests per second and the share answered.
- **Discover more values** (Diagnostics → Reading speed): asks once for every KAD value number from 256 to 319 and lists the ones the engine answers. It uses the same read request as always: nothing is changed in the engine, and no fault codes are read or cleared.
- **Range with ±**: the range now carries the same uncertainty as the fuel aboard.
- **A status light you can read.** New colours and rhythms that cannot be mixed up:

| Light | Meaning | What to do |
|---|---|---|
| White, fast blink | Updating firmware | Keep the power on |
| Red, fast blink | Engine alarm (for example coolant too hot) | Look at Events in the app now |
| Long red, then short blue | SD card error: nothing is saved | Take out the card and put it back, or replace it |
| Three short red blinks, pause | Engine data fault (J1708 garbled or overflowing) | Check the engine connectors and cables |
| Two short orange blinks, pause | Engine warning (a value outside what is normal for that engine) | Look at Events in the app |
| Short blue, then long orange | No SD card | Everything works, but trips and raw data are not saved |
| Magenta, slow blink (1 s on, 1 s off) | Recording a motor test | – |
| Blue, breathing | Setup not finished | Join the EngineLink Wi-Fi and open the app |
| Long green, then short blue | Boat router not reached | EngineLink's own Wi-Fi still works |
| Green, dark for a moment every 2 s | Reading the engines, all is well | – |
| Green, steady | Ready, engines off or not being read | – |
| White, steady | Starting | – |
| Three quick magenta flashes | "Something's odd" mark was saved | – |

Settings, trips, the fuel log and fuel totals are kept. Trips from before 0.7.0 have no timeline.
