Kaelor9/EngineLink/docs/releases/v0.6.0.md

EngineLink 0.6.0: much more exact fuel figures.

- **Calibration from fill-ups that knows how exact each one is.** When you log a fill-up you choose "Nozzle clicked off", "Topped up to the filler pipe" or "Not full". Every pair of full tanks becomes one equation, weighted by how exact both fill-ups were. Partial fill-ups in between are added to the pump litres. The calibration is solved again from the whole log after every change, so correcting or deleting an entry also undoes its effect.
- **Correction per engine-speed band.** Fuel is now counted separately at idle (under 1,100 rpm), part load and cruise (2,500 rpm and up). With fill-ups from different kinds of trips EngineLink learns whether the engines are more off at idle than at cruise; with few fill-ups it uses one common factor. Fuel is stored as raw counts, so every trip and the tank level are recalculated whenever the calibration improves.
- **Honest uncertainty.** The app shows how exact the fuel figures are ("within about ±4 %"), and fuel aboard carries its own ± that grows with litres counted and shrinks with good fill-ups.
- **Odd fill-ups are caught.** A fill-up that disagrees with all the others by more than 3× the expected spread is set aside, and the fuel log asks whether the tank was really full. You decide whether it counts.
- **Engine answers are checked.** Each value has physical limits and a largest believable change between two answers. A sudden jump is held back until the next answer confirms it; impossible values are dropped. This way a garbled reply never reaches the fuel totals.
- **Short gaps are bridged.** If fuel answers are lost for up to 2 minutes while the engine keeps answering for rpm, the fuel in between is interpolated and counted, and Diagnostics shows how much.
- **Adaptive reading.** While the throttle moves, fuel is asked for more often (every second request), so the litres follow fast changes closely.
- **Learn the gear** (Diagnostics → Calibration): shift N, F, N, R, N at the dock while EngineLink watches the gear value; it finds which bits mean forward and reverse. Until then the gear shows "Not learned" instead of guessing.
- **"Load" is no longer a headline value.** KAD index 288 reads 80–90 % at idle, so its meaning is not confirmed; it is off by default and labelled as unconfirmed, as is "Fuel rack".
- **Raw engine data gets its own download button** when exporting trips, because phones allow only one download per tap.
- Existing trips, fill-ups and totals are converted. Fill-ups from before 0.6.0 count as "nozzle clicked off" until you change them in the fuel log.

Settings, trips, the fuel log and fuel totals are kept.
