Kaelor9/EngineLink/docs/releases/v0.5.5.md

EngineLink 0.5.5: fewer Wi-Fi drops.

- **The network watchdog no longer drops phones.** The ESP32 also reports "network stopped" (late) when the network only changed a setting such as its channel. The watchdog took that as a failure and restarted the network, and every restart also set the country again, which on its own makes the network start over and drops every phone. Now the watchdog only acts when the network is really gone (stopped and not started again for 3 seconds, or switched off), and the country is only set when it is not already right.
- **Address name in Settings.** EngineLink answers at http://enginelink.local (mDNS) on its own network and on the boat router, and the router also sees it under that name. The name can be changed under Settings → EngineLink Wi-Fi → Address in the browser (letters, digits and hyphens). http://192.168.4.1 always works on the EngineLink network. EngineLink deliberately does not act as the phone's DNS server: it would answer "not found" for every other name and could cut the phone off the internet over mobile data.
- Diagnostics → Wi-Fi also shows phone drops with the reason for the last one (for example "the phone left by itself (it may have switched to another Wi-Fi)"), channel changes and the slowest pass of the main loop. Restart code 11 now reads "USB (flashing or serial monitor)".

Settings, trips, the fuel log and fuel totals are kept.
