Kaelor9/EngineLink/docs/releases/v0.5.0.md

EngineLink 0.5.0: the new phone app.

- New app with Trip, Economy, Tank, History and Engines pages, light/dark/night themes, metric or imperial units and your own currency. Add it to the home screen as "Engine Link".
- Trips are recorded automatically and survive restarts. Add notes (people, sea, wind), combine or split trips, export CSV.
- Fuel log: log fill-ups, see fuel aboard and range. A full fill-up fine-tunes the fuel factor by itself.
- Economy: best cruising speed, a trip planner, season statistics per RPM band and an engine health trend.
- Much steadier Wi-Fi: power saving off, full transmit power, the EngineLink network stays on one channel and never restarts because of a router, sleeping phones are kept for 10 minutes, and a watchdog restarts the access point if it ever stops.
- Firmware updates straight from GitHub when EngineLink is on a router with internet. A new version that does not run properly for its first minute is rolled back automatically.
- Diagnostics: setup check, 30-second connection test per engine, calibration and raw values.
- "Read engines automatically" is off by default and must be switched on with a confirmation.

Settings, fuel totals and engine hours from 0.4.x are kept. Update over Wi-Fi with enginelink-update.bin, or over USB with firmware.bin from the download page.
