Kaelor9/EngineLink/docs/releases/v0.7.6.md

EngineLink 0.7.6: a steadier, faster connection.

- **Downloads are compressed.** When the browser accepts it (all current ones do), CSV files and raw data are sent deflate-compressed with the compressor built into the chip. CSV shrinks 5–8 times, so a weak link carries that much more and a download takes that much less time. The file you get is the normal CSV. Diagnostics → Wi-Fi → Last download shows how much it was compressed.
- **The engines keep being read during a download.** A download used to stop everything else on EngineLink until it was done, so reading the engines, the trip and the diagnosis paused (and a long one could cut an engine run in two). Between pieces of a download EngineLink now handles the engine messages, sends its read requests, keeps the trip and the diagnosis going and updates the status light.
- **Every download goes out in large pieces**, also the raw log, engine runs and motor test files.
- **20 MHz channels.** The EngineLink Wi-Fi and the connection to the boat router use 20 MHz channels instead of 40 MHz. 40 MHz on 2.4 GHz overlaps the neighbouring networks and is the first thing to fail where it is crowded or the signal is weak.
- **The quietest channel without a router.** Without a boat router EngineLink now listens on channels 1, 6 and 11 at start-up and takes the one with the least other Wi-Fi nearby (a marina can have dozens of networks). With a router it keeps using the router's channel, as it must.
- **The app asks less often on a slow link.** It times EngineLink's answers and spaces its live updates to match (every 0.5 s on a good link, up to every 2 s on a weak one), so requests no longer queue up behind each other.

Settings, trips, the fuel log and fuel totals are kept.
