Kaelor9/EngineLink/docs/releases/v0.7.5.md

EngineLink 0.7.5: download speed test.

- **Find out what makes a download slow.** Diagnostics → Wi-Fi has a new **Test download speed** button: EngineLink sends 512 kB from memory, without the SD card, so the result is the Wi-Fi alone, and it says whether that went over the EngineLink Wi-Fi or the boat router, with the signal. Below it, **Last download** splits the last raw-data export into finding the trip, reading the SD card and sending, and says which took the time.

Settings, trips, the fuel log and fuel totals are kept.
