Kaelor9/EngineLink/docs/releases/v0.5.2.md

EngineLink 0.5.2: a steadier Wi-Fi connection.

- **Web server rebuilt for a steady connection.** The stock ESP32 web server serves one connection at a time, so a connection the iPhone opened ahead of time, or one that stalled during a Wi-Fi blip, held up every other request for up to 5 seconds and the app showed "Reconnecting". EngineLink now accepts all connections at once, answers whichever has a request, and keeps connections open between requests (keep-alive), so the live updates reuse one connection instead of opening a new one twice a second.
- **Connecting to the boat router no longer restarts the EngineLink network.** The router's channel is taken from the scan you picked it from (no second scan that hops channels), and the network only moves channel when the router is on another one; the app says so.
- **The app keeps working when the phone joins the boat router.** EngineLink answers through the router too, and the app finds it there (its router address or enginelink.local) by itself.
- A router that hands out 192.168.4.x addresses (the same as EngineLink) is detected; EngineLink leaves it and the app explains what to change.
- Diagnostics shows a new Wi-Fi section: phones, channel, network restarts, requests, slowest answer, updates missed on this phone, and the reason for the last restart (for example low voltage).

Settings, trips, the fuel log and fuel totals are kept.
