Kaelor9/EngineLink/tools/boat-studio/chosen.png

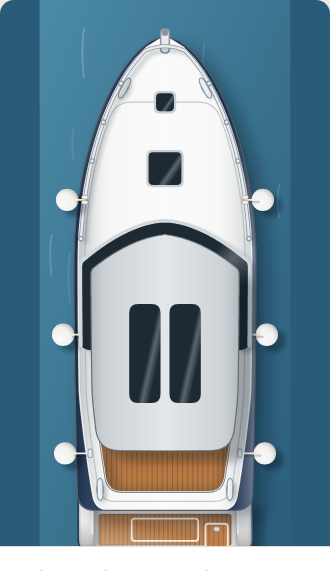
tools/boat-studio/chosen.png
