Kaelor9/EngineLink/docs/hardware/thermal-tests/README.md

# EngineLink thermal tests

Upload thermal camera photos and videos of the EngineLink PCB to this directory. Keep original timestamps and filenames where possible.

Initial thermal image captured 2026-11-06 12:46:56 shows markers at 45.7 °C and 36.8 °C. These are image annotations, not independently calibrated measurements.

## Files

| File | Type | Notes |
|---|---|---|
| `IMG_0215.JPG` | Thermal photo | Captured 2026-11-06 12:46:56. Spot markers 45.7 °C (near USB/power area) and 36.8 °C (board centre). |
| `1793965700195.MP4` | Thermal video | ~92 s, ~100 MB. Original filename kept. |
