Kaelor9/EngineLink/docs/hardware/thermal-tests/IMG_0215.JPG

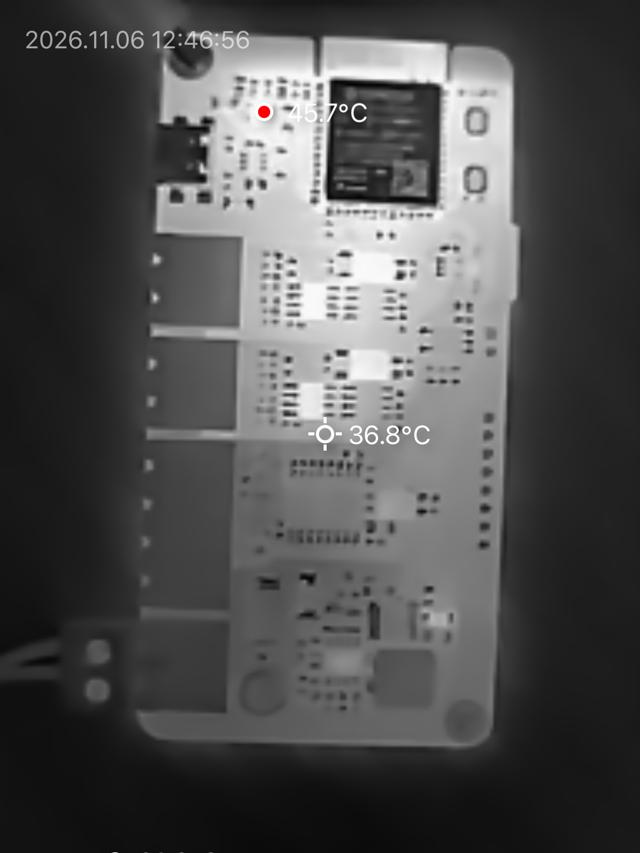
docs/hardware/thermal-tests/IMG_0215.JPG
