Kaelor9/EngineLink/hardware/kicad/ESP32-S3-WROOM-1-N8R8.kicad_pcb

## KiCad design hardware/kicad/ESP32-S3-WROOM-1-N8R8.kicad_pcb (2026-11-14)

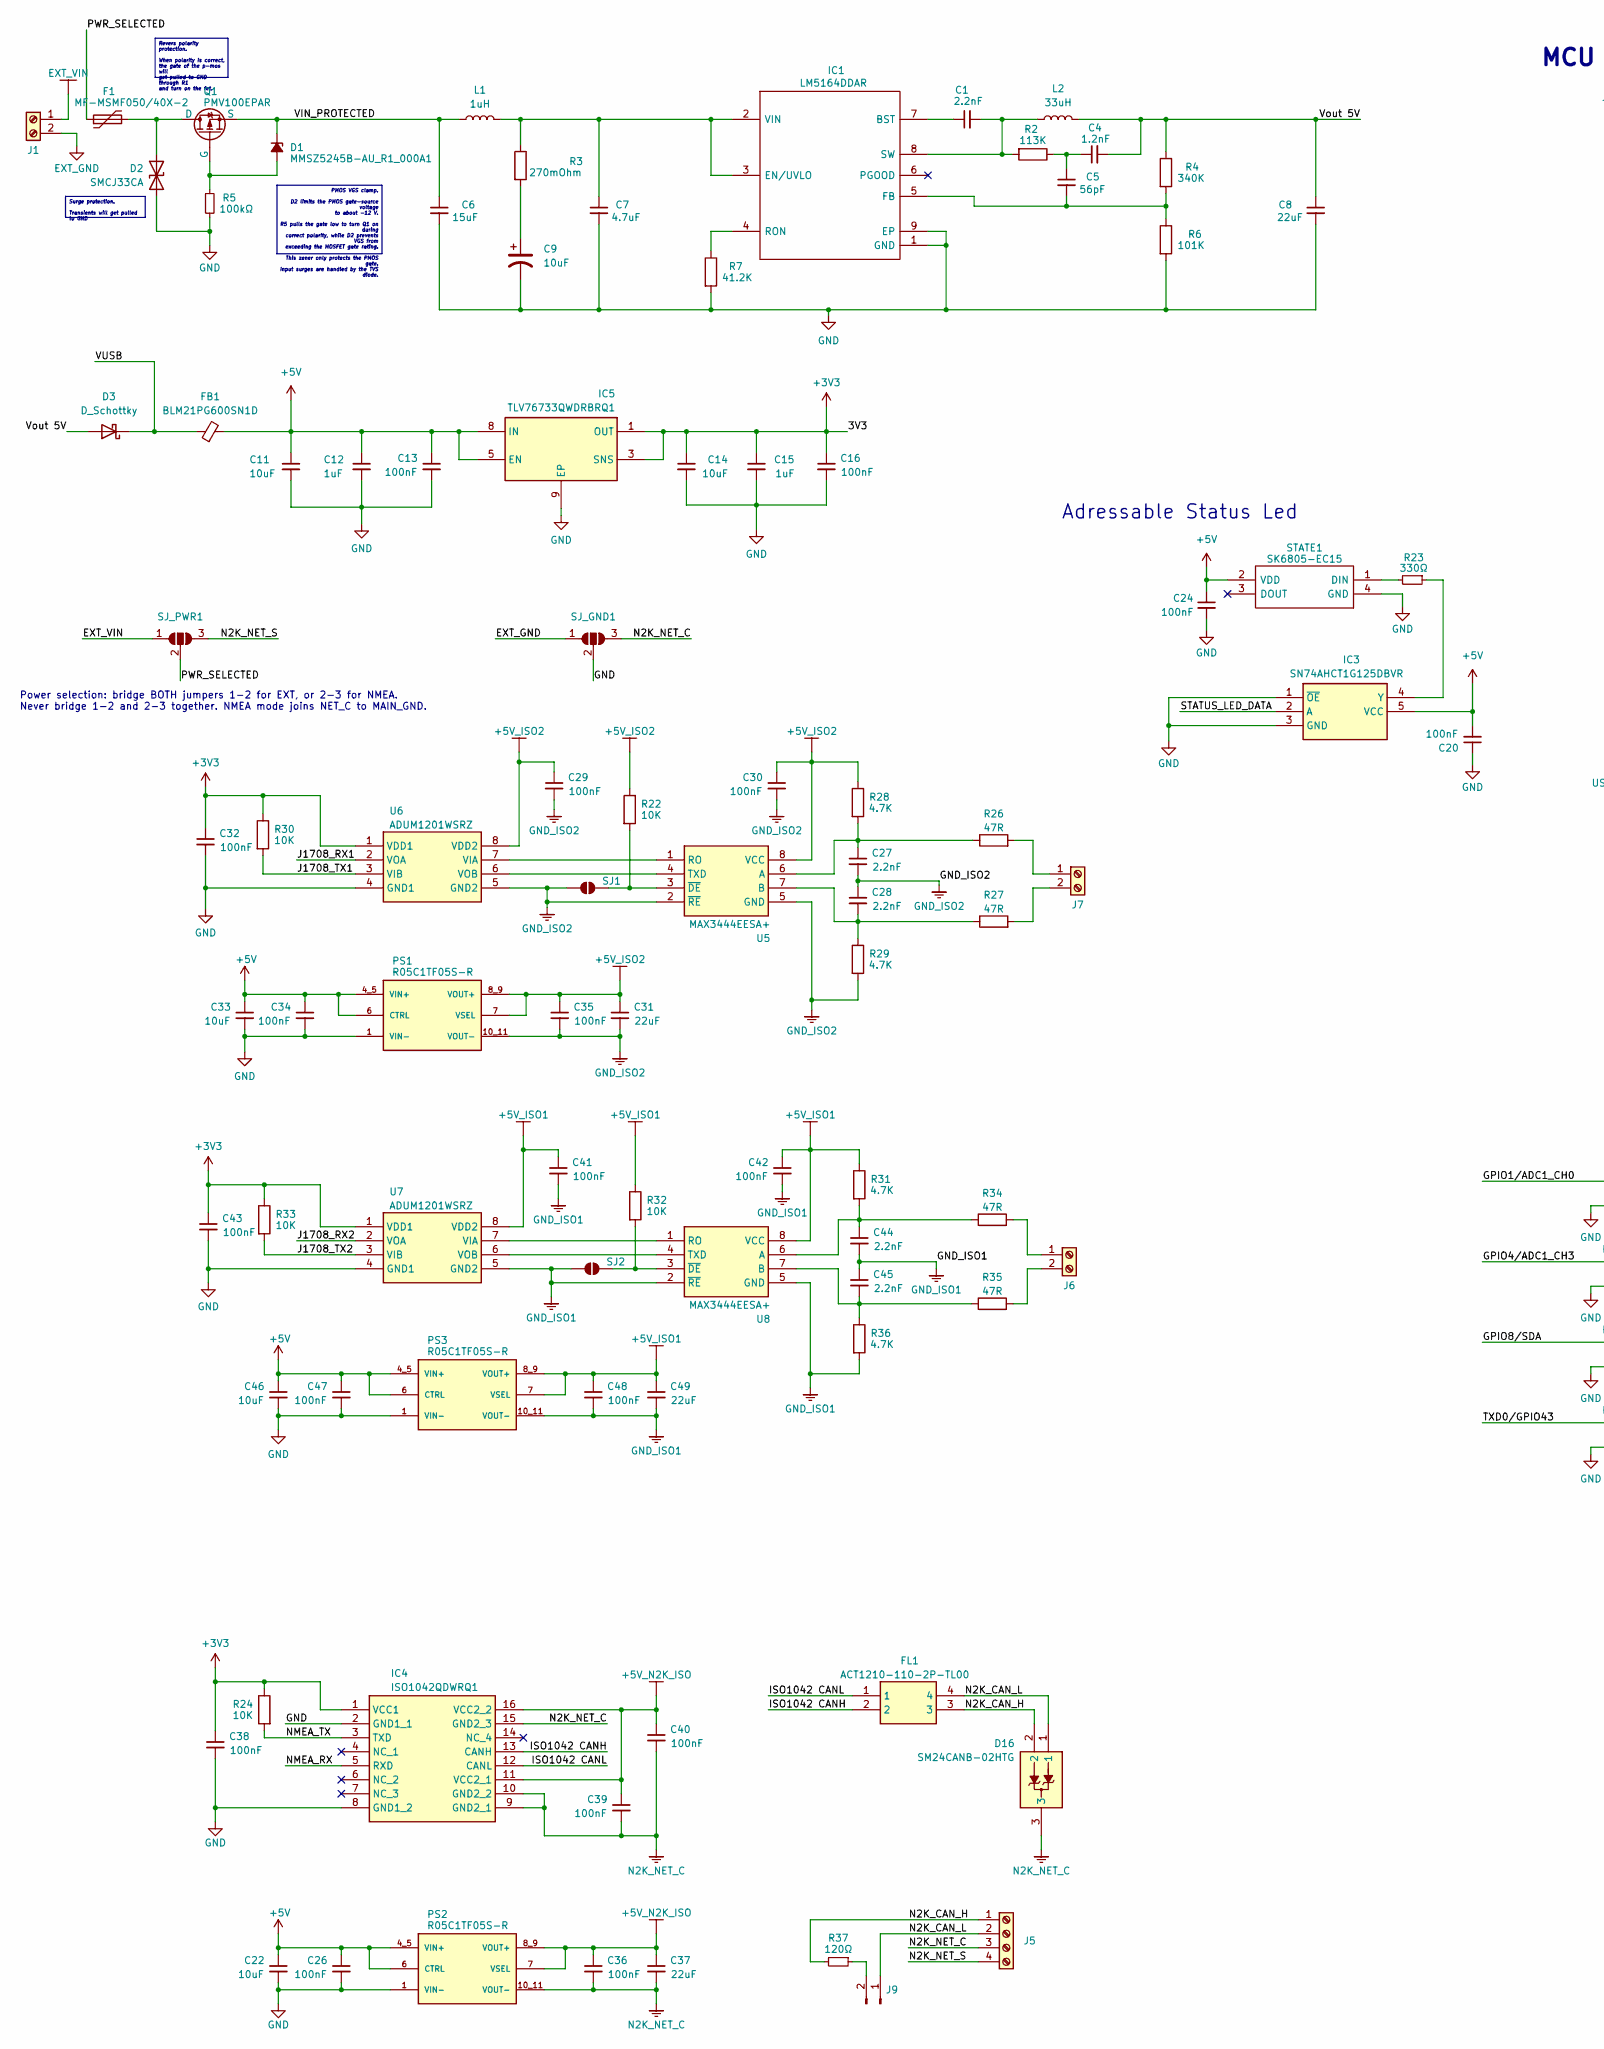
[picture p5: schematic ESP32-S3-WROOM-1-N8R8.kicad_sch, part in row 1, column 1]

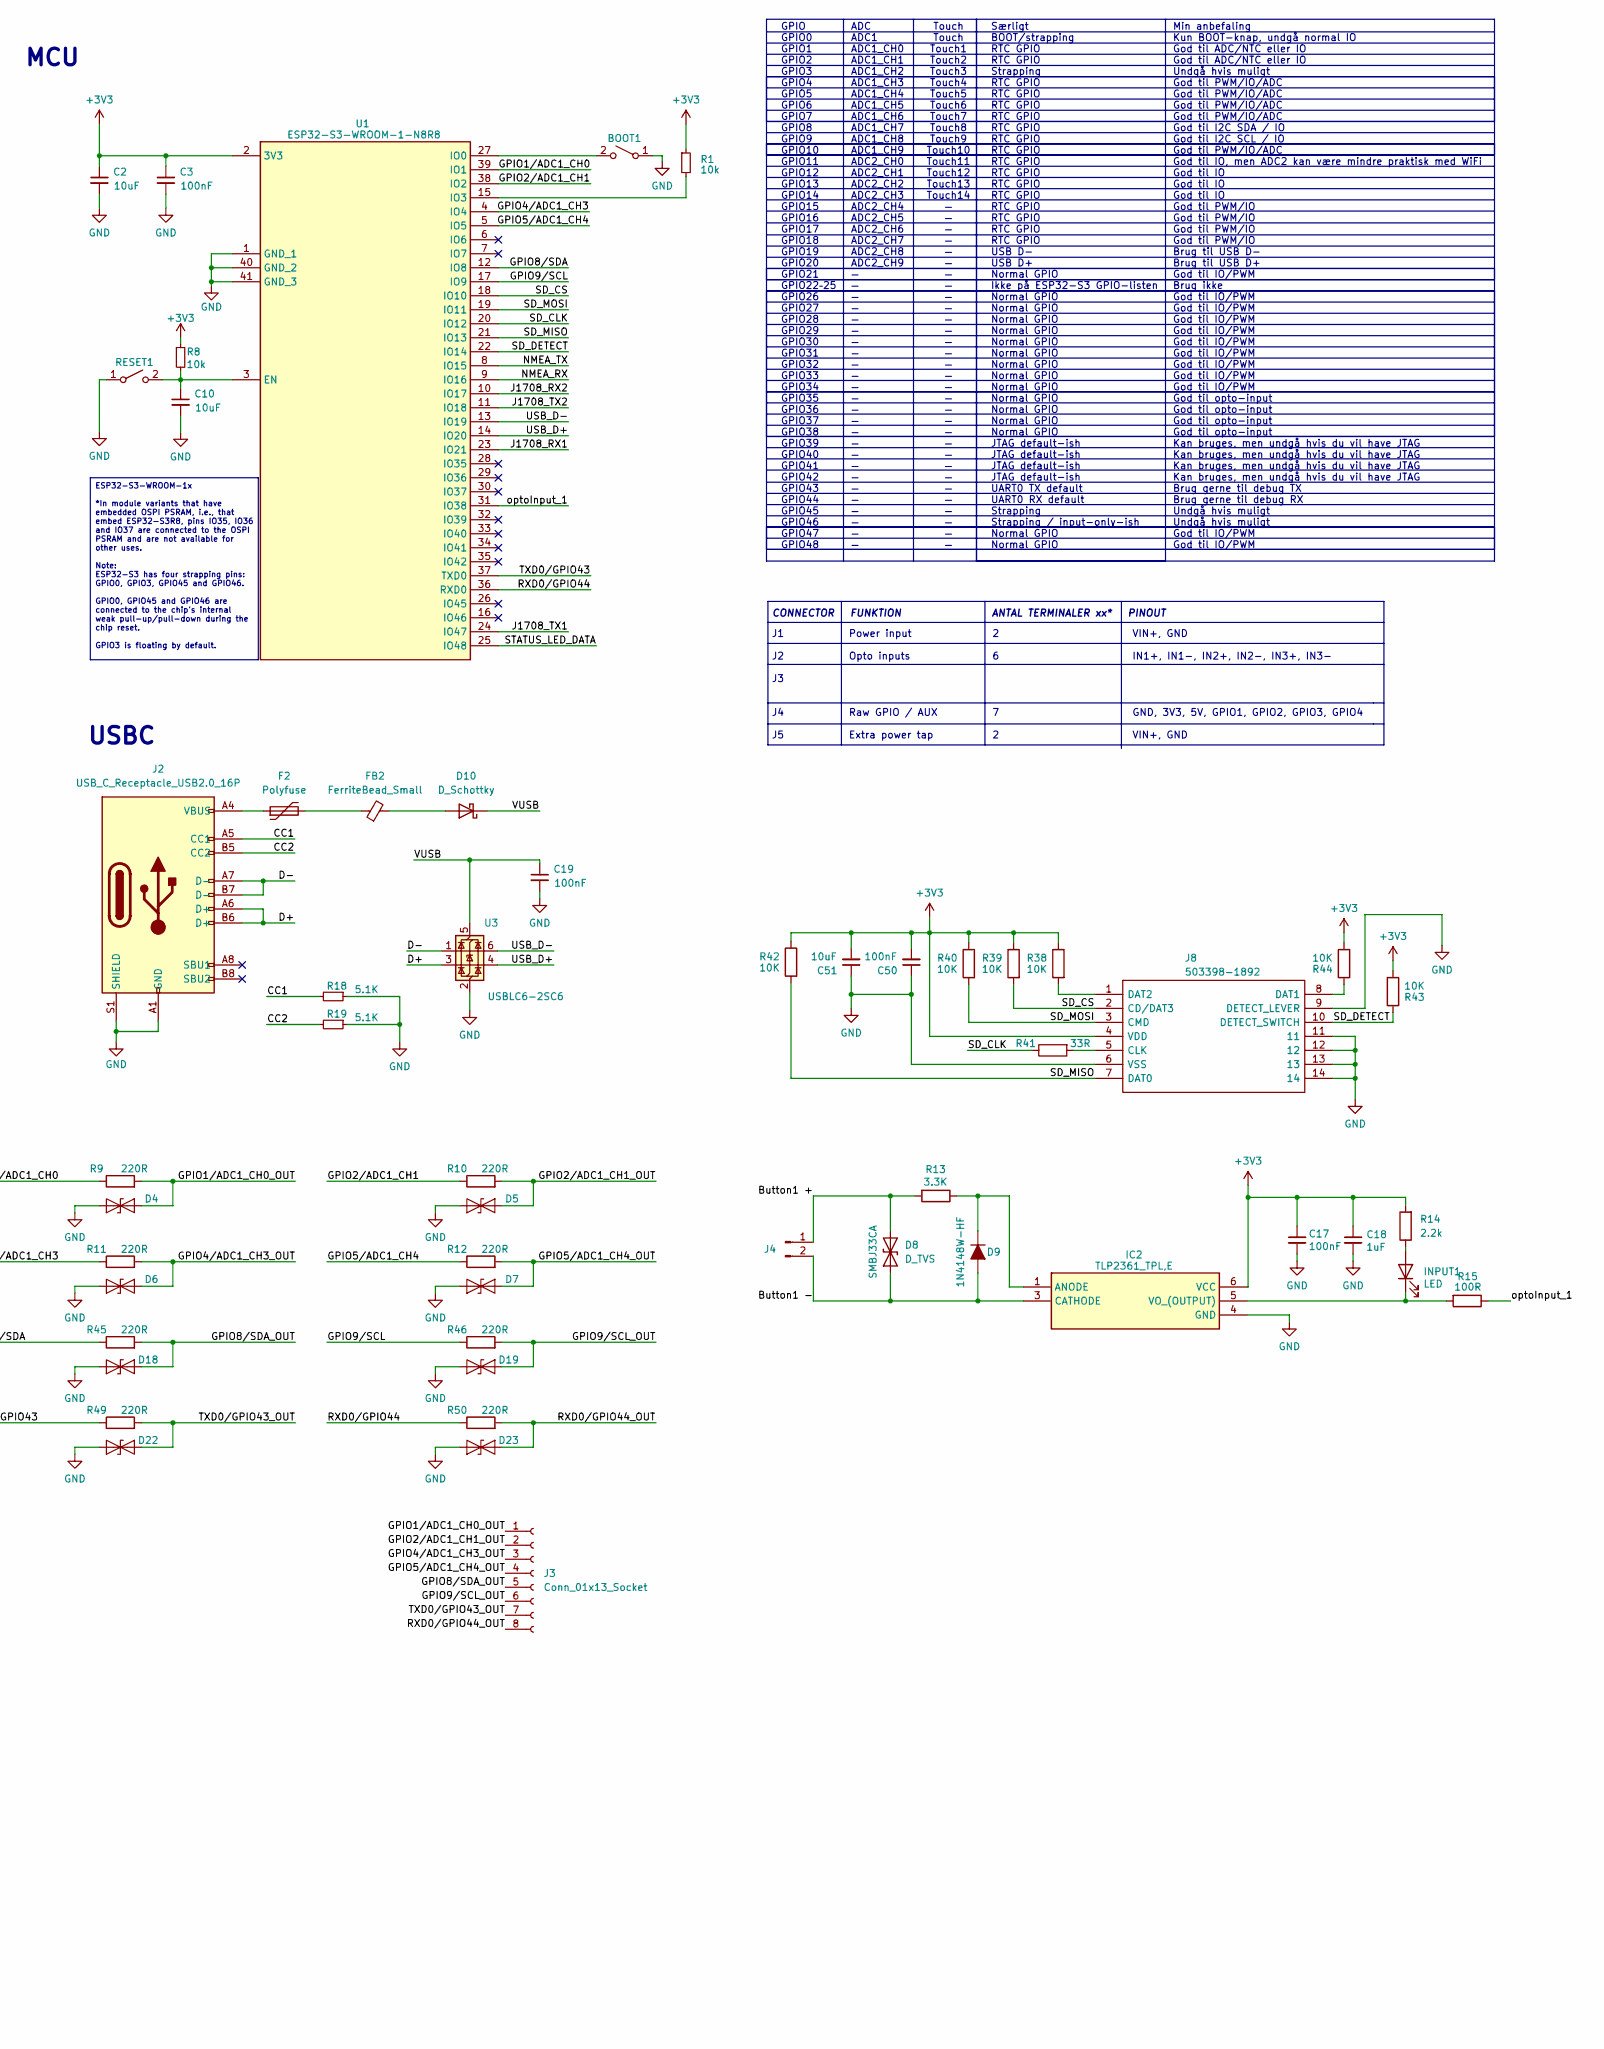
[picture p6: schematic ESP32-S3-WROOM-1-N8R8.kicad_sch, part in row 1, column 2]

Parts:
BOOT1: PTS810SJM250SMTRLFS
C1: 2.2nF; C_0805_2012Metric; Voltage Rating VDC 50V
C2, C10, C51: 10uF; C_0603_1608Metric; Voltage Rating VDC 25V
C3, C13, C16, C17, C19, C20, C26, C29, C30, C32, C34, C35, C36, C38, C39, C40, C41, C42, C43, C47, C48, C50: 100nF; C_0603_1608Metric; Voltage Rating VDC 50V
C4: 1.2nF; C_0402_1005Metric; Voltage Rating VDC 50V
C5: 56pF; C_0805_2012Metric; Voltage Rating VDC 50V
C6: 15uF; C_2220_5750Metric; Voltage Rating VDC 100V
C7: 4.7uF; C_1206_3216Metric; Voltage Rating VDC 50V
C8: 22uF; C_1206_3216Metric; Voltage Rating VDC 10V
C9: 10uF; CAPAE660X610N; Voltage Rating VDC 50V
C11, C14: 10uF; C_1206_3216Metric; Voltage Rating VDC 16V
C12, C15: 1uF; C_0805_2012Metric; Voltage Rating VDC 25V
C18: 1uF; C_0805_2012Metric; Voltage Rating VDC 50V
C22, C33, C46: 10uF; C_0805_2012Metric; Voltage Rating VDC 10V
C24: 100nF; C_0402_1005Metric; Voltage Rating VDC 50V
C27, C28, C44, C45: 2.2nF; C_0603_1608Metric; Voltage Rating VDC 50V
C31, C37, C49: 22uF; C_1206_3216Metric; Voltage Rating VDC 50V
D1: MMSZ5245B-AU_R1_000A1; D_SOD-123
D2: SMCJ33CA; D_SMC
D3, D10: D_Schottky; D_SOD-123
D4, D5, D6, D7, D18, D19, D22, D23: SD05_SOD323; D_SOD-323
D8: D_TVS; D_SMB
D9: D_SOD-123
D16: SM24CANB-02HTG; SM24CANB02HTG
F1: MF-MSMF050/40X-2; MFMSMF05040X2
F2: Polyfuse; Fuse_1206_3216Metric
FB1: BLM21PG600SN1D; R_0805_2012Metric
FB2: FerriteBead_Small; R_0805_2012Metric
FL1: ACT1210-110-2P-TL00; ACT12101102PTL00
IC1: LM5164DDAR; SOIC127P600X170-9N
IC2: TLP2361_TPL,E; 11-4L1S_5-PIN-SOIC_
IC3: SN74AHCT1G125DBVR; SOT95P280X145-5N
IC4: ISO1042QDWRQ1; SOIC127P1030X265-16N
IC5: TLV76733QWDRBRQ1; SON65P300X300X100-9N-D
INPUT1: LED; LED_0603_1608Metric
J1, J6, J7: Screw_Terminal_01x02; 1757242
J2: USB_C_Receptacle_USB2.0_16P; USB494000A
J3: Conn_01x13_Socket; PinHeader_1x08_P2.54mm_Vertical
J4, J9: Conn_01x02_Pin; PinHeader_1x02_P2.54mm_Vertical
J5: 1757268
J8: 503398-1892; 5033981892
L1: 1uH; L_1008_2520Metric
L2: 33uH; 3232 (8282 metric)
PS1, PS2, PS3: R05C1TF05S-R; CONV_R05C1TF05S-R
Q1: PMV100EPAR; TSOT-23
R1, R8: 10k; R_0603_1608Metric
R2: 113K; R_0603_1608Metric
R3: 270mOhm; R_0603_1608Metric
R4: 340K; R_0603_1608Metric
R5: 100kΩ; R_0402_1005Metric
R6: 101K; R_0805_2012Metric
R7: 41.2K; R_0805_2012Metric
R9, R10, R11, R12, R45, R46, R49, R50: 220R; R_0805_2012Metric; Voltage Rating VDC 150V
R13: 3.3K; R_1206_3216Metric
R14: 2.2k; R_0603_1608Metric
R15: 100R; R_0603_1608Metric
R18, R19: 5.1K; R_0603_1608Metric; Voltage Rating VDC 150V
R22, R24, R30, R32, R33, R38, R39, R40, R42, R43, R44: 10K; R_0603_1608Metric
R23: 330Ω; R_0402_1005Metric
R26, R27, R34, R35: 47R; R_0603_1608Metric
R28, R29, R31, R36: 4.7K; R_0603_1608Metric
R37: 120Ω; R_0603_1608Metric
R41: 33R; R_0603_1608Metric
RESET1: PTS810SJM250SMTRLFS
SJ1, SJ2: SJ1J1708_TX_ENABLE; SolderJumper-2_P1.3mm_Open_TrianglePad1.0x1.5mm
SJ_GND1: SolderJumper_3_Open; SolderJumper-3_P1.3mm_Open_Pad1.0x1.5mm_NumberLabels
SJ_PWR1: SolderJumper_3_Open; SolderJumper-3_P1.3mm_Open_Pad1.0x1.5mm_NumberLabels
STATE1: SK6805-EC15; SK6805EC15
U1: ESP32-S3-WROOM-1-N8R8; ESP32S3WROOM1N8R8
U3: USBLC6-2SC6; SOT-23-6
U5, U8: MAX3444EESA+; SOIC127P600X175-8N
U6, U7: ADUM1201WSRZ; SOIC127P600X175-8N

Connections:
+3V3: C2.1, C3.1, C14.1, C15.1, C16.1, C17.1, C18.1, C32.1, C38.1, C43.1, C50.2, C51.2, IC2.6 (VCC), IC4.1 (VCC1), IC5.1 (OUT), IC5.3 (SNS), J8.4 (VDD), R1.1, R8.1, R14.2, R24.1, R30.1, R33.1, R38.1, R39.1, R40.1, R42.1, R43.2, R44.2, U1.2 (3V3), U6.1 (VDD1), U7.1 (VDD1)
+5V: C11.1, C12.1, C13.1, C20.2, C22.1, C24.1, C26.1, C33.1, C34.1, C46.1, C47.1, FB1.2, IC3.5 (VCC), IC5.5 (EN), IC5.8 (IN), PS1.4_5 (VIN+), PS1.6 (CTRL), PS2.4_5 (VIN+), PS2.6 (CTRL), PS3.4_5 (VIN+), PS3.6 (CTRL), STATE1.2 (VDD)
+5V_ISO1: C41.1, C42.1, C48.1, C49.1, PS3.7 (VSEL), PS3.8_9 (VOUT+), R31.1, R32.1, U7.8 (VDD2), U8.8 (VCC)
+5V_ISO2: C29.1, C30.1, C31.1, C35.1, PS1.7 (VSEL), PS1.8_9 (VOUT+), R22.1, R28.1, U5.8 (VCC), U6.8 (VDD2)
+5V_N2K_ISO: C36.1, C37.1, C39.1, C40.1, IC4.11 (VCC2_1), IC4.16 (VCC2_2), PS2.7 (VSEL), PS2.8_9 (VOUT+)
/Button1 +: D8.2 (A2), J4.1, R13.2
/Button1 -: D8.1 (A1), D9.2 (A), IC2.3 (CATHODE), J4.2
/CC1: J2.A5 (CC1), R18.2
/CC2: J2.B5 (CC2), R19.2
/D+: J2.A6 (D+), J2.B6 (D+), U3.3 (I/O2)
/D-: J2.A7 (D-), J2.B7 (D-), U3.1 (I/O1)
/GPIO1/ADC1_CH0: R9.1, U1.39 (IO1)
/GPIO1/ADC1_CH0_OUT: D4.2 (A2), J3.1, R9.2
/GPIO2/ADC1_CH1: R10.1, U1.38 (IO2)
/GPIO2/ADC1_CH1_OUT: D5.2 (A2), J3.2, R10.2
/GPIO4/ADC1_CH3: R11.1, U1.4 (IO4)
/GPIO4/ADC1_CH3_OUT: D6.2 (A2), J3.3, R11.2
/GPIO5/ADC1_CH4: R12.1, U1.5 (IO5)
/GPIO5/ADC1_CH4_OUT: D7.2 (A2), J3.4, R12.2
/GPIO6/ADC1_CH5: U1.6 (IO6)
/GPIO7/ADC1_CH6: U1.7 (IO7)
/GPIO8/SDA: R45.1, U1.12 (IO8)
/GPIO8/SDA_OUT: D18.2 (A2), J3.5, R45.2
/GPIO9/SCL: R46.1, U1.17 (IO9)
/GPIO9/SCL_OUT: D19.2 (A2), J3.6, R46.2
/GPIO40: U1.33 (IO40)
/GPIO41: U1.34 (IO41)
/GPIO42: U1.35 (IO42)
/ISO1042 CANH: FL1.2, IC4.13 (CANH)
/ISO1042 CANL: FL1.1, IC4.12 (CANL)
/J1708_RX1: U1.23 (IO21), U6.2 (VOA)
/J1708_RX2: U1.10 (IO17), U7.2 (VOA)
/J1708_TX1: R30.2, U1.24 (IO47), U6.3 (VIB)
/J1708_TX2: R33.2, U1.11 (IO18), U7.3 (VIB)
/N2K_CAN_H: D16.2, FL1.3, J5.1, R37.2
/N2K_CAN_L: D16.1, FL1.4, J5.2, J9.1
/N2K_NET_S: J5.4, SJ_PWR1.3 (B)
/NMEA_RX: IC4.5 (RXD), U1.9 (IO16)
/NMEA_TX: IC4.3 (TXD), R24.2, U1.8 (IO15)
/PWR_SELECTED: F1.1, SJ_PWR1.2 (C)
/RXD0/GPIO44: R50.1, U1.36 (RXD0)
/RXD0/GPIO44_OUT: D23.2 (A2), J3.8, R50.2
/SD_CLK: R41.1, U1.20 (IO12)
/SD_CS: J8.2 (CD/DAT3), R39.2, U1.18 (IO10)
/SD_DETECT: J8.10 (DETECT_SWITCH), R43.1, U1.22 (IO14)
/SD_MISO: J8.7 (DAT0), R42.2, U1.21 (IO13)
/SD_MOSI: J8.3 (CMD), R40.2, U1.19 (IO11)
/STATUS_LED_DATA: IC3.2 (A), U1.25 (IO48)
/TXD0/GPIO43: R49.1, U1.37 (TXD0)
/TXD0/GPIO43_OUT: D22.2 (A2), J3.7, R49.2
/USB_D+: U1.14 (IO20), U3.4 (I/O2)
/USB_D-: U1.13 (IO19), U3.6 (I/O1)
/VIN_PROTECTED: C6.1, D1.1 (K), L1.1, Q1.2 (S)
/VUSB: C19.1, D3.1 (K), D10.1 (K), FB1.1, U3.5 (VBUS)
/Vout 5V: C4.2, C8.1, D3.2 (A), L2.2, R4.1
/optoInput_1: R15.1, U1.31 (IO38)
EXT_GND: J1.2, SJ_GND1.1 (A)
EXT_VIN: J1.1, SJ_PWR1.1 (A)
GND: BOOT1.1 (A), C2.2, C3.2, C6.2, C7.2, C8.2, C9.2, C10.2, C11.2, C12.2, C13.2, C14.2, C15.2, C16.2, C17.2, C18.2, C19.2, C20.1, C22.2, C24.2, C26.2, C32.2, C33.2, C34.2, C38.2, C43.2, C46.2, C47.2, C50.1, C51.1, D2.2 (A2), D4.1 (A1), D5.1 (A1), D6.1 (A1), D7.1 (A1), D18.1 (A1), D19.1 (A1), D22.1 (A1), D23.1 (A1), IC1.1 (GND), IC1.9 (EP), IC2.4 (GND), IC3.1 (~OE), IC3.3 (GND), IC4.2 (GND1_1), IC4.8 (GND1_2), IC5.4 (GND_1), IC5.6 (GND_2), IC5.9 (EP), J2.A1 (GND), J2.A12 (GND), J2.B1 (GND), J2.B12 (GND), J2.S1 (SHIELD), J8.6 (VSS), J8.9 (DETECT_LEVER), J8.11, J8.12, J8.13, J8.14, PS1.1 (VIN-), PS1.2_3 (VIN-), PS2.1 (VIN-), PS2.2_3 (VIN-), PS3.1 (VIN-), PS3.2_3 (VIN-), R5.2, R6.2, R7.2, R18.1, R19.1, RESET1.1 (A), SJ_GND1.2 (C), STATE1.4 (GND), U1.1 (GND_1), U1.40 (GND_2), U1.41 (GND_3), U1.42 (GND_4), U1.43 (GND_5), U1.44 (GND_6), U1.45 (GND_7), U1.46 (GND_8), U1.47 (GND_9), U1.48 (GND_10), U1.49 (GND_11), U3.2 (GND), U6.4 (GND1), U7.4 (GND1)
GND_ISO1: C41.2, C42.2, C44.2, C45.1, C48.2, C49.2, PS3.10_11 (VOUT-), PS3.12 (VOUT-), R36.2, SJ2.1 (A), U7.5 (GND2), U8.2 (~RE), U8.5 (GND)
GND_ISO2: C27.2, C28.1, C29.2, C30.2, C31.2, C35.2, PS1.10_11 (VOUT-), PS1.12 (VOUT-), R29.2, SJ1.1 (A), U5.2 (~RE), U5.5 (GND), U6.5 (GND2)
N2K_NET_C: C36.2, C37.2, C39.2, C40.2, D16.3, IC4.9 (GND2_1), IC4.10 (GND2_2), IC4.15 (GND2_3), J5.3, PS2.10_11 (VOUT-), PS2.12 (VOUT-), SJ_GND1.3 (B)
unnamed: BOOT1.2 (B), U1.27 (IO0)
unnamed: C4.1, C5.1, R2.1
unnamed: C9.1, R3.2
unnamed: D1.2 (A), Q1.1 (G), R5.1
unnamed: D2.1 (A1), F1.2, Q1.3 (D)
unnamed: D9.1 (K), IC2.1 (ANODE), R13.1
unnamed: D10.2 (A), FB2.2
unnamed: F2.1, J2.A4 (VBUS), J2.A9 (VBUS), J2.B4 (VBUS), J2.B9 (VBUS)
unnamed: F2.2, FB2.1
unnamed: C1.1, IC1.7 (BST)
unnamed: C7.1, IC1.2 (VIN), IC1.3 (EN/UVLO), L1.2, R3.1
unnamed: C5.2, IC1.5 (FB), R4.2, R6.1
unnamed: IC1.4 (RON), R7.1
unnamed: C1.2, IC1.8 (SW), L2.1, R2.2
unnamed: IC2.5 (VO_(OUTPUT)), INPUT1.1 (K), R15.2
unnamed: IC3.4 (Y), R23.1
unnamed: INPUT1.2 (A), R14.1
unnamed: J6.1, R34.2
unnamed: J6.2, R35.2
unnamed: J7.1, R26.2
unnamed: J7.2, R27.2
unnamed: J8.5 (CLK), R41.2
unnamed: J8.8 (DAT1), R44.1
unnamed: J8.1 (DAT2), R38.2
unnamed: J9.2, R37.1
unnamed: C10.1, R8.2, RESET1.2 (B), U1.3 (EN)
unnamed: R22.2, SJ1.2 (B), U5.3 (~DE)
unnamed: R32.2, SJ2.2 (B), U8.3 (~DE)
unnamed: R23.2, STATE1.1 (DIN)
unnamed: R1.2, U1.15 (IO3)
unnamed: C27.1, R26.1, R28.2, U5.6 (A)
unnamed: C28.2, R27.1, R29.1, U5.7 (B)
unnamed: U5.1 (RO), U6.7 (VIA)
unnamed: U5.4 (TXD), U6.6 (VOB)
unnamed: U7.7 (VIA), U8.1 (RO)
unnamed: U7.6 (VOB), U8.4 (TXD)
unnamed: C44.1, R31.2, R34.1, U8.6 (A)
unnamed: C45.2, R35.1, R36.1, U8.7 (B)

Notes on the sheet:
Revers polarity protection. When polarity is correct, the gate of the p-mos will get pulled to GND through R1 and turn on the fet.
ESP32-S3-WROOM-1x *In module variants that have embedded OSPI PSRAM, i.e., that embed ESP32-S3R8, pins IO35, IO36 and IO37 are connected to the OSPI PSRAM and are not available for other uses. Note: ESP32-S3 has four strapping pins: GPIO0, GPIO3, GPIO45 and GPIO46. GPIO0, GPIO45 and GPIO46 are conn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
PMOS VGS clamp. D2 limits the PMOS gate-source voltage to about -12 V. R5 pulls the gate low to turn Q1 on during correct polarity, while D2 prevents VGS from exceeding the MOSFET gate rating. This zener only protects the PMOS gate. Input surges are handled by the TVS diode.
Surge protection. Transients will get pulled to GND
GPIO GPIO0 GPIO1 GPIO2 GPIO3 GPIO4 GPIO5 GPIO6 GPIO7 GPIO8 GPIO9 GPIO10 GPIO11 GPIO12 GPIO13 GPIO14 GPIO15 GPIO16 GPIO17 GPIO18 GPIO19 GPIO20 GPIO21 GPIO22–25 GPIO26 GPIO27 GPIO28 GPIO29 GPIO30 GPIO31 GPIO32 GPIO33 GPIO34 GPIO35 GPIO36 GPIO37 GPIO38 GPIO39 GPIO40 GPIO41 GPIO42 GPIO43 GPIO44 GPIO45 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
MCU
Power selection: bridge BOTH jumpers 1-2 for EXT, or 2-3 for NMEA. Never bridge 1-2 and 2-3 together. NMEA mode joins NET_C to MAIN_GND.
CONNECTOR FUNKTION ANTAL TERMINALER xx* PINOUT
Min anbefaling Kun BOOT-knap, undgå normal IO God til ADC/NTC eller IO God til ADC/NTC eller IO Undgå hvis muligt God til PWM/IO/ADC God til PWM/IO/ADC God til PWM/IO/ADC God til PWM/IO/ADC God til I2C SDA / IO God til I2C SCL / IO God til PWM/IO/ADC God til IO, men ADC2 kan være mindre praktisk me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
USBC
J1 J2 J3 J4 J5
ADC ADC1 ADC1_CH0 ADC1_CH1 ADC1_CH2 ADC1_CH3 ADC1_CH4 ADC1_CH5 ADC1_CH6 ADC1_CH7 ADC1_CH8 ADC1_CH9 ADC2_CH0 ADC2_CH1 ADC2_CH2 ADC2_CH3 ADC2_CH4 ADC2_CH5 ADC2_CH6 ADC2_CH7 ADC2_CH8 ADC2_CH9 — — — — — — — — — — — — — — — — — — — — — — — — —
VIN+, GND IN1+, IN1-, IN2+, IN2-, IN3+, IN3- GND, 3V3, 5V, GPIO1, GPIO2, GPIO3, GPIO4 VIN+, GND
Touch Touch Touch1 Touch2 Touch3 Touch4 Touch5 Touch6 Touch7 Touch8 Touch9 Touch10 Touch11 Touch12 Touch13 Touch14 — — — — — — — — — — — — — — — — — — — — — — — — — — — — — — —
Adressable Status Led
2 6 7 2
Særligt BOOT/strapping RTC GPIO RTC GPIO Strapping RTC GPIO RTC GPIO RTC GPIO RTC GPIO RTC GPIO RTC GPIO RTC GPIO RTC GPIO RTC GPIO RTC GPIO RTC GPIO RTC GPIO RTC GPIO RTC GPIO RTC GPIO USB D- USB D+ Normal GPIO Ikke på ESP32-S3 GPIO-listen Normal GPIO Normal GPIO Normal GPIO Normal GPIO Normal GPI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
Power input Opto inputs Raw GPIO / AUX Extra power tap

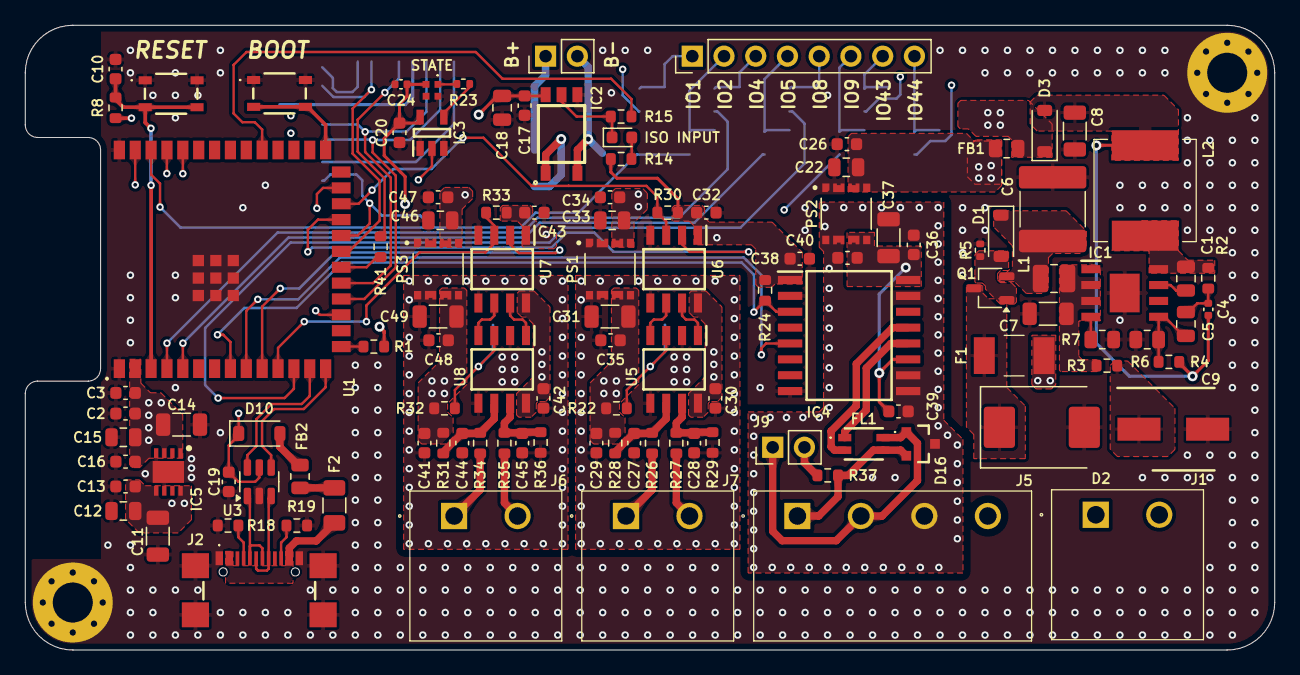
[picture p7: board ESP32-S3-WROOM-1-N8R8.kicad_pcb from above]

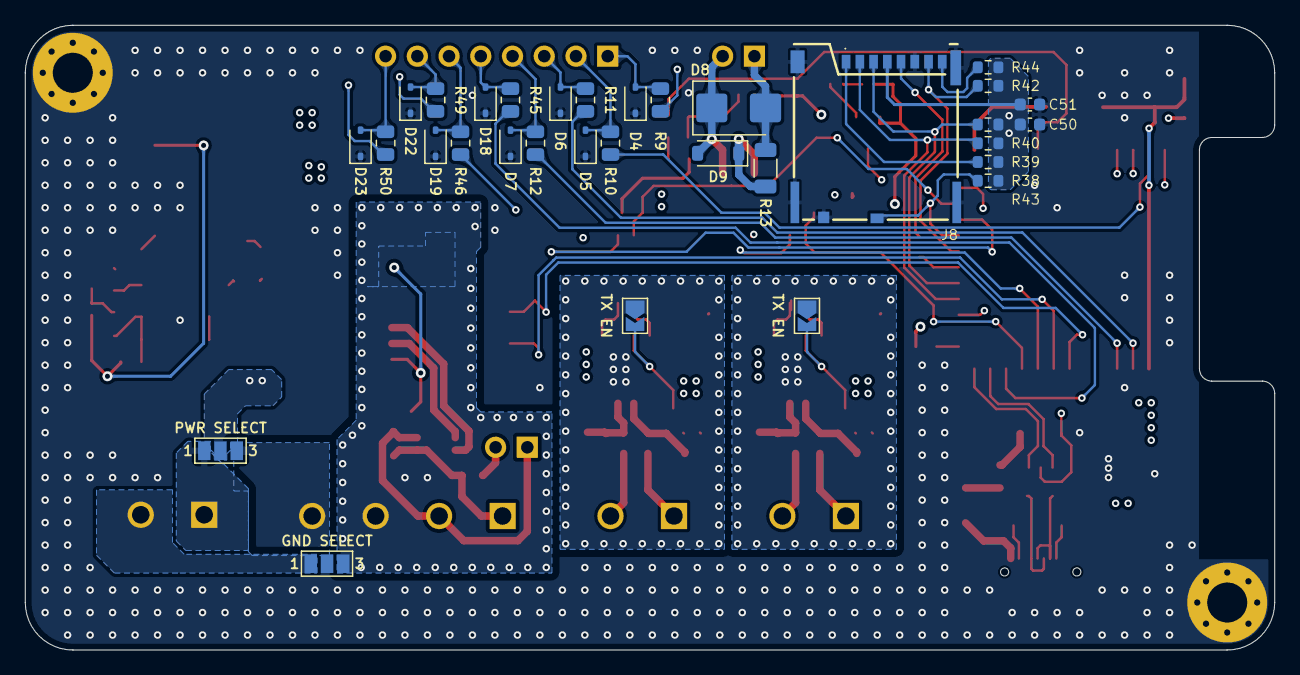
[picture p8: board ESP32-S3-WROOM-1-N8R8.kicad_pcb from below]

Board: 4 copper layers, 100.0 x 50.0 mm, 145 parts (32 on the bottom side), 95 nets.
