Kaelor9/EngineLink/(commit log)

2026-10-26 Update Lab prototype branding to EngineLink (experimental only)
2026-10-26 Accept full-size 8 MB merged ESP32-S3 flash images
2026-10-26 Fix Arduino preprocessing of Event type in Lab v1.2
    [EngineLink_Lab_v1_2.ino]
2026-10-26 Fix J1708 frame separation timeout to one UART symbol at 9600 baud
    [EngineLink.ino]
2026-10-26 Expose validity of observed fuel totals instead of presenting missing data as zero
    [EngineLink.ino]
2026-10-26 Add passive engine calibration capture CSV, fixed semantic LED alarms and stable SoftAP behavior
    [EngineLink.ino]
2026-10-26 Expose calibration and network diagnostics, improve Safari caching and correct LED alarm semantics
    [EngineLink.ino]
2026-10-26 Add passive RPM reference capture interface and fixed status LED legend; remove color picker
2026-10-26 Update EngineLink installer and documentation for 0.2.0 alpha calibration and Wi-Fi fixes
2026-10-26 Document passive motor test procedure, exported CSV fields, calibration and fixed LED alerts
2026-10-26 Represent unknown calibration references explicitly and clear transient UART LED alarm after 30 s
2026-10-26 Document EngineLink 0.2 passive motor tests, fixed LED patterns and Wi-Fi reliability work
2026-10-26 Add Claude handover with EngineLink requirements, current firmware and hardware safety gates
2026-10-26 EngineLink 0.2.1-alpha: robustness fixes from code review
    - PSRAM frame queue (2048) so blocking downloads/SD flushes do not drop J1708 frames
    - Capture J1708 frames up to 64 bytes (21-byte limit applies only while moving)
    - microSD hot-plug detection, unmount on removal, automatic remount
    - Failed motor test start no longer disables session logging
    - Detect SD row write failures; cache test file availability
    - Validate CAN start before mutating settings; NTP does not override GPS
    - UI: no-cache for onboard page, settings form after wizard, reset reason text,
    line errors/backlog diagnostics, LED panel shows real state during demo
    - Align version metadata; fix Lab-era RELEASING.md
    Co-Autho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
    [EngineLink.ino]
2026-10-27 Firmware 0.3.0-alpha core: Safari idle-socket fix, OTA, totals, engine runs, PID discovery
    Claude-Session: https://claude.ai/code/session_017Qr2fkUttzNrxnML98A1Sw
    [EngineLink.ino]
2026-10-27 EngineLink 0.3.0-alpha: new web app, Wi-Fi updates, installer and README redesign
    Firmware
    - Drop idle HTTP sockets after 600 ms (Safari speculative connections
    stalled the single-client WebServer for 5 s)
    - Wi-Fi firmware update with app-descriptor check; rejects merged image
    - Persistent trip/lifetime fuel and engine hours per physical channel
    - Automatic engine-run segments, SEGMENTS.CSV, never merged into trips
    - Bus discovery (/api/pids), one-hour trend (/api/history)
    - mDNS enginelink.local, selectable AP channel, restart/factory reset
    - Cache sketch size at boot (getSketchSize verifies the whole image)
    UI
    - Bottom tab bar on phones, health overview, prioritized alerts
    - Engine card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
2026-10-27 KAD: define kadParam after all types (Arduino prototype placement), robust echo timing, docs
    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
2026-10-27 KAD UI: refresh voltage check when discovery data arrives; release doc version
    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
2026-10-27 KAD: use the confirmed answer header for value width; document first wire capture
    The port KAD300 answered 97 % of 1,431 requests with no checksum errors.
    Answers are 83 C1 <n>1 <value> <cs>, big-endian; RPM, engine hours and
    coolant scalings confirmed. Voltage and fuel factor still to be settled.
    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
    [EngineLink.ino]
2026-10-28 EngineLink 0.5.0: new phone app, steady Wi-Fi, trips, fuel log and GitHub updates
    - New phone app (firmware/ui/app.html, packed gzip into ui.h by
    tools/build_ui.py): Trip, Economy, Tank, History, Engines and Settings,
    themes, units, currency, home-screen icon and manifest.
    - Wi-Fi: access point always on, power saving off, full TX power, the AP
    follows the router channel, targeted reconnects with backoff, scans only
    without phones, inactive timeout 10 min, AP watchdog.
    - Automatic trips with notes, combine/split and CSV export; fuel log with
    tank estimate and self-tuning fuel factor; RPM/speed statistics, zones
    and engine health. Stored in LittleFS; 0.4.x totals migrated.
    - Firmw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
2026-10-28 EngineLink 0.5.1: fit the iPhone home-screen app to the screen
    - With the black-translucent status bar, iOS measures height:100% too
    short in standalone mode and leaves a gap at the bottom. Use 100vh in
    standalone mode (display-mode media query, navigator.standalone for
    older iOS).
    - Input fields use 16px text so iOS no longer auto-zooms on focus.
    - Respect left/right safe areas in landscape; stop whole-page bounce;
    disable text inflation on rotation.
    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
    [EngineLink.ino]
2026-10-28 EngineLink 0.5.2: steady Wi-Fi connection
    - Replace the WebServer client loop: accept up to 8 sockets at once,
    serve whichever has a request, and keep HTTP/1.1 connections alive
    between requests. A silent or stalled socket no longer blocks every
    other request for up to 5 s, which showed as "Reconnecting".
    - Connecting to the boat router reuses the channel and BSSID from the
    scan the user picked from, and only moves the EngineLink network when
    the router is on another channel. softAPConfig only runs when needed.
    - CORS on all responses and the router address in /api/live, so the app
    finds EngineLink through the boat router when the phone joins it.
    - Detect a router that hands out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
    [EngineLink.ino]
2026-10-28 App: fix the iPhone home-screen layout, compact reconnect notice
    - Use the "default" status bar style. With black-translucent, current iOS
    lays the page out below the status bar but sizes it as if it were
    behind it, leaving an empty band under the menu. Drop the 100vh hack.
    - Fade content out under the top edge instead of a hard cut.
    - Reconnect notice is a one-line pill above the menu.
    - Confirm before swapping port and starboard.
    - Firmware page status while downloading; "On your average" at 0.0.
    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
2026-10-28 EngineLink 0.5.3: release the iPhone layout fixes
    The layout commit landed after PR #7 was merged, so it ships as its own
    version: bump EL_VERSION and move its notes from 0.5.2 to 0.5.3.
    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
    [EngineLink.ino]
2026-10-28 EngineLink 0.5.4: fill the iPhone screen to the bottom
    On the owner's iPhone the home-screen app is laid out below the status
    bar but sized as if it started at the top, so the nav ends one status
    bar height (47 pt) above the bottom of the screen. Detect that case (the
    page is two status bars shorter than the screen) and size #app to reach
    the bottom; paint anything below the page in the nav colour.
    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
    [EngineLink.ino]
2026-10-28 App: limit the bottom-gap fix to iOS
    On Android a home-screen app is also shorter than the screen by the
    status bar plus the navigation bar (often 72-80 dp), which fell inside
    the old range and would have pushed the menu under the Android buttons.
    Apply the fix only on iPhone/iPad in portrait, with a threshold of 1.5
    status bars for the device type (44 pt on home-bar iPhones, 20 pt on
    home-button iPhones and iPads).
    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
2026-10-28 EngineLink 0.5.5: stop the AP watchdog from dropping phones
    The owner's diagnostics showed 4 network restarts and 4 phone joins in
    11 minutes. AP_STOP also arrives late after a settings change (such as a
    channel move), which the watchdog treated as a failure, and every
    watchdog pass called esp_wifi_set_country, which itself restarts the AP.
    - Act only when the AP is really gone: mode without AP, or AP_STOP with
    no AP_START after it for 3 s (then esp_wifi_start), or a wrong IP.
    - Set the country only when it differs.
    - Diagnostics: phone drops with the last reason, channel changes, slowest
    loop pass; reset code 11 reads USB.
    Claude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
    [EngineLink.ino]
2026-10-28 Configurable address name (<name>.local)
    - cfg.hostName (NVS "host", default "enginelink"), validated as a DNS
    label. Used for mDNS on the AP and the router and as the DHCP hostname.
    Changing it restarts mDNS only.
    - /api/cfg host=..., reported in state config, /api/live net.host and the
    settings backup; the restore takes it back.
    - App: Settings > EngineLink Wi-Fi > Address in the browser; the router
    page and the host fallback use the saved name.
    - No DNS server on the AP: answering "not found" for every other name
    could cut a phone off mobile-data internet while it is on EngineLink.
    Claude-Session: https://claude.ai/code/se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
2026-10-28 EngineLink 0.6.0: measurements
    - Fuel calibration from fill-ups (fuelcal.h): weighted ridge regression
    over every pair of full tanks with a common factor and a correction per
    engine-speed band (idle < 1100, part load, cruise >= 2500 rpm). Fill-up
    quality (clicked off / topped up) sets the weights, partial fill-ups in
    between are summed, odd fill-ups (|z| > 3 leave-one-out) are set aside
    and the app asks. Solved again from the whole log after every change.
    - Fuel raw counts per band in totals, trips and fuel snapshots, so better
    calibration recalculates every trip and the tank. Totals, trips.bin and
    fuel.bin from 0.5 are converted; new files carry a header.
    - Tank level variance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
    [EngineLink.ino, fuelcal.h]
2026-10-29 README: app screenshots and a live demo button
    Screens from the browser demo (Trip, Tank, Engines, Diagnostics) at the
    top of the README, linked to the live demo on the Pages site.
    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
2026-10-29 EngineLink 0.7.0: diagnostics, a readable status light, faster reading
    - Diagnosis rules (diagrules.h): fixed limits plus CUSUM drift against each
    engine's own normal per rpm band, port/starboard imbalance, rpm short of the
    lever, hunting, stops, lost answers, cold load, thermostat, long idle and
    status bit changes. Host-tested on simulated twin-engine trips.
    - Events with a black box (two minutes before and after on SD), the
    "Something's odd" mark, 1 Hz trip timeline with CSV export, last 10 minutes,
    port vs starboard, life story per engine, range with ±.
    - Status light language (ledpatterns.h): distinct colours and rhythms, no two
    similar colours next to each other; legend in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
    [EngineLink.ino, diagrules.h, ledpatterns.h]
2026-10-29 Export sheet and printable trip and engine reports
    - One Export sheet: a report at the top, spreadsheet files with sizes below.
    Replaces the separate download buttons and the raw-data second step.
    - Reports are the app in report mode (?report=trips&ids=… / ?report=engines):
    a light document with key figures, curves, events, port vs starboard and
    life story, with "Save as PDF or print". Opens in its own window.
    - Charts get a smallest scale per value so idle noise stays small; no "-0".
    - Demo scene for the export.
    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
2026-10-29 EngineLink 0.7.3: no silent stop when the protocol is wrong
    With SAE J1587 selected the board never asks the KAD/EDC I units, so no
    data arrives even with automatic reading on, and one tap in Advanced
    switched it. Ask before switching to J1587, show "Not reading the engines"
    with a one-tap fix on every screen while J1587 is set and no engine is
    seen, and restart automatic reading right after a protocol change.
    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
    [EngineLink.ino]
2026-10-29 EngineLink 0.7.6: compressed downloads, engines read during downloads, steadier Wi-Fi
    - Downloads go through one module: 8 kB pieces, deflate-compressed with the
    ROM compressor when the browser accepts it (zlib wrapper, greedy, 24
    probes, compressor state in PSRAM), and timed for Diagnostics.
    - Between pieces the engine work runs (frames, KAD requests, engines/trip/
    diagnosis, SD flush, LED), so a download no longer pauses reading.
    - 20 MHz channels on the AP and STA interfaces.
    - Without a router, pick the quietest of channels 1/6/11 at start-up.
    - App spaces live polls by the measured answer time (0.5-2 s).
    Claude-Session: http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
    [EngineLink.ino]
2026-10-29 EngineLink 0.7.7: no false "another device", no replies filed under the wrong value
    After a busy moment serviceKad timed out a request whose reply was already
    queued and sent the next one; the late echo then failed the own-request
    check and stopped polling as "another device", and a late reply could be
    paired with the new request (why discovery listed every index).
    - Drain the frame queue before judging a timeout.
    - Recognise our echo against the last four requests by frame time.
    - Accept a reply to our request only after its echo (when the channel echoes).
    - Step back only for 3 foreign requests within 10 s.
    Claude-Session: https://c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
    [EngineLink.ino]
2026-10-29 EngineLink 0.7.8: engine reading in its own task, data-read figures
    - engineTask (core 0, priority 3) drains the frame queue, runs KAD polling,
    auto polling and the 1 Hz engine/trip/diagnosis work. Shared state is
    guarded by one mutex the loop holds while working and releases around
    network waits (request parsing, every socket write, router scans, the
    loop's pause). The loop keeps everything as before if the task fails.
    - Coverage per engine: seconds with a fresh answer (<2 s) while running,
    gaps counted only with the engine running on both sides; per trip in a
    /TRIPS/T*.COV sidecar, since start in /api/diag. Shown in the trip
    report, the timeline and Diagnostics.
    Co-Authored-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
    [EngineLink.ino]
2026-10-29 EngineLink 0.7.9: watchdog and wait measurement for the engine task
    - The loop restarts the board (after saving totals) when the engine task
    has not finished a round for 10 s while not waiting for the lock.
    - The engine task records its longest wait for the lock and waits over
    100 ms; Diagnostics shows them under Reading speed.
    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
2026-10-29 EngineLink 0.8.0: survive power cuts, SD errors and hangs
    - Save totals every 30 s while an engine runs (power often goes with the
    ignition before a stop is seen); flush the trip log every 10 s.
    - Remount the SD card after a write error (1 min, then 5 min) and resume
    the raw log and the running trip's log.
    - Task watchdog for the loop (60 s, fed in downloads, wipes and uploads).
    - Restart log in NVS (reason, uptime before, version, dated once the clock
    is set), shown under Diagnostics → Restarts with advice for brownouts.
    - App catches its own errors for Diagnostics and the technical file.
    Claude-Session: https://claude.ai/code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
    [EngineLink.ino]
2026-10-29 EngineLink 0.8.1: boat router connection recovers by itself
    - Reconnect after 8 s, 16 s, then every 30 s (was 15 s doubling to 5 min).
    - Search for the router again after every third failed try (at most every
    5 min with phones joined; before, never while a phone was joined), so a
    router that changed channel is found again.
    - UDP keep-alive to the gateway every 25 s.
    - Record the last STA disconnect reason and downtime; Diagnostics shows it.
    - Router LED pattern only after 15 s down.
    - Range card explains that nautical miles need GPS speed.
    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
    [EngineLink.ino]
2026-10-30 EngineLink 0.8.2: find and keep the boat router
    - No router connect attempts during a network search (they cut the scan
    short); scans listen 300 ms per channel and include hidden networks.
    - Each connect attempt gets at least 20 s before starting over.
    - STA beacon-loss tolerance 20 s (was the 6 s default).
    - Transmit power setting (max/medium/low) in Diagnostics → Wi-Fi.
    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
    [EngineLink.ino]
2026-10-30 Update the handover to 0.8.2
    Rewritten for any developer or assistant: current architecture (tasks,
    lock, KAD reading, fuel, trips, diagnosis, export), build and release, the
    open Wi-Fi problem with what has been tried and what is still suspected,
    and what is verified versus untested on the board.
    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
2026-10-30 Fix unrestricted router reconnect and isolate live telemetry on port 81 (0.8.3)
    [EngineLink.ino]
2026-10-30 Recover interrupted LittleFS writes, preserve formatted storage, report OTA link loss
2026-10-30 Avoid redundant AP reconfiguration; protect existing 0.8.2 LittleFS data
    [EngineLink.ino]
2026-10-30 Only skip AP reconfiguration when AP_START was confirmed
    [EngineLink.ino]
2026-10-30 0.9.0: fix STA scan overlap and fragmented TCP OTA header validation
    [EngineLink.ino]
2026-10-30 Record internal filesystem write and recovery failures in diagnostics
    [EngineLink.ino]
2026-10-30 Improve OTA flash failure feedback and remove stale firmware header
    [EngineLink.ino]
2026-10-30 0.9.1: keep offline AP channel fixed and prevent eager AP watchdog restarts
    [EngineLink.ino]
2026-10-30 0.9.2: fail-open AP rescue after router timeout, persisted until explicit retry
    [EngineLink.ino]
2026-10-30 Document backed-up USB recovery preserving calibration and LittleFS
2026-10-30 EngineLink v0.9.3: stabilize Wi-Fi scanning, UI HTTP and USB reinstall
    Full ESP32-S3 release build. Keeps Marine Precision UI and engine safety rules; improves Wi-Fi scan snapshot, 2.4 GHz discovery, bounded speed test and installer data-erasure guidance.
    [EngineLink.ino]
2026-10-30 EngineLink v0.9.4: stabilize Wi-Fi and web installer publishing
    * fix: keep ESP32 STA available for AP network scans and cap HTTP stalls
    * docs: add v0.9.4 safe USB web installer and Wi-Fi test notes
    * docs: reflect v0.9.4 web installer build
    * ci: parse GitHub releases JSON reliably for web installer publishing
    [EngineLink.ino]
2026-10-30 EngineLink v0.9.5: recover mDNS after Wi-Fi changes
    * fix: recover mDNS advertisements after AP and router network changes
    * diag: expose mDNS responder initialization and retry diagnostics
    * ui: show mDNS status and local hostname in existing diagnostics
    * docs: detail v0.9.5 mDNS behavior and full USB install test
    * docs: show EngineLink v0.9.5 and mDNS recovery release
    * fix: refresh mDNS service after network configuration changes
    [EngineLink.ino]
2026-10-30 EngineLink v0.9.6: exclusive Wi-Fi modes and rescue fallback
    * fix: exclusive AP or STA networking with router-failure recovery
    * fix: temporary scan STA only, restore standalone AP after scanning
    * ui: accurately explain mutually exclusive Wi-Fi modes and switch steps
    * docs: explain exclusive Wi-Fi operation in v0.9.6
    * docs: v0.9.6 exclusive network modes and recovery test
    [EngineLink.ino]
2026-10-30 EngineLink v0.9.7: fix router reconnects and instrument slow HTTP
    * fix: remove stale router BSSID pinning and blocking reconnect scans
    * diag: distinguish slow HTTP request parsing from slow handlers
    * fix: send router-switch acknowledgement before disabling current Wi-Fi
    * ui: show HTTP parse, handler and slow endpoint metrics for diagnosis
    * docs: v0.9.7 router connection and diagnostics validation
    * docs: bump EngineLink v0.9.7
    [EngineLink.ino]
2026-10-30 EngineLink v0.9.9: staged Wi-Fi discovery with improved AP stability
    * wifi: prepare phased 13-channel scan and preserve results across channels
    * wifi: scan 2.4 GHz channels asynchronously with AP airtime gaps and safe completion
    * wifi: defer radio scan until after HTTP ack and expose channel progress/errors
    * ui: show per-channel scan progress, avoid stale results, and extend discovery polling
    * wifi: protect repeated scan sessions, cancel stuck scans, and expose scan diagnostics
    * wifi: avoid reconfiguring an already enabled discovery interface
    * cleanup: remove unused blocking Wi-Fi scan functions and obsolete diagnostics
    * test: prevent blocking scans, short channel dwell and lo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
    [EngineLink.ino]
2026-10-30 EngineLink v0.10.0: refactor Wi-Fi association and HTTP responsiveness
    * ui: fast parallel reconnect across AP/router and stop blocking live sidecar probes
    * perf: isolate speed-test transfers from main HTTP loop on independent port 82
    * ui: run throughput test on isolated HTTP worker, validate complete transfer
    * wifi: event-driven router retry and send disconnect ACK before stopping STA
    * wifi: separate stalled-association cancel and retry to avoid self-inflicted disconnects
    * wifi: recover promptly after a later router drop, resetting stale retry timers
    * boot: start AP/router Wi-Fi immediately after settings, before slow filesystem/SD initialization
    * test: guard exclusive Wi-Fi m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
    [EngineLink.ino]
2026-10-30 EngineLink v0.10.1: improve router discovery with two scan passes and manual SSID
    * wifi: retry all 13 channels with active then passive beacon scan and full dwell
    * ui: show two-pass scan progress and allow direct 2.4GHz router SSID/password entry
    * diag: report first-pass vs combined Wi-Fi discovery results
    * ui: show two-pass improvement and prevent focus loss during scanning
    * test: require two-pass active/passive scanning, full dwell and manual SSID fallback
    * docs: v0.10.1 two-pass router discovery and manual SSID setup
    * docs: identify EngineLink v0.10.1 router discovery improvements
    * ui: prevent router connection attempts while Wi-Fi discovery owns the radio
    [EngineLink.ino]
2026-10-30 EngineLink v0.11.0: native router Wi-Fi auto-reconnect and reliable AP rescue
    * wifi: replace homegrown disconnect/retry loop with native ESP32 STA autoconnect and AP rescue
    * test: enforce native ESP32 auto-reconnect, exclusive radio modes and 120s rescue
    * wifi: give native STA reconnect a full grace period after any later router dropout
    * ui: show native Wi-Fi association and fallback instead of obsolete retry counters
    * docs: native STA router design, two operating modes and physical acceptance tests
    * docs: set EngineLink firmware version 0.11.0
    * test: inspect network statements rather than matching WiFi.begin in comments
    * wifi: do not clear rescue SoftAP immediately before cre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
    [EngineLink.ino]
2026-10-31 EngineLink v0.11.1: non-disruptive router retries and network listener recovery
    * wifi: instrument WPA/DHCP events and stop forced disconnects during router retry
    * http: rebind listeners when AP/router IP changes, expose association vs DHCP metrics
    * wifi: preserve genuine association/DHCP failure reasons across fallback and reboot
    * diagnostics: add independent network-health JSON endpoint for DHCP/RF/HTTP diagnosis
    * ui: expose DHCP/association timing, HTTP rebinds and detailed network report
    * docs: identify v0.11.1 router lifecycle and diagnostic changes
    * docs: explain the router lifecycle fix and the association/DHCP/HTTP test protocol
    * test: guard non-disruptive STA retries,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
    [EngineLink.ino]
2026-10-31 EngineLink v0.11.2: compact Wi-Fi diagnostics and support report
    * wifi: retain router events and last successful link observations across rescue
    * diag: add copyable human network report with Wi-Fi event trace and JSON
    * ui: compact Wi-Fi diagnostics to four essentials with a readable report link
    * fix: keep Wi-Fi summary and transmit power inside the same HTML template
    * test: verify compact Wi-Fi dashboard and credential-free support report
    * diag: retain enough Wi-Fi events to cover full router retry window
    * test: expect 64-entry Wi-Fi history
    * release: set diagnostic firmware version to v0.11.2
    * docs: update current firmware version to 0.11.2
    * docs: describe Wi-Fi report an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
    [EngineLink.ino]
2026-10-31 EngineLink v0.11.3: configure WPA3-SAE before association and improve TCP speedtest
    * wifi: explicitly configure WPA3 SAE PWE+PMF before connect; measure actual auth mode and fix speed test pacing
    * diag: expose WPA2/WPA3 negotiated security in compact on-device dashboard
    * ui: show negotiated WPA2/WPA3, correct auth timeout and hide stale failure while online
    * test: verify explicit pre-connect SAE configuration and speed-test TCP chunking
    * docs: bump EngineLink version to 0.11.3
    * docs: describe WPA3 SAE setup and speed test plus unverified hardware checks
    [EngineLink.ino]
2026-10-31 EngineLink 0.11.5: talk to the router IP instead of enginelink.local
    Every field report of slow or blank router-mode pages used
    http://enginelink.local, where each request needs an mDNS look-up that is
    slow or fails on Windows and through many routers. The app now switches
    all requests (including ports 81/82, downloads and reports) to the IP the
    board reports, once that IP answers; it falls back to the name if the IP
    stops answering. Boat router page suggests bookmarking the IP.
    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
    [EngineLink.ino]
2026-10-31 EngineLink 0.11.6: return to router mode by itself after a fallback
    In standalone after a router fallback, look for the saved router with an
    asynchronous single-SSID scan (AP stays on): after 2 min, then every
    10 min, doubling after each failed return up to 2 h, never while the app
    is in use on the AP (request in the last 2 min). When seen, clear the
    hold and switch to STA-only; the 120 s guard still applies. User scans are
    refused while a probe runs. Diagnostics shows the next look.
    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
    [EngineLink.ino]
2026-10-31 EngineLink 0.11.7: WPA2 first on mixed routers, WPA3 only when required
    Field report (0.11.6, Zyxel WPA2/WPA3 mixed): WPA3-SAE held ~68 min, then
    209 (SA Query timeout), after which every SAE login failed (2/4/202) for
    over an hour across fallbacks and automatic returns.
    - Join with PMF off (WPA2 on mixed routers); WPA3-SAE (PMF capable) only
    when the router needs it: switch on 210/211 or when WPA2 never got an IP;
    switch to WPA2 at once on 209; persist the mode in NVS (smode).
    - Automatic return probes even with the app open after 30 min in rescue.
    - Report/JSON show the security mode and switch count.
    Claude-Session: https://cla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
    [EngineLink.ino]
2026-10-31 EngineLink 0.11.8: web server self-check and smaller socket pool
    Router mode, steady green, Safari at the direct IP: "connection was lost",
    then "server stopped responding" (TCP accepted, no HTTP answer).
    - HTTP keep-alive pool 8 -> 4, idle close 5 s -> 3 s (lwIP has 16 sockets).
    - Loopback self-check every 20 s (127.0.0.1/api/health): 3 misses ->
    close connections and rebind; still failing 2 min later -> save totals
    and restart. Skipped while a handler is busy.
    - Report/JSON count misses, heals and restarts.
    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
    [EngineLink.ino]
2026-10-31 EngineLink 0.11.9: device reports to GitHub and on port 81
    - Optional GitHub token (Issues write only, stored in NVS, never echoed).
    The board files its network report as an issue after a router loss
    (once back online), after a web-server self-heal, and on request;
    router name redacted; rate-limited (30 min, 10/day).
    - Report served by the port-81 side server at /report, readable while
    port 80 is stuck.
    - Docs: 0.11.7's WPA2-first has no effect (pmf capable is ignored).
    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
    [EngineLink.ino]
2026-10-31 EngineLink 0.11.10: up to 5 min for routers that are slow to let it in
    Device report #53: WPA3-SAE join to the Zyxel took 110 s and 14 attempts
    (2/4/202), just under the 120 s rescue limit. While the last failure is a
    login-type reason (2, 4, 15, 202, 204) the rescue waits up to 300 s; a
    router that is not found still falls back after 120 s.
    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
    [EngineLink.ino]
2026-10-31 EngineLink 0.11.11: WPA3-SAE Hunting-and-Pecking by default
    0.11.10 report: a whole boot with no association to the Zyxel, 56 SAE
    attempts timing out (2/4/202). All versions used H2E when offered. Default
    to WPA3_SAE_PWE_HUNT_AND_PECK, flip to BOTH after a router session that
    never got an IP, persist the working method. Drop 0.11.7's PMF toggle and
    its 209/210/211 switches (PMF capable is ignored by this IDF).
    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
    [EngineLink.ino]
2026-11-01 EngineLink 0.12.0: WPA2 by default like most ESP32 devices, WPA3 when needed
    The prebuilt Arduino ESP32 libraries always offer WPA3-SAE and ignore
    pmf_cfg.capable; the owner's Zyxel failed SAE logins for whole boots.
    - wifiwpa3.cpp wraps esp_wifi_init (-Wl,--wrap=esp_wifi_init) and clears
    CONFIG_FEATURE_WPA3_SAE_BIT from feature_caps unless WPA3 is allowed.
    Verified in the ELF: wifiLowLevelInit -> __wrap_esp_wifi_init ->
    esp_wifi_init. Weak __real_ keeps builds without the flag linking.
    - WPA2 default; WPA3 for WPA3-only routers (scan auth WPA3_PSK, or reason
    210/211), applied by a full driver restart; flip after a session that
    never got an IP; persisted (NVS smode).
    - Both CI bui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
    [EngineLink.ino]
2026-11-01 EngineLink 0.12.2: medium transmit power by default, lowered automatically
    0.12.1 report: WPA2 works but uplink frames are lost (router beacons at
    -45 dBm, logins unanswered with 2/15 at ~1 Hz, DHCP 29.5 s, drops).
    Default TX power 15 dBm (new NVS key txp2); after 12 unanswered logins in
    a row step down to 11 then 8.5 dBm and keep it. Four levels in the app.
    Clear "no internet" text for failed report uploads.
    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
    [EngineLink.ino]
2026-11-01 EngineLink 0.12.3: never push a WPA2 router to WPA3 on a plain fallback
    Report #62 confirmed WPA2 at 15 dBm works with the Zyxel. A router outage
    (report #59) still flipped the next attempt to WPA3, which this router
    fails. Switch to WPA3 only on evidence (WPA3-only scan entry, reason
    210/211). Drop an outdated report line.
    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
    [EngineLink.ino]
2026-11-01 EngineLink 0.12.4: transmit-power test by ping, new signal bars
    - linktune.cpp: pings the gateway (20 x 1400 bytes) at 19.5/15/11/8.5 dBm
    and keeps the step with the fewest losses and shortest RTT; runs in its
    own task once per start (60 s online) and on request (/api/linktune);
    results in /api/diag, the network report and Diagnostics → Wi-Fi.
    - Router list signal bars drawn as an SVG (four bars, one baseline).
    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
    [EngineLink.ino]
2026-11-01 0.12.5: send frames one by one to the router (A-MPDU off), report power save and PHY mode, list 5 newest versions (#71)
    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
2026-11-01 0.12.6: read Wi-Fi driver state once a second in router mode, A-MPDU on again (#75)
    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
2026-11-01 0.12.7: Auto transmit power from phone download tests, 5 fixed levels, detailed network report (#77)
    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
    [EngineLink.ino]
2026-11-01 0.12.8: A-MPDU RX off in router mode with on-board A/B test (#78)
    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
2026-11-01 0.12.10: fix send window boost for dual-stack sockets, self-tuning speed test, no bundling settings, crash summary (#82)
    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
    [EngineLink.ino, crashinfo.cpp]
2026-11-01 0.12.11: always-auto TX power, simpler Advanced, busy-channel hint, close sockets before Wi-Fi restart (#84)
    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
2026-11-01 0.12.12: fully automatic transmit power (periodic on-board test with hysteresis), single speed test (#85)
    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
2026-11-01 0.12.14: channel hint only after a slow speed test on the current channel; reset reason 11 label (#90)
    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
    [EngineLink.ino]
2026-11-02 Update README and developer guide to the current state (#98)
    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
2026-11-02 Fix iPhone navigation and router password editing (v0.13.2)
    * Fix iPhone home-screen bottom navigation and router input focus
    * Keep Wi-Fi password field inside narrow phone screens
    * Bump EngineLink to 0.13.2 for mobile UI fixes
    * Bump EngineLink to 0.13.2 for mobile UI fixes
    * Document EngineLink 0.13.2 release and on-board validation limits
    * Add regression checks for iOS tab bar and router inputs
    * Run mobile UI regression checks in CI
    [EngineLink.ino]
2026-11-02 Improve EngineLink router responsiveness and raw export resilience (v0.13.3)
    * Cache Wi-Fi status, interface mode and IP instead of polling per loop
    * Run Wi-Fi power tuning only after 20 seconds without HTTP activity
    * Regression-test cached Wi-Fi status and idle-only radio calibration
    * Run router throughput source contracts in CI
    * Avoid observed compressed raw CSV export crash under weak Wi-Fi
    * Guard against re-enabling crashing compressed raw export
    * Prepare EngineLink v0.13.3 router stability release
    * Prepare EngineLink v0.13.3 router stability release
    * Document v0.13.3 router and raw export stability fixes
    * Count live and speed listener activity when deciding if radio te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
    [EngineLink.ino, netreport.ino, sdexport.ino, wifi.ino]
2026-11-02 Clarify router channel limitations and correct survey report text
    [netreport.ino]
2026-11-02 Recover transmit power after beacon loss without router changes (#118)
    * Try bounded transmit-power recovery after router beacon loss and report attempts
    * Try bounded transmit-power recovery after router beacon loss and report attempts
    * Expose beacon recovery counter to network report through accessor
    * Use accessor to avoid Arduino .ino translation-unit declaration order
    * Prepare EngineLink 0.13.4 Wi-Fi diagnostics and recovery release
    * Prepare EngineLink 0.13.4 Wi-Fi diagnostics and recovery release
    * Document EngineLink 0.13.4 Wi-Fi report and beacon recovery changes
    [EngineLink.ino, netreport.ino, wifi.ino]
2026-11-02 Update board test status with measured Wi-Fi improvements and remaining issues
2026-11-02 0.14.0: gear and clutch analysis, guided drive test, four readings a second (#127)
    * Gear and clutch analysis, four readings a second, faster gear bits while manoeuvring (work in progress)
    * 0.14.0: guided drive test, gear and clutch on the Engines tab, side by side, my boat, mechanic report
    ---------
    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
2026-11-02 0.14.1: nicer drive test, safety steps one at a time, two small fixes (#129)
    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
    [EngineLink.ino]
2026-11-03 Developer guide: show visual options first, drive test scene wishes and the owner's current choice
    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
2026-11-03 Track Drive Test animation fix and remaining on-device verification
2026-11-04 chore: reduce Claude token overhead and make Graphify code-only by default (#138)
    * docs: favor low-token Graphify workflow and bounded delegation
    * config: parse Arduino .ino files as C++ in Graphify
    * config: exclude generated embedded UI bytes from Graphify
    * tools: add on-demand zero-LLM Graphify refresh
    * chore: exclude generated Graphify index from commits
2026-11-04 docs: preserve interactive drive-test scene prototype for further design (#139)
    * docs: preserve exported interactive drive-test scene prototype
    * docs: explain source and provisional status of scene preview
    * docs: track exported scene preview as design starting point
2026-11-04 Wi-Fi 0.15.0: own reconnect back-off, non-latching rescue, fixed TX power
    Based on field reports #95, #126, #130 and engine reports #104/#107:
    - Router reconnects: Arduino auto-reconnect off (it retried every 1.6 s
    with disconnect+connect, logging 201+36 pairs). One esp_wifi_connect()
    after each DISCONNECTED event with 1/2/4/8/15 s back-off, never while an
    attempt runs; covers code 209. Removes the 30 s nudge and SA Query path.
    - Rescue is not persisted (rhold): every start tries the router first.
    In rescue, probe every minute (last channel from NVS, all channels every
    fifth time) and return when the app is idle 60 s, or after 10 min unless
    the last return failed; failed returns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
    [EngineLink.ino, diagnosis.ino, model.h, netreport.ino, storage.ino, webapi.ino]
2026-11-04 EngineLink 0.15.0: simpler, steadier Wi-Fi (#140)
    the last return failed; failed returns back off to 15 min.
    - L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
    [EngineLink.ino, diagnosis.ino, model.h, netreport.ino, storage.ino, webapi.ino]
2026-11-04 0.15.1: stop multi-second main-loop stalls (USB serial, SD clean-up)
    Field reports #141-#143 (0.15.0): the router link was fast and stable,
    but the main loop stood still up to 9.4 s, and so did engine reading.
    - Serial.setTxTimeoutMs(0): HWCDC waited up to 20 x 100 ms per write
    with a non-reading USB host (serial part 2.2 s, network part 6 s).
    - Raw log clean-up scans 4 directory entries / removes one file per
    loop pass instead of one 7.4 s pass.
    - Deauthenticate AP stations before a mode switch so phones move to the
    router at once.
    Claude-Session: https://claude.ai/code/session_01PB8f4axSRY5MdvhB3x3DZi
    [EngineLink.ino, sdexport.ino, wifi.ino]
2026-11-04 EngineLink 0.15.1: no more multi-second pauses (#144)
    * Wi-Fi 0.15.0: own reconnect back-off, non-latching rescue, fixed TX power
    fifth time) and return when the app is idle 60 s, or aft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
    [EngineLink.ino, sdexport.ino, wifi.ino]
2026-11-04 Drive test: owner's chosen dock and open-water scenes in the app
    The owner chose the look on tools/boat-studio/drive-test-scenes.html
    (now the full options page): his boat in the app's dark blue rocking
    gently, lines drawn fast from the cleats to the quay, a figure-of-eight
    fading in on each cleat, then the fenders popping out one by one, and
    small ripples fading in and gliding out.
    - export_scenes.js writes the scene markup and timings into app.html
    (/*DTS*/), the boat once and without the waves.
    - dtFrame() in the app recomputes every line from the moved cleat each
    frame, so lines stay on the cleats and tighten/slacken with the boat.
    - Dock scene alternates stern-to and alongside; red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
2026-11-04 Drive test: owner's chosen dock and open-water scenes (#147)
    fifth time) and return when the app is idle 60 s,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
2026-11-04 Drive test: steps as plain text lever cards, idle and rpm guards
    - Each step shows PORT LEVER / STARBOARD LEVER with the position in words
    and marks the lever that moves; the lever picture (sceneLever) is gone.
    - Red warning when an engine is over 1,000 rpm at the dock or the other
    engine is above idle in a one-engine step; Start only below 800 rpm.
    - The full drive test flow options page is kept in
    tools/boat-studio/drive-test-flow.html (not used).
    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
2026-11-04 Drive test: steps as text lever cards with idle and rpm guards (#148)
    fifth time) and return when the app is i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
2026-11-04 Drive test: owner's chosen flow, pictures and safety guards
    Chosen on tools/boat-studio/drive-test-flow.html (2026-11-04), pictures
    exported into app.html by tools/boat-studio/export_flow.js:
    - safety screens with the chosen pictures, cards swiped away (button too),
    checks remembered for 15 minutes;
    - step screen: big instruction, Volvo Penta twin-lever picture (front and
    side) for the lever that moves, gear and rpm, bar with seconds, Pause and
    Stop;
    - guards: >1,000 rpm at the dock, other engine above idle, start only at
    idle, a guard stops the step, boat moving >2 kn at the dock, lost
    connection, engine data missing 3 s, "Put both levers in NEUTRAL" after
    Stop, lookout reminder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
2026-11-04 Drive test: owner's chosen flow, pictures and safety guards (#149)
    fifth time) and return when the app is idle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
2026-11-04 NMEA 2000: decode the boat's instruments, log them per trip, bus census
    Listen only (TWAI listen-only mode), nothing is ever sent.
    - nmea2k.h (host-tested, tools/test_nmea2k.cpp, in CI): position, COG/SOG,
    GNSS fix/sats/HDOP, heading, speed through water, depth, distance log,
    sea/air temperature, rudder, battery, wind, tank levels, other gauges'
    engine rpm, time; fast-packet reassembly; census of every source/PGN with
    rate and maker from the address claim.
    - Per trip /TRIPS/Tnnnnnn.NAV beside the engine log (old trips untouched),
    joined by uptime as extra columns in the second-by-second CSV.
    - /api/nmea and live "n2k"; app: Navigation card on the Trip screen and a
    "Devices and da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
    [EngineLink.ino, diagnosis.ino, model.h, nmea2000.ino, nmea2k.h, webapi.ino]
2026-11-04 NMEA 2000: decode the boat's instruments, log them per trip, bus census (#150)
    fifth time) and return when the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
    [EngineLink.ino, diagnosis.ino, model.h, nmea2000.ino, nmea2k.h, webapi.ino]
2026-11-04 NMEA 2000: names for AIS700 and Evolution autopilot messages in the bus list (#151)
    fifth time) and return whe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
    [nmea2k.h]
2026-11-04 EngineLink 0.16.5: fix AP TX setting and distinguish DHCP/TCP/HTTP failures (#157)
    * Fix standalone AP TX power and expose DHCP/TCP connectivity diagnostics
    * Fix standalone AP TX power and expose DHCP/TCP connectivity diagnostics
    * Fix standalone AP TX power and expose DHCP/TCP connectivity diagnostics
    * Report AP DHCP leases and port 80 TCP connections separately from parsed HTTP requests
    * Document 0.16.5 firmware version
    * Record focused iPhone AP connectivity test for 0.16.5
    * Add 0.16.5 release notes and iPhone acceptance test
    * Distinguish iPhone TCP connections from localhost web-server self-checks
    * Expose client TCP count excluding internal health checks
    * Clarify AP accep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
    [EngineLink.ino, netreport.ino, wifi.ino]
2026-11-05 Docs: Wi-Fi 2.0 plan, 0.16.5 standalone USB findings
    Records the agreed Wi-Fi 2.0 architecture (four states, never two
    networks, enginelink.local, WPA2 unless WPA3-only, fixed AP channel,
    what to remove/keep, required regression tests, open decisions) and
    the 0.16.5 USB report (join, DHCP and HTTP work; 10 s web stall open).
    No firmware change.
    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
2026-11-05 Docs: Wi-Fi 2.0 implementation plan (docs/WIFI_REWRITE_PLAN.md)
    Audit of the 0.16.5 network code against the Arduino core 3.3.12 and the
    device reports, the target state machine (standalone, router test, router,
    router lost), API/report/NVS contracts, eight implementation stages with
    host, contract and boat tests, and the open decisions for the owner.
    Findings recorded: the 10 s web stall is NetworkClient::write()'s 10 x 1 s
    select retry; auto-reconnect 201/36 pairs defeat the trace coalescing; the
    TX power check accepts the unset 20 dBm default; wrong router credentials
    are saved before they are tried; the 10-minute return is a blind 2-minute
    switch. No firmware change.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
2026-11-05 Docs: Wi-Fi plan, consistent disconnect call in stage 4
    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
2026-11-05 Docs: Wi-Fi plan with the owner's decisions and a final review
    Records D19-D22 (AP+idle STA approved, app prompt approved, no idle timer:
    a joined phone is never cut off automatically, captive-portal answer
    deferred) and makes the state machine, host-test scenarios, API, boat
    protocol and risks consistent with them.
    Final review added nine fixes: no automatic return after a rapid-boot
    standalone, AP put back on its fixed channel after a failed test, two
    auth failures before "wrong code", a raw event FIFO for the state machine
    beside the coalesced trace, directed scans so hidden routers are found,
    auto-reconnect off before the AP comes up, WPA3 remembered in RAM for
    return tests, T6 and a st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
2026-11-05 Docs: 2026-11-05 boat test analysis, root-cause gate and test procedure
    Analysis of the owner's 0.16.5 Wi-Fi log (16 reports, SD log, live
    report): the own Wi-Fi joins and leases every time, but the link from
    EngineLink to the phone fails (no TCP connection reaches port 80 in four
    boots, DHCP asked twice, phone leaves with code 2 x8-10 then 209 SA Query
    timeout, 60-72 kB/s). The 5-10 s web stalls are the core's write retry
    against a phone that does not acknowledge: a consequence, not the cause.
    Documented facts, hypotheses (RF environment, power path, AP settings
    dropped in 0.16.2 - HT20, country, inactive time - and board) and what
    needs measuring are kept apart. Adds a five-step procedure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
2026-11-05 Docs: Wi-Fi 2.0 plan revised around official components (third revision)
    Owner's principle of 2026-11-05: build on Espressif's official components,
    no home-grown workarounds. The plan now compares Arduino core 3.3.12 with
    IDF components, ESP-IDF with Arduino as a component, and native IDF, and
    chooses the first: esp_http_server replaces the hand-written web server,
    connection pool, port 81/82 listeners and self-check (the 5-10 s write
    stall disappears structurally); esp_wifi/WiFi with a small host-tested
    product state machine and a FreeRTOS event queue replace the ad-hoc
    timers; wifi_provisioning evaluated and rejected with reasons. netboost
    and the WPA3 wrap stay as fenced exceptions until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
2026-11-05 Docs: Wi-Fi 2.0 plan quality pass (fourth revision)
    Verified against the IDF 5.5 and Arduino 3.3.12 sources: the two
    remaining exceptions (netboost: no SO_SNDBUF in IDF's lwIP, compile-time
    TCP_SND_BUF=5744; wifiwpa3: SAE capability is a compile-time macro in
    WIFI_INIT_CONFIG_DEFAULT) are justified, isolated, switchable and have a
    removal plan; no third exception is allowed.
    The esp_http_server adapter is bounded (one server API per call, request
    lifetime, locking without cycles, async completion on every path, TCP
    keepalive, socket budget, limits). Looks with a phone joined use only the
    known channel; the setup test's channel move is explained by the driver's
    CSA. The 60 s "radio up" rollb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
2026-11-05 Docs: Wi-Fi 2.0 plan final revision, planning closed
    Records the owner's closing decisions: P8, P9, P11, P12 approved with
    their documented limits; P10, P13 deferred; deflate compression of
    downloads removed in Stage 2 (routes, content and formats kept, export
    regression check added); country set with the documented
    esp_wifi_set_country_code("DK", true) instead of "EU" (D26, D27). Adds
    implementer instructions, the status vocabulary built / bench-verified /
    boat-verified (D28), the planning-closed rule (D29), and splits Stage 0
    into physical boat measurements and bench work so Stages 1-3 can proceed
    meanwhile. CLAUDE.md, HANDOVER.md, STATUS.md and TODO.md made consistent.
    No firmware change.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
2026-11-05 Wi-Fi 2.0 Stage 1: AP radio settings, TX power truth, trace fold, link diagnostics, pinned core
    Built, untested on hardware (plan D28).
    - 1a apRadioSetup() (F19): esp_wifi_set_bandwidth(AP, HT20),
    esp_wifi_set_inactive_time(AP, 600), esp_wifi_set_country_code("DK", true)
    only when the driver reports another code (D27), setSleep(false), then the
    TX power (the country resets it). All official esp_wifi calls.
    - 1b applyTxPower(check) compares the driver value exactly (F7: the unset
    20 dBm no longer passes as 19.5); router mode sets country, power save and
    TX power right after the station starts (staRadioSetup); the epoch check
    runs in both modes. Report prints target and driver in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
    [EngineLink.ino, diagnosis.ino, model.h, netreport.ino, serialcmd.ino, wifi.ino]
2026-11-05 Wi-Fi 2.0 Stage 2: esp_http_server, own-origin security, boot self-test, no deflate
    Built, untested on hardware (plan D28). Bench list: plan 9.2.
    - httpd.ino/httpd.h: ESP-IDF esp_http_server on port 80 in its own task
    (core 1, prio idle+5, 8 KB stack, 7 sockets, LRU purge, 5 s send/recv
    timeouts, TCP keepalive 5/5/3, wildcard matching). The Web adapter keeps
    the handlers' web.arg/send/sendHeader/sendContent calls; each maps to one
    server call (httpd_query_key_value, httpd_req_get_hdr_value_str,
    httpd_resp_set_*, httpd_resp_send[_chunk], httpd_req_recv). Only EngineLink
    code: URL decoding and the own-address allow-list (httputil.h, host-tested
    in tools/test_httputil.cpp) - no I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
2026-11-05 Wi-Fi 2.0 Stage 3: wifistate::Machine and its host test (not integrated)
    Host tests only; the firmware does not use the machine yet (Stage 4 waits
    for the Stage 0 gate, plan 9.0). Built, untested on hardware (D28).
    - wifistate.h: the product state machine of plan 6.3 with the interface of
    9.3 (Standalone, Router test, Router join, Router, Router lost; looks,
    router test SETUP/RETURN, back-off 1/5/15 min, D5/D4/D9/D10/D21 rules).
    Pure C++: no Arduino, radio calls or clock reads; 194 lines (<= 220).
    Product logic, no IDF/core counterpart (IDF leaves the reconnect strategy
    to the application, wifi.rst "Wi-Fi Reconnect").
    - Inputs beyond the 9.3 sketch: setupWpa3Only (allowSae for a S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
2026-11-05 EngineLink 0.16.6 development build: version, notes, status docs
    0.16.6 = Wi-Fi 2.0 Stages 1-3, built, untested on hardware (D28). Not a
    release: no merge to main before plan 9.9 (D24).
    - EL_VERSION 0.16.6; docs/releases/v0.16.6.md with what is in it, how to
    install it on the bench without losing data, and the bench list.
    - Plan: status line, section 12.1 implementation findings I1-I7 (prefs body
    limit, series JSON in the server task, project-name check limit, drain of
    refused bodies, curl HEAD, mDNS from handlers, engineMx without the engine
    task), 9.2 Content-Encoding check without HEAD, section 10 wording that
    contradicted 9.0 about Stage 3.
    - STATUS/TODO: the old "no stage bey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
2026-11-05 Wi-Fi 2.0 Stage 2: fixes from the code review (OTA rollback target, socket lifecycle)
    Built, untested on hardware (D28). Plan 12.1 I8/I9.
    - OTA: compare esp_app_desc_t.project_name from the streamed image (first
    0x70 bytes, otaheader.h, host test extended) BEFORE Update.end(), in both
    OTA paths. Switching the boot partition back after end() wrote a second
    NEW otadata entry and made the rejected image the rollback target
    (esp_ota_ops.c, IDF v5.5). otaCheckNewImage() removed.
    - Refused uploads up to 3.2 MB are read to their end so the app gets the
    reason; uploads refused during a GitHub install and vice versa.
    - Early replies (421/403/503) close a connection with an unread body over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
    [httpd.ino, otaheader.h, sdexport.ino, updates.ino, webapi.ino]
2026-11-05 docs(hardware): review EngineLink schematic and record validation checklist
2026-11-05 docs(hardware): audit Gerber layout, isolation, RF keepout and power budget
2026-11-05 docs(hardware): correct antenna assessment after KiCad keepout and cutout screenshots
2026-11-06 docs: add owner v0.16.6 bench Wi-Fi reports and Stage 0 evidence
2026-11-06 docs: record partial on-board verification without closing Stage 0 gate
2026-11-06 Docs: Stage 0 gate assessment of the 2026-11-06 bench reports (plan 13.6.1)
    Analysis only, no code changed. Gate still unclassified; the minimal
    discriminating test is plan 13.6 step 3 with 0.16.6 on the boat. Findings
    on throughput vs round trip, the router beacon losses, stale report fields,
    the /api/sd/info lock hold, the mode-switch lock hold, "/" in the server
    task, the unattributable 503, and the router name in the evidence files.
    TODO lists the owner's next three steps.
    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
2026-11-06 Serial export and Wi-Fi log trace fixes from the 2026-11-05 blocking audit
    - serialSend() returns false after one 2 s stall (also when the port takes
    nothing), serialFile() stops at the first one; the file read and the
    waits run without the engine lock (audit item 1).
    - getWifiTrace() hands back the running total from the same critical
    section, so the SD log never marks an event written it did not copy
    (audit item 6).
    - Plan I10, 13.6.1 (power part numbers from the hardware review), release
    notes, HANDOVER link to issue #161; contract checks extended.
    Built with the pinned core 3.3.12; not run on the board.
    Claude-Session: h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
    [netreport.ino, serialcmd.ino, wifi.ino]
2026-11-08 Router mode: restore the station's 20 MHz and 20 s beacon timeout (plan I14)
    Owner report: on the bench router (IP, -42 dBm) /api/live (~2.5 KB)
    answers every time, but / (110 KB) takes 20.5 s and fails with 5 send
    failures; standalone serves the page at 1048 kB/s.
    Every version up to 0.16.1 (0.13.4: 584 kB/s on the router) set
    esp_wifi_set_bandwidth(WIFI_IF_STA, WIFI_BW_HT20) and
    esp_wifi_set_inactive_time(WIFI_IF_STA, 20). 0.16.2 dropped both; Stage 1
    restored only the AP half (F19). Power save is off, the TCP window boost
    and the server path are the same as in standalone, and a multi-packet
    reply gets through, so the station's lost settings are the documented
    difference. staRadioSetup()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
    [wifi.ino]
2026-11-08 Router diagnostics: true router counters and last signal, SD log context (plan I15)
    Bench build 3 failed on the router (owner, 2026-11-08: /, /api/live and
    .local time out, 1 of 10 pings answered, no report of the running build).
    The router's client table keeps a DHCP lease after a station leaves, so
    the evidence cannot tell "EngineLink left the router" from "associated
    with heavy frame loss"; no router-mode code path leaves the channel or
    puts the radio to sleep.
    The report and /api/diag printed router counters and the last router
    signal/channel that nothing wrote since 0.16.2. Now:
    - onWiFi() writes associations, IP gains/losses, disconnects (drops of a
    live link apart from failed attem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
    [netreport.ino, serialcmd.ino, wifi.ino]
2026-11-08 CI: survive package-server 504s in the compile job
    The compile job failed four times on 2026-11-08 before compiling anything:
    setup-arduino-cli's "1.x" GitHub API lookup and the esp32 toolchain
    download both returned 504. Now the CLI version is exact (1.2.2, the one
    used locally), the pinned core, toolchains and NeoPixel are cached
    (actions/cache, keyed on the pinned versions), and the install is tried up
    to four times with a pause. No build or test step changed; a persistent
    failure still fails the job.
    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
2026-11-08 CI: fetch the core's archives with a fallback to Espressif's mirror
    The retries of 5b3aab9 got the CLI and the Xtensa toolchain through, but
    GitHub kept answering the runners 504 for one release asset, the RISC-V
    toolchain (riscv32-esp-elf 14.2.0_20260121) that the ESP32-S3 build does
    not use but `core install` requires.
    tools/prefetch_arduino_tools.py puts every archive the pinned platform
    needs on this host into arduino-cli's download cache before the install:
    kept if already cached with the index's SHA-256, else downloaded from the
    index's URL and, for a GitHub release asset that fails, from Espressif's
    official mirror (dl.espressif.com/github_assets/...). Every file must
    match the index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
2026-11-08 CI: install arduino-cli from Arduino's server instead of GitHub releases
    setup-arduino-cli failed three times on GitHub 504s (exact version too),
    and GitHub's release downloads still answer 504. arduino-cli 1.2.2 now
    comes from downloads.arduino.cc with retries, checked against a pinned
    SHA-256 (the extracted binary is identical to the one every local build
    of this branch used), and is put on PATH. Together with the archive
    prefetch of b5983ad nothing in the compile job's setup depends on GitHub
    release downloads any more.
    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
2026-11-08 A/B test build: router mode on the Wi-Fi driver's defaults (plan I16)
    Every router run on this board shows one pattern: small answers work,
    then the router's beacons are lost and 49 full scans in 2 min do not find
    it, while the own Wi-Fi started right after hears the phone and the
    router still lists EngineLink: a station that keeps transmitting but
    stops receiving until the driver restarts. The Prism controller works on
    the owner's routers with the driver's defaults (WiFiManager, no
    bandwidth, beacon timeout, country, power-save or TX-power settings).
    EL_STA_DEFAULTS=1 (never released) skips staRadioSetup()'s settings and
    the router-mode TX power and turns modem sleep on, as Prism; nothing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
    [EngineLink.ino, netreport.ino, wifi.ino]
2026-11-09 refactor(network): use official ESP32 STA and TCP defaults, remove custom hooks
2026-11-09 refactor(network): remove obsolete custom Wi-Fi and lwIP driver hooks
2026-11-09 fix(wifi): restore standard STA modem-sleep after AP mode
    [wifi.ino]
2026-11-09 fix(wifi): restore Recovery timestamp removed during WPA3 cleanup
    [EngineLink.ino]
2026-11-09 docs(wifi): preserve full 2026-11-09 post-simplification device report
2026-11-09 docs(wifi): revised Wi-Fi plan 2026-11-09 from evidence and source review
    Replaces the Wi-Fi 2.0 stage plan: two modes plus a named recovery
    mechanism, a three-line documented station profile (power save off,
    country DK in both modes, HT20), removal of the unwired state machine and
    0.15.0 leftovers, and one discriminating bench session instead of further
    A/B builds. Plan only; no firmware change.
    Claude-Session: https://claude.ai/code/session_01PB8f4e3eJHoAtSHsPUAY3C
2026-11-09 EngineLink 0.17.0-rc1: two Wi-Fi modes, documented station profile
    Implements docs/WIFI_PLAN_2026-11-09.md (P1-P7):
    - Station profile after WiFi.mode(WIFI_STA), before begin(): power save off
    (the driver's WIFI_PS_MIN_MODEM default delays reception to the DTIM cycle
    and is a documented cause of unreachable stations), country DK with 802.11d
    in router mode too (it was set only when the AP started), 20 MHz, and the
    all-channel scan so a mesh joins its strongest access point. Everything
    else stays at the driver's defaults. The modem-sleep line of b3ed536 is gone.
    - The fallback to the own Wi-Fi is named a recovery mechanism, not a mode:
    report "Router (router not reached; EngineLin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
2026-11-09 EngineLink 0.17.0-rc2: station on the driver's defaults, as Prism
    The rc1 bench report (home 4G router, 2026-11-09 15:37 build) showed the
    router answering neither authentication nor association requests (reasons
    2, 4, 15 per the Wi-Fi guide's connect phases). The owner's Prism controller
    (same ESP32-S3-WROOM-1 module, WiFiManager over the driver's defaults) joins
    the same router, so router mode now uses exactly its connection path:
    WiFi.mode(WIFI_STA), the core's reconnect, WiFi.begin(), nothing else on the
    station and nothing polling the driver while it connects.
    - wifi.ino: staRadioSetup() removed (power save off, country DK, 20 MHz,
    all-channel scan); the 2 s esp_wifi_sta_get_ap_info(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
2026-11-10 EngineLink 0.17.0-rc3: station power save off, link measured on the device
    After the rc2 report (IP in 2 s on the home router, page timed out, beacons
    lost after 409 s) the whole chain was reviewed (plan section 8). No fault in
    the web server, its checks, routing, tasks or mDNS: the other device's
    packets do not arrive, below HTTP.
    Fixes:
    - Station power save off in every router session. rc2 made no call, so the
    core applied the value stored last: modem sleep on after a start straight
    into router mode, off after the own Wi-Fi had been up.
    - The stored RF calibration (older than the IC5 repair) is discarded once so
    the radio calibrates in full.
    - Host/Origin accept the board's name bar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
    [EngineLink.ino, httpd.h, httpd.ino, httputil.h, netdiag.ino, netreport.ino]
2026-11-10 EngineLink 0.17.0-rc4: rc3 faults fixed, station at 20 MHz, full link record
    The rc3 report (home router): 802.11n 40 MHz negotiated at -47 dBm with power
    save off, 3 of 152 pings to the router answered, 10 web requests through the
    router answered by the server, beacons lost after 302 s, a scan 10 s later
    heard 3 other networks and not the router (plan section 9).
    Faults of rc3, fixed:
    - The own Wi-Fi came on at once on a loss instead of after 2 minutes: the
    fallback timer compared unsigned and the event task can set staDownSince
    after `now` was read. Signed now.
    - The engine task waited 1645 ms for the lock during a driver mode change:
    the lock is let go around every WiFi.mode(); slo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
    [EngineLink.ino, httpd.h, httpd.ino, netdiag.ino, netreport.ino, netstat.h]
2026-11-10 rc4: review fixes in the link record
    Signed millisecond comparisons where another task can stamp a time after
    the loop read its own (end-reason wait, time since the last router request);
    a scan that fails to start is recorded as a failed scan; a session lost and
    regained within one loop pass keeps the driver's reason; a dead-link rejoin
    always offers the other radio profile.
    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
    [netdiag.ino, wifi.ino]
2026-11-10 EngineLink 0.17.0-rc5: the station of the owner's working test sketch
    A plain Arduino sketch on this board (WiFi.mode(WIFI_STA),
    WiFi.setSleep(false), WiFi.begin(), mDNS, WebServer) served a page through
    the home router on 2026-11-10. Router mode now joins with exactly that
    sequence and sets nothing on the radio.
    Removed from rc4: 20 MHz and 802.11g/n on the station and the switch
    between them, the promiscuous radio sample, leaving the router after lost
    pings, the scans after a fallback, the RF calibration erase,
    WiFi.persistent(false). The Wi-Fi starts 1 s after power-on as in the
    sketch.
    Fixed: the core stops reconnecting after code 202 (rc4 stood idle for
    90 s); one plain connect after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
    [EngineLink.ino, netdiag.ino, netreport.ino, netstat.h, wifi.ino]
2026-11-10 EngineLink 0.17.0-rc6: rc5 built with ESP32 core 3.2.0, the working sketch's core
    rc5 timed out on the home router. The owner's plain sketch works there also
    with OPI PSRAM, and it was built with ESP32 Arduino core 3.2.0 (ESP-IDF
    5.4); EngineLink was built with 3.3.12 (ESP-IDF 5.5.5), a different Wi-Fi
    driver, lwIP and PHY library. CI and the contract test now pin 3.2.0.
    One source change: the GitHub certificate bundle is given by address on
    core 3.2 (useBuiltinCACertBundle() exists from 3.3).
    Built and host-tested; not run on the board.
    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
2026-11-10 docs+tools: rc6 result on the board and a Wi-Fi bench sketch
    rc6 (core 3.2.0) failed on the home router like rc3: small answers through
    the router work, the 110 KB page fails, ping replies are late and die out,
    beacons lost after 306 s. Core version and PSRAM are cleared.
    tools/wifi-bench: the owner's working sketch plus a 110 KB page and a
    counted ping, with an optional 802.11g-only profile, to decide between the
    802.11n link, the radio link as such, and EngineLink's own code.
    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
    [wifi_bench.ino]
2026-11-10 wifi-bench: profile 2, low transmit power (8.5 dBm)
    Profile 0 (driver defaults) degraded over 10 minutes on the home router
    (110 KB page 1.8 s -> 16 s); profile 1 (802.11g only) was dead within
    30 s. So neither EngineLink's code nor 802.11n is the cause.
    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
2026-11-10 EngineLink 0.17.0-rc7: a send waits 30 s, core pin back to 3.3.12
    The owner's bench sketch (no EngineLink code) degrades on the home router
    too: the 110 KB page took 1.8 s at first and 16 s after 10 minutes, but was
    still delivered, because Arduino's WebServer waits. EngineLink's server gave
    up after 5 s without progress (rc6: 5 of 5 pages "send failed").
    send_wait_timeout 5 -> 30.
    rc6 on core 3.2.0 failed like 3.3.12, so the project's pin is restored.
    Bench results, the IC5 suspicion and what was considered for the page size
    are in plan section 13.
    Claude-Session: https://claude.ai/code/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
    [EngineLink.ino, httpd.ino]
2026-11-10 Release 0.17.0: Wi-Fi with the plain station, test version
    Released by the owner's decision of 2026-11-10 so that builds can be
    installed with the web installer. Content is 0.17.0-rc7. Not verified on
    the board; router mode on the owner's home router is not fixed.
    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
    [EngineLink.ino]
2026-11-10 Release 0.17.1: router mode joins from a clean start
    0.17.0 on the home router lost its pings within a minute and the beacons
    305 s after the join; the owner's bench sketch kept 117 of 117 pings for two
    minutes. Every EngineLink session so far joined the router after its own
    Wi-Fi had been up; the sketch only ever starts as a station. Choosing the
    router now restarts EngineLink (not during a trip), which starts straight
    into router mode.
    The report names per router session how it was joined, the driver's country
    code and when the last ping under 50 ms was answered.
    Test release for the web installer; not verified on the board.
    Claud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
2026-11-10 Release 0.17.2: the Wi-Fi's buffers stay in internal memory
    0.17.1 stayed on the home router and showed the app, but the router's
    answers took 441-770 ms where the owner's plain sketch (PSRAM off) had
    10-50 ms. With PSRAM on, the core puts Wi-Fi and lwIP buffers in PSRAM
    whenever it has room. EngineLink now takes all PSRAM at start: a 2 MB pool
    of its own (multi_heap) for the frame queue, sample rings and web buffers,
    the rest held as spare, lent back during HTTPS jobs and when internal
    memory runs low.
    Claude-Session: https://claude.ai/code/session_01PB8f4e3eJHoAtSHsPUAY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
2026-11-10 Release 0.17.3: 0.17.2's memory change taken back
    0.17.2 on the board ran out of internal memory (Standalone, 87 s: lowest
    free 0 KB, 109 failed allocations of packet buffers, 161-462 kB/s instead of
    about 650). EngineLink uses too much internal memory itself for the Wi-Fi's
    buffers to fit there too. psram.h/.cpp are removed and all PSRAM users are
    back on ps_malloc; the firmware is 0.17.1's.
    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
    [EngineLink.ino, diagnosis.ino, gearbox.ino, httpd.ino, netreport.ino, updates.ino, webapi.ino]
2026-11-10 Release 0.17.4: the report shows the chip's temperature
    0.17.3 (0.17.1's firmware) in Standalone after a cold power-on gave
    54-121 kB/s a minute after the start and 195-477 kB/s four minutes later;
    the same code gave 580-730 kB/s earlier the same day, memory fine. The
    link changes by itself with the time since power-on.
    The ESP32-S3's internal temperature is read every 5 s and reported: now,
    first reading and highest; per speed test (with its uptime); per 30 s piece
    of a router session. Network code unchanged.
    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
2026-11-10 docs(hardware): import original editable KiCad PCB, schematic and BOM
    Preserve KiCad 8 project, schematic, four-layer PCB, design rules and interactive BOM from the owner's ZIP without modifications; add SHA256 provenance, import guidance and ignore rules. Omit redundant backups, editor locks and footprint cache. Update hardware README and link prior schematic/PCB audits. No firmware changes.
    [ESP32-S3-WROOM-1-N8R8.kicad_pcb, ESP32-S3-WROOM-1-N8R8.kicad_sch]
2026-11-14 Own Wi-Fi picks the quietest channel (1/6/11) by itself
    The slow Standalone link was a busy channel 6, not the board: two modules
    and three firmwares were slow on 6 and fast on 1 at -39 dBm (plan 19).
    - chanpick.h: air-time based choice of 1/6/11 with hysteresis, host test.
    - chanauto.ino: sniffer survey (2 x 250 ms per channel) before the own
    Wi-Fi starts; with no phone joined, a 1 s check every 10 min and a new
    survey after two busy checks. A connected phone is never moved.
    - Default on (NVS apauto), last choice in apchl; apch=0 automatic,
    1/6/11 fixed. Report line "Channel:".
    - Contract: sniffer only in chanauto.ino, never in router mode.
    - Docs: plan section 19, HANDOVER, cold-sta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
    [chanauto.ino, chanpick.h, model.h, netreport.ino, storage.ino, webapi.ino]
